rentommy/2026-fpga-dual-channel-ecg/docs/images/prototype_overview.jpg

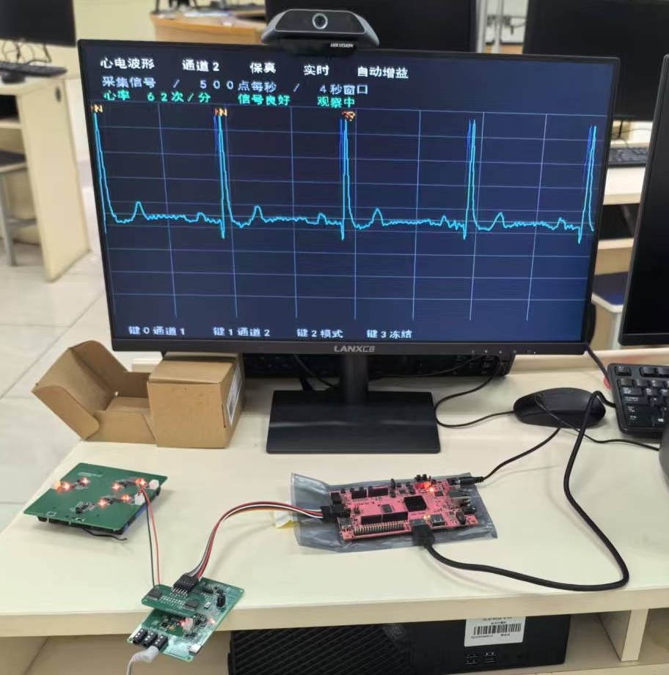
docs/images/prototype_overview.jpg
