rentommy/2026-fpga-dual-channel-ecg/hardware/README.md

# 硬件设计来源快照

acquisition包含现存采集板网表、BOM、Gerber及EDA工程，isolation包含隔离板网表。所有文件按英文路径复制，字节未修改；原文件名映射见file_origin.json。厂商器件手册不重复分发。

这些是工作区最近可找到的设计导出，文件日期不完全一致。尚未确认它们与已经进行人体测试的实物板为同一修订，不能将其表述为“整套硬件已按此版本验收”。隔离板完整PCB/原理图/BOM若不在本快照中，仍需补齐。请在发布前核查BOM/EDA中的团队及制造订单信息。

新增英文归档：acquisition内含两页原理图与PCB图，isolation内含原理图/PCB图/通道分配，power内含独立电源板图。作品现场照片位于docs/images/prototype_overview.jpg。图纸与实物版本的测试边界见技术文档。
