rentommy/2026-fpga-dual-channel-ecg/docs/README.md

# Project documentation

- [Technical report in Chinese](technical_report_zh.docx)
- [AMD poster in English](posters/amd_poster_en.pptx)
- [AMD poster in Chinese](posters/amd_poster_zh.pptx)
- [Prototype photograph](images/prototype_overview.jpg)
- [Build and reproduction guide](reproduce.md)
- [Hardware interfaces](hardware.md)
- [Third-party notices](third_party.md)

Repository paths and filenames use English ASCII. Chinese documents retain their original language. Source-to-public filename mappings are recorded in publication_file_map.json. Schematics and PCB images are in ../hardware/acquisition, ../hardware/isolation and ../hardware/power. The standalone power-board design and two-cell acquisition-board supply are separate design snapshots.
