rentommy/2026-fpga-dual-channel-ecg/hardware/power/README.md

# Standalone power board

Schematic and PCB layout supplied with the project. These are design exports, not evidence of rated-load, efficiency or safety certification tests. They are distinct from the acquisition-board two-cell charging design.
