rentommy/2026-fpga-dual-channel-ecg/report/submission_audit.md

# GitHub提交准备与项目完整性审查

## 结论

已按用户提供的2026 AMD指南自主选题初级组整理独立提交候选：`D:/ecg_fpga/submission/ecg_fpga`。不要直接将整个`D:/ecg_fpga`工作目录上传。原有工程、人体原始数据、录屏、训练数据库与工具缓存保留本地，没有重写Git历史或推送远端。

候选包含src、sim、build、board、data、skill、report等指南推荐目录，另有docs/model/hardware。路径采用英文小写、数字、下划线/连字符，保留指南示例中的README.md/LICENSE惯例。内容可以中文，历史资料中的原工作区路径仅作为来源说明。

## 本次完成

- 更新README，纠正实时/回放状态、PL/ARM分工、延迟定义和验收边界。
- 整理当前ECG6源码、bit/hwh、部署脚本及模型权重，保留兼容预编译和新构建模块层级的运行入口。
- 补从空工程创建PS、SPI、滤波、视频和卷积的构建入口，修复BD打开时IP目录无法刷新导致卷积IP找不到的问题。
- 生成60秒合成滤波输入及黄金结果，公开模型合成输入替代个人心电。用户明确要求人体原始记录保留本地。
- 补独立模型网络定义、best.pt导出及PyTorch/NumPy比较入口；全量训练仅保存来源快照，尚不能完整独立复现。
- skill目录不再为空：报告门控、只读Overlay ABI检查、缓存所有权与分层排错经验均有适用范围、来源、使用方法和失效条件。
- 硬件网表/BOM/Gerber/EDA改用英文路径归档为设计快照，并明确版本不一致与实物对应关系待核查。
- 补大模型协作回溯摘记，保留用户纠正与失败过程，不补造逐字对话或验收结果。

## 本次验证

| 检查 | 结果 | 边界 |
|---|---|---|
| 英文路径/大小/明显凭据/Python语法 | 通过 | 静态检查，不是全面隐私审计 |
| 滤波核C测试 | 通过，合成60秒输入最大误差约2.2码、RMS约0.583码 | 不等同于历史实测输入结果 |
| 顶层C测试 | 通过，8逻辑通道、两路径与逐通道延迟配置 | 不代表8路物理ADC |
| RTL视频/SPI/FIFO/SW0 | 三组测试通过 | 现场信号质量仍依赖供电/电极 |
| 技能包/报告解析 | 正确/错误/缺失证据场景自测通过 | HLS解析自测输出是虚构fixture，不能当作C/RTL协同仿真通过证据 |
| 模型独立导出 | 4组合成输入，PyTorch/NumPy最大logit误差约9.54e-7 | 不是识别准确率 |
| 空工程BD集成 | 通过，完全不打开旧xpr | 使用既有导出HLS IP；未重新跑HLS至bit完整链路 |

## 尚未完成，建议按顺序处理

1. **完整干净构建**：已从空目录完成HLS综合、IP导出、bit/hwh及通过的时序报告；新bit上板待验收。
2. **最终整机验收**：固定供电后做长时真实采集，保存无丢帧/无坏帧与帧率记录；确认增益修复后的上下波形和最新版本断电自启动。此前约30秒恢复检查不是长时验证。
3. **硬件版本与资料**：确认归档的网表、BOM、Gerber、EDA与实际实物同版，补隔离板完整工程；BOM/EDA制造订单与个人信息再审查。
4. **公开发布检查**：TUL板卡文件再分发来源/许可尚需确认，不能套用原创MIT。Digilent依赖已补上游MIT声明。现有Git历史跟踪过`data/source/ecg_60s_500sps.txt`与`ecg_val_60s_500sps.txt`及相关数据；新候选排除个人原始记录不会抹掉旧历史。未经用户确认不执行历史重写/强推。
5. **训练复现与更多对照**：如需要展示完整训练流程，应补齐旧实验划分/基线依赖及数据库路径参数化。公开合成输入的板端FPGA对照尚未运行，C/RTL协同仿真也未验收；现有C/RTL独立验证已满足“仿真或验证证据”的基础范围。
6. **最终材料**：指南第六章要求按AMD模板提供一页英文海报，决赛打印版不含队伍信息。现有海报含姓名，需制作匿名版并更新最终图。后续官方评分细则/报名后台材料要求仍需最终核对。

现阶段可把本目录作为候选进行本地审查或私有备份；不应声称比赛最终材料全部完成。公共发布前先解决许可和旧历史数据检查，比赛提交前完成构建和整机验证。没有测量的临床准确率、整机功耗、端到端时延不填推算数。
