rentommy/2026-fpga-dual-channel-ecg/report/submission_checklist.md

# AMD自主选题初级组提交核查

依据用户提供指南3.3.3–3.3.5及第六章（PDF物理页23–25、28）。本清单不是后续官方评分细则或报名后台要求的替代。

| 要求 | 当前情况 | 剩余工作 |
|---|---|---|
| 指定器件与板级运行 | PYNQ-Z2/XC7Z020已声明，实时采集/推理/HDMI有实测 | 固定电源后长时连续运行，保存新日志 |
| RTL/HLS/PS源码及工程 | 当前源码、预编译bit/hwh已包含 | 已从空目录完整重建通过；新bit上板待验收 |
| 仿真/参考对照 | 滤波C测试、视频/SPI/SW0验证源码、49拍结果和合成向量 | 保存公开合成模型向量的板端FPGA对照结果；C/RTL协同仿真仍未验收 |
| 综合实现与性能对比 | 最新时序/资源报告、窄范围ARM基线对照 | 补统一条件的多心拍基线对照与端到端延迟测量；功耗如未测勿声称 |
| 技能包 | 已补README、报告门控、Overlay检查及缓存工作流 | 换题目/换板卡的复用验证尚未实测 |
| 大模型协作记录 | 历史日志及11月4日补充，包含用户提示与纠错 | 日志是回溯摘记，不伪装完整逐字原始记录 |
| 英文规范路径 | 提交候选使用ASCII；保留README.md/LICENSE惯例 | 发布审查脚本须通过，无凭据、私有录制、超大文件 |
| 开源许可 | 原创代码MIT，Digilent许可保留 | TUL板卡文件来源/再分发许可需确认，不能自动套用MIT |
| 原理图/PCB/BOM | hardware内已按英文归档现有网表、BOM、Gerber及EDA快照 | 确认与实际已制作板卡同版，补隔离板完整工程，检查制造订单/个人信息；器件手册不重复发布 |
| 模型源码与权重 | 已选定权重、配置、推理与训练来源快照 | 全量训练仍依赖旧实验文件和数据库目录，未独立复现 |
| 一页英文海报 | 英文及中文PPT已归档docs/posters | 决赛需按AMD模板去除队伍信息、补最终实测图，A4彩印；中文版本仅辅助 |
| 自启动现场验收 | 旧版本用户曾确认断电启动 | 最新双路与增益修复版断电自动启动待用户实测 |

代码可以先作为候选备份到私人仓库，但不得把未验证项勾成完成。公开发布前优先确认第三方许可、去除本地敏感数据，核对本次干净构建证据。比赛最终提交前还需核对独立发布的官方评分细则与报名后台材料要求。
