rentommy/2026-fpga-dual-channel-ecg/hardware/acquisition/netlist_20261023.txt

$PACKAGES
AUDIO-TH_XKB_PJ-320A ! AUDIO-TH_XKB_PJ-320A ! '{Value}' ; CN2 CN3 CN4 
C0603 ! C0603 ! '1.5nF' ; C14 
C0603 ! C0603 ! '4.7nF' ; C1 C2 C3 C12 C13 
C0603 ! C0603 ! 100nF ; C5 C7 C9 C21 C27 C34 C36 C38 
C0603 ! C0603 ! 10nF ; C23 C28 C30 
C0603 ! C0603 ! 10pF ; C19 C20 
C0603 ! C0603 ! 10uF ; C4 C6 C8 C26 C32 C33 C41 C42 C47 C50 C52 
C0603 ! C0603 ! 1uF ; C11 C15 C16 C22 C24 C25 C29 C31 C35 C37 C39 C40 C46 
C0603 ! C0603 ! 20pF ; C17 C18 
C0603 ! C0603 ! 22uF ; C44 C45 C51 
C0603 ! C0603 ! 47nF ; C48 
C0805 ! C0805 ! '4.7uF' ; C49 
CASE-A_3216 ! CASE-A_3216 ! 1uF ; C10 
CONN-TH_2P-P2.50_HC-XH-2A-G ! CONN-TH_2P-P2.50_HC-XH-2A-G ! '{Value}' ; CN1 
,
        CONN-TH_2P-P2.50_HX-2.54MM-2P-ZZ-MS ! CONN-TH_2P-P2.50_HX-2.54MM-2P-ZZ-MS ! '{Value}' ,
        ; CN7 
,
        CRYSTAL-SMD_4P-L3.2-W2.5-BL_SIT8008BI ! CRYSTAL-SMD_4P-L3.2-W2.5-BL_SIT8008BI ! 8MHz ,
        ; X1 
HDR-TH_16P-P2.54-V-M-2 ! HDR-TH_16P-P2.54-V-M-2 ! '{Value}' ; H2 H3 
,
        HDR-TH_18P-P2.54-V-M-R2-C9-S2.54 ! HDR-TH_18P-P2.54-V-M-R2-C9-S2.54 ! '{Value}' ,
        ; H5 
HDR-TH_2P-P2.54-V-M ! HDR-TH_2P-P2.54-V-M ! '{Value}' ; H1 
HDR-TH_4P-P2.54-V-M ! HDR-TH_4P-P2.54-V-M ! '{Value}' ; H7 
,
        HDR-TH_6P-P2.54-V-M-R2-C3-S2.54-2 ! HDR-TH_6P-P2.54-V-M-R2-C3-S2.54-2 ! '{Value}' ,
        ; H4 H6 
IND-SMD_L2.0-W1.2_PCT201210 ! IND-SMD_L2.0-W1.2_PCT201210 ! 1uH ; L2 
L0805 ! L0805 ! '{Value}' ; L1 
L1008 ! L1008 ! '2.2uH' ; L3 
LED_0603 ! LED_0603 ! '{Value}' ; LED1 LED2 LED3 LED4 
LED0603-RD_RED ! LED0603-RD_RED ! '{Value}' ; LED5 LED6 
,
        LQFP-48_L7.0-W7.0-P0.50-LS9.0-BL ! LQFP-48_L7.0-W7.0-P0.50-LS9.0-BL ! '{Value}' ,
        ; U5 
OSC-SMD_L3.2-W1.5 ! OSC-SMD_L3.2-W1.5 ! '32.768kHz' ; X2 
R0603 ! R0603 ! '100kΩ' ; R7 R8 R9 R11 R12 R13 R14 R15 R16 R38 
R0603 ! R0603 ! '10kΩ' ; R17 R18 R32 R33 R34 R35 R36 R37 
R0603 ! R0603 ! '1MΩ' ; R10 
R0603 ! R0603 ! '30.1kΩ' ; R42 
R0603 ! R0603 ! '383Ω' ; R39 
R0603 ! R0603 ! '5.1K' ; R26 R27 R30 R31 
R0603 ! R0603 ! '5.23kΩ' ; R43 
R0603 ! R0603 ! '51kΩ' ; R1 R2 R3 R4 R5 R6 
R0603 ! R0603 ! 10 ; R22 
R0603 ! R0603 ! 10K ; R19 R20 R21 R25 
R0603 ! R0603 ! 1K ; R28 R29 
R0603 ! R0603 ! 2K ; R23 R24 
SOIC-8_L4.9-W3.9-P1.27-LS6.0-BL ! SOIC-8_L4.9-W3.9-P1.27-LS6.0-BL ! '{Value}' ,
        ; U8 
,
        SOT-23-5_L2.9-W1.6-P0.95-LS2.8-BR ! SOT-23-5_L2.9-W1.6-P0.95-LS2.8-BR ! '{Value}' ,
        ; U3 U6 U7 
,
        SW-SMD_L6.0-W3.3-LS8.0_TS-1101-C-W ! SW-SMD_L6.0-W3.3-LS8.0_TS-1101-C-W ! '{Value}' ,
        ; SW1 
TH-2_103AT-2 ! TH-2_103AT-2 ! '{Value}' ; R41 
,
        TQFN-16_L3.0-W3.0-P0.50-BL-EP1.7 ! TQFN-16_L3.0-W3.0-P0.50-BL-EP1.7 ! '{Value}' ,
        ; U2 
,
        TQFP-32_L5.0-W5.0-P0.50-LS7.0-BL ! TQFP-32_L5.0-W5.0-P0.50-LS7.0-BL ! '{Value}' ,
        ; U1 
,
        TYPE-C-SMD_LAIL-TYPE-C-16PIN-08-WT ! TYPE-C-SMD_LAIL-TYPE-C-16PIN-08-WT ! '{Value}' ,
        ; USB1 USB2 
,
        VFQFPN-24_L4.0-W4.0-P0.50-BL-EP2.8 ! VFQFPN-24_L4.0-W4.0-P0.50-BL-EP2.8 ! '{Value}' ,
        ; U10 
WSON-8_L2.0-W2.0-P0.50-TL-EP ! WSON-8_L2.0-W2.0-P0.50-TL-EP ! '{Value}' ; U9 
$A_PROPERTIES
$NETS
'-D' ; U10.1 USB2.A7 USB2.B7 
'+5V' ; C16.2 C25.2 C32.1 C33.1 CN1.1 H1.1 U6.1 U6.3 U7.1 U7.3 
'+D' ; U10.24 USB2.A6 USB2.B6 
'$1N14' ; CN4.2 CN4.5 R2.1 
'$1N144' ; LED1.1 R23.1 
'$1N145' ; LED2.1 R24.1 
'$1N19' ; CN2.2 CN2.5 R4.1 
'$1N198' ; H6.4 R21.1 
'$1N201' ; H6.3 R20.2 
'$1N208' ; C22.1 R22.2 U5.9 
'$1N351' ; CN3.3 R5.1 
'$1N353' ; CN2.3 R3.1 
'$1N355' ; CN4.3 R1.1 
'$1N376' ; CN3.5 
'$1N377' ; CN3.2 R6.1 
'$1N81' ; R25.1 U1.17 
'$2N127' ; L3.1 U9.7 
'$2N128' ; C51.1 H1.2 L3.2 R38.1 U9.6 
'$2N18' ; R26.2 USB1.A5 
'$2N195' ; LED5.2 R33.2 
'$2N24' ; R27.2 USB1.B5 
'$2N29' ; C34.2 C35.2 U2.6 
'$2N44' ; LED3.2 R28.1 
'$2N45' ; LED4.2 R29.1 
'$2N52' ; R31.2 USB2.B5 
'$2N57' ; R30.2 USB2.A5 
'3.3V1' ; C23.2 C24.2 C26.1 C27.2 C28.2 C29.2 C30.2 C31.2 H4.1 H4.3 H4.5 H5.10 ,
        H6.1 H6.2 H7.4 LED1.2 R19.2 R22.1 R32.1 R33.1 R34.1 R35.2 R36.2 R37.2 ,
        U5.1 U5.24 U5.36 U5.48 U7.5 U8.1 
'3.3VA' ; C4.2 C5.2 L1.2 R12.1 U1.12 
'3.3VD' ; C6.2 C7.2 C15.2 H5.9 L1.1 LED2.2 R15.1 R16.1 U1.14 U1.23 U6.5 
'5_V' ; C36.2 C37.2 C40.2 C42.1 U2.3 U2.9 U3.1 U3.3 USB1.A4B9 USB1.B4A9 
'CS#' ; H5.13 R15.2 U1.18 
'D-' ; U2.8 USB1.A7 USB1.B7 
'D+' ; U2.7 USB1.A6 USB1.B6 
'DRDY#' ; H5.3 U1.22 
'GPIO1/RCLK1' ; R18.2 U1.26 
'GPIO1/RCLK2' ; R17.2 U1.25 
'PWDN#/RESET#' ; H5.17 R13.2 U1.15 
'RLDIN/RLDREF' ; R11.2 R12.2 U1.29 
3V3 ; C38.2 C39.2 C41.1 R28.2 R29.2 U2.1 U3.5 U8.8 
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
RST ; C21.2 R19.1 SW1.1 U5.7 
RXD ; LED4.1 U2.5 U8.6 
SCLK ; H5.5 U1.20 
START ; H5.15 R14.2 U1.16 
STAT ; LED5.1 U10.2 
SW ; C48.1 L2.2 U10.17 U10.18 
TS ; R41.2 R42.1 R43.2 U10.7 
TXD ; LED3.1 U2.4 U8.7 
VCAP1 ; C10.2 U1.11 
VCAP2 ; C11.1 U1.27 
VREFP ; C8.1 C9.1 U1.9 
$SCHEDULE
$END
