rentommy/2026-fpga-dual-channel-ecg/report/llm_log/2026-10-23.md

# 大模型协作记录 2026-10-23

整理日期：2026-10-23。协作方：用户与GPT／Codex。根据本次会话、项目报告及真实板上输出整理；跨日复位修复按事件连续记录，不补造未保存的逐条时间。

## 1. 用户配合重启，完成修复后的最小板上链路

用户确认板卡重新开机，并要求继续。模型核对修复版bit／hwh哈希，再执行控制读取、单点零输入、完整记录分块回放。此次控制返回 `0x4`，单点输入得到八通道双通路全零输出，首次控制访问卡死问题消除。

| 板上检查 | 结果 |
|---|---|
| 输入 | 30034点单列记录，复制至8通道 |
| 分块 | 500点、4096点，两次仅首块复位 |
| 参考比对 | 跳过543点，诊断配置通道最大误差3.28984码、RMS 0.698013码 |
| 状态连续性 | 两次完整 `[30034,8,2]` 输出逐点完全相同 |
| 结果取回 | ZIP哈希／完整性及本地NPY复算通过 |

ch2／ch3的path0按现行配置为快通路，未纳入诊断浮点参考比较。板上环境为PYNQ-Z2、PYNQ 3.1.1、Python 3.10.4；系统时钟仍显示2025年，不能把Notebook检查点时间当作实际执行日期。

证据：[实现及修复报告](../history/implementation_2026-10-22.md)、`board/results/resetfix/`、`board/results/ecg_board_results_resetfix_20261022.zip`。这是文件回放，不是实时ADC采集。

## 2. 用户要求不同通道激励，补上原测试覆盖缺口

原先所有通道送同一波形，即使输出一致，也可能漏掉错误复制同一路结果的缺陷。用户要求不同通道测试后，模型增加4096点×8通道混合输入：冲激、5Hz、17Hz、阶跃、50Hz、有界随机、周期脉冲和零哨兵；输入峰值120000码。

主机参考逐通道调用同一份定点核心，不经过AXI顶层；板上检查全部样本，包括启动期。20项检查全通过：

- 混合输出对定点参考逐点一致，最大差0码；零哨兵通道两路全零。
- 8组逐通道单独激励，其他7通道两路均保持零；活动通道对照通过。
- 不规则分块 `[1,7,319,320,321,500,997]` 与整块一致。
- 其他记录之后重新复位，首轮结果可复现。

这验证指定向量下的数字通道隔离及状态管理；同代码定点参考不是独立浮点算法，也不证明模拟串扰或任意满量程输入正确。证据：[通道测试报告](../history/channel_test_2026-10-23.md)、`board/results/channel_test_20261023/`。

## 3. 用户补充STM32源码，时钟判断落到实际编译文件

用户说明PWDN／RESET为复用脚、DVDD为3.3V、SPI经过数字隔离，并提供 `stm32文件/`，要求确认时钟。模型查看Keil工程选择，确认实际编译 `Core/Src/main.c`，不是旁边的 `main2.c`。

核对结果：HSE8MHz×9得到72MHz；APB2为72MHz，SPI1分频128，SCLK562.5kHz；CPOL0、CPHA1，即Mode1。`CONFIG1=0x02` 对应当前500SPS配置，`CONFIG2=0xA0` 启用内部基准且CLK_EN=0。

源码关于时钟分频的注释不足以证明内部时钟被选择：`LOFF_STAT.CLK_DIV=0` 规定分频，真正内部／外部源由硬件CLKSEL决定。未提供原理图，不能宣称实际CLKSEL接法已确认。沿用旧采集板时先保留其既有CLKSEL／CLK配置。

另发现旧程序 `CH1SET=0x81`，CH1关闭，仅CH2有效，并输出帧中CH2单列；不能把旧串口记录当双通道同步输出。证据：[时钟及接线核查](../history/ads1292_wiring_2026-10-23.md)。

## 4. 用户确定连接方案，并提出HDMI与按钮需求

用户询问是否要购买Pmod A连接器，要求生成比特流、通过HDMI显示波形，并用板载按键选择通道。随后澄清隔离器HOST侧尚未设计，显示器还没买。

因此本次固定PYNQ现有Pmod A插座的7根信号加HOST地分配，新隔离板可做2×6、2.54mm公头；隔离方向为五路去、两路回。模型整理接线表、供电和两侧地边界，避免把数字隔离后的HOST地跨接到采集侧。

真实采集与显示画面的验收依赖后续硬件，本次先实现完整逻辑、仿真及合成数据上板演示。上述需求和硬件条件来自用户；SPI状态机、驱动和显示实现由模型编写，TMDS编码采用Digilent官方 `rgb2dvi` IP并保留来源及许可证记录。

## 5. 新增SPI、FIFO、显示与按键功能

新版本保持滤波算法不变，增加Mode1 SPI主机、手动寄存器交易、DRDY自动读取、1024帧FIFO、帧头／溢出计数，以及两路24位符号扩展数据。100MHz下SCLK约561.798kHz，接近旧固件频率。运行程序提供demo、ADC内部测试信号、真实ADC三种来源，默认demo不发送ADC命令。

视频为640×480@60Hz，四秒波形窗口、自动纵轴、CH1／CH2及DIAG／FAST选择。BTN0选CH1，BTN1选CH2，BTN2切通路，BTN3冻结／恢复；约20ms消抖。PS约10Hz更新波形，PL60Hz扫描，不把这些刷新率描述成实测端到端延迟。

产物包括 `src/rtl/` 中SPI／AXI／视频模块、`board/run_scope.py`、构建脚本、XDC、使用指南及 `board/scope/ecg_scope.bit/.hwh`。现版没有全帧双缓冲，可能短暂撕裂。

## 6. 本轮实现中的失败与修正

| 现象／错误 | 定位与修正 | 验证依据 |
|---|---|---|
| 模块引用构建找不到字体包含文件 | 将 `.vh` 显式加入工程 | 后续综合成功 |
| XDC里使用任意Tcl循环，约束未按预期接受 | 改成逐项 `set_property` | 最终引脚与实现报告 |
| 时钟向导按外部时钟输入形式配置 | FCLK内部输入改为 `No_buffer` | 保存BD／HWH及后续实现 |
| 首次完整scope布线setup为−0.238ns | 导出程序拒绝发布；物理优化及重布线 | 最终setup +0.041ns、hold +0.023ns |
| 重新打开工程未先登记板文件库 | 后续打开脚本先设置repo并恢复board_part | 元数据重新导出日志 |
| BD导出脚本早于最终配置 | 从保存的最终BD重新生成 | `scope_refresh.log` |

旧引脚ZIP也重新打包，避免继续分发早期无效XDC。最终采用修改后的产物，未把时序失败的首版bit当成成功发布。DRC仍保留建议性警告，未通过关闭规则隐藏问题。

## 7. 新版本的仿真、实现及板上结果

RTL自检覆盖AXI地址／数据先后顺序及背压、SPI Mode1字节序、FIFO读写／溢出／坏帧、按钮消抖与显示选择；视频仿真验证完整307200像素帧及通道／通路／冻结bank。两张预览由真实RTL渲染，但不是显示器照片。

最终实现100MHz核心、25.2MHz像素、126MHz串行时钟；LUT6751、FF9665、DSP1、BRAM Tile17。setup +0.041ns、hold +0.023ns，内部未约束端点及无时钟端点均为0；DRC无Error／Critical Warning，仍有8项Warning。隔离器规格尚未确定，外部GPIO电气时序不能据此全部验收。

新bit／hwh上传后核对哈希，板上执行：

| 检查 | 实际结果 |
|---|---|
| 30034点×8通道×2通路回放 | PASS，最大误差3.28984码、RMS0.698013码 |
| 新增AXI标识与8种UI状态读写 | PASS |
| 合成双通道演示 | 各4000点，约8秒，无程序错误 |
| ADC错误计数 | 演示模式下溢出0、坏帧0；不代表真实ADC链路已验 |
| 实物HDMI／ADC／按键实按 | 未测试 |

HPD读值为1，但用户明确没有显示器，故只记录原始值，不认定连接或出图成功。演示结束冻结最后波形，重启后需重新运行，没有安装开机自启。

证据：[构建与验收报告](../history/scope_build_2026-10-23.md)、接线运行指南（原工作区引用：`../../board/SCOPE_GUIDE.md`，未随此公共候选发布）、`board/scope/build_manifest.json`、`board/scope/board_acceptance.json`及页面截图。发布包为 `board/ecg_scope_20261023.zip`，板上Notebook为 `ECG_Scope_Start_20261023.ipynb`。

## 8. 用户要求补齐协作日志

用户指出此前Claude尚有未整理内容，要求从已提供的旧对话补充。模型复查旧转录和现有日志，新增10-20（日期推定）、10-21、10-22、10-23记录及目录索引；保留原始转录、原有十份日志，不补造隐藏段或把待办当成果。

当前仍需隔离器HOST侧设计、真实ADC内部测试及外部输入、物理按键、实体HDMI画面、PYNQ推理及完整应用验收。现阶段完成的是滤波核心板上回放、指定向量通道验证、新版显示与采集逻辑的实现／仿真和演示链路，并非完整竞赛作品全部闭环。

## 9. 新增两块板网表后的设计检查

用户提供采集板、隔离板网表，确认U6/H5同号直接对插，并补充采集板U6/U7为TPS7A2033PDBVR、U8为ISO6521FDR。模型发现隔离板四个VCC脚只经电容接电源，缺少直流供电；全针插接又经H5.1/H5.2同一GND旁路新隔离器，并将PYNQ输出接回原STM32输出、并接两路3.3V。

七根隔离信号方向本身正确，但新设计Side1=ADC、Side2=HOST，与先前示例相反，不能混用侧别。提出保留采集板H5奇数脚，隔离板U6偶数脚全部不接HOST网络的方案；Pmod公头使用CAD交错编号，几何映射仍待封装图核查。

新网表还补齐时钟证据：ADS1292 CLKSEL接DVDD，选择内部标称512kHz。采集板两颗LDO脚位及U8串口方向核对一致；U8属于功能隔离器，不能当作增强绝缘。完整发现、修正表及原始连接证据见[网表检查报告](../history/netlist_review_2026-10-23.md)。原始网表未改写、未执行真实上电，需用户在原理图修改后重导验证。

用户随后更新网表，并明确暂不要求STM32隔离兼容、不会同时使用两台主机。第二版确认四个电源／去耦问题已修正；U6/H5全针插接的地线旁路和HOST电源回接仍存在，不受是否运行STM32影响。模型将建议收窄为断开隔离板U6全部偶数脚、保留奇数脚及Pmod连接，不要求添加双主机切换电路。见[第二版复查](../history/netlist_review_2026-10-23_v2.md)。

## 10. 根目录文件整理

用户要求整理直接放在项目根目录的文件。两条有效HLS入口移至src/hls，并增加根据脚本位置定位根目录的前缀；七条历史尝试原样归档old/hls_attempts；NA下PS7报告移至build/reports。已存在的HLS组件目录因被Vivado引用而保留原位，移动清单与校验见[文件整理记录](../history/organization_2026-10-23.md)。本次不重新综合或加载板卡。

## 11. 第三版隔离网表复查

后续用户取消隔离板全部STM32支路及SW2，保留U6采集侧偶数脚、奇数脚全部NC。最新网表的供电去耦、七信号方向、主机侧不回接STM32均检查通过；仍以换面后的真实针号对应和PCB隔离边界核对为条件，无需为当前PYNQ用途修改采集板GND。见[简化版复查](../history/netlist_review_pynq_2026-10-23.md)。

用户随后明确U6换面安装，有意交换方向，并排除本次STM32隔离模式。模型修正此前同号对插假设：若实际逐对奇偶交换，采集侧九根连接正确，不能再要求按旧表交换回去。当前只保留PYNQ用途所需检查：SW2电源触点断开、Pmod侧不经现有STM32引脚支路跨回采集侧，以及真实封装映射确认；未来割地不能当作现有网表已隔离的证据。

四个供电去耦仍正确，U6奇偶列却整体交换，并增加SW2。按此前同号对插约定，ADC的DRDY/DOUT会接到隔离器HOST输出，SW2若连通1—2还会并接HOST与ADC电源。模型保留“如果封装／实际针号对应发生变化则需重新确认”的条件，没有只凭网表猜测新物理对接关系，见[第三版网表复查](../history/netlist_review_2026-10-23_v3.md)。
