rentommy/2026-fpga-dual-channel-ecg/report/llm_log/2026-10-25.md

# 大模型协作记录 2026-10-25

用户更新采集板网表并提供BQ25882、TPS62163手册，要求检查新原理图。模型逐项核对U4的25个球位、U9含热焊盘的9个焊盘、主要外围及与旧ADC／STM32和隔离板的连接，并查看手册引脚图与典型电路。

发现GND2（新充电／降压／电池）与GND（ADC／STM32负载）没有连接，但+5V输出跨两网供电，因此缺少明确回流，是必须修正的问题。CN1与降压输出直接并联；用户澄清CN1只用于后级测试，模型据此将要求收窄为测试时物理断开降压输出，不要求增加自动双电源模式。

用户补充电池为2串、标称7.4V、1200mAh且带保护板。允许充电电流及均衡能力仍未知，不能因有保护板就认定充电参数适配。模型核对CE被10k上拉、现有固件尚未实现BQ25882/I2C控制，区分“接法错误”与“默认禁止充电但需软件主动使能”。R32=1.1k控制USB输入限流，典型约0.986A，不是固定电池充电电流。

确认TPS62163固定5V版本的FB接地正确，不按可调版误要求添加分压。确认TS分压与参考拓扑一致，保留电感额定电流、电容偏压降额、BGA方向、Kelvin走线、散热及布局的待核查边界。

完整检查与逐针证据在[新采集板电源检查](../history/acquisition_power_review_2026-10-25.md)及同名JSON。未改原始网表或固件，未通电或充电，不把静态检查写成实物验收。

用户随后更新网表：合并采集侧GND2/GND，新增H1将降压本地输出与CN1后级测试网分开。模型重新检查25球／9焊盘、地网和C51/VOS，确认修正正确，断开H1时降压本地输出电容和反馈仍完整。主要连接检查通过，可以进入BOM及PCB核对；保留充电控制、料号额定、物理布局和上电验证边界。见[第二版复查](../history/acquisition_power_review_2026-10-25_v2.md)。
