rentommy/2026-fpga-dual-channel-ecg/report/history/design_phase1.md

# 阶段一：滤波链结构与定点格式的确定

> 日期：2026-09-30
> 这一章对应指南 3.3.5.3 里的"软硬件划分依据"和"优化过程"，
> 也是"把设计过程中的判断依据写进报告，而不只是呈现结果"这条要求。

> **⚠️ 本章记录的是阶段一的链路，部分结论已在 `design_phase2.md` 中被推翻。**
> 读之前请先看 `design_phase2.md` §0 的对照表。具体地：
>
> - §1 定下的验收指标（平均心拍模板相关）**已作废** —— 它对基线漂移和幅度都盲，见阶段二 §4
> - §2.1 的移位级联直流阻断**已被取代** —— 改用矩形窗基线估计 + 延迟补偿，见阶段二 §3
> - §3 "定稿配置的验收"里的数字对应**旧链路**，现行定稿的验收表在阶段二 §5
> - §2.0 时间预算、§2.2 陷波 Q、§2.3 系数位宽、§2.4 FIR 抽头数**仍然有效**，一个数都没动
>
> 本章不做修改，保留作决策过程的记录 —— 优化过程本身是评分项。

所有数字都来自 `sim/` 下的三个脚本，跑在同一份 60 秒真人实测数据
（`data/source/ecg_60s_500sps.txt`，ADS1292 采集，500 SPS）上，可复现。

数据分三种用途，不要混淆：

| 数据 | 用途 | 出现在 |
|---|---|---|
| **实测原始数据** | 结构选型、**最终验收** | `data/input_raw.txt` + `golden_float.txt`，HLS 三级比对全程用它 |
| 实测数据 + 单频注入 | **参数扫描**（扫出 k、级数、Q 的边界） | 只在 `decide_dc_block.py` 内部，不进测试向量 |
| 合成退化输入 | 抓实现错误（系数装反、某级没接上） | `testcase_impulse.txt`、`testcase_50hz.txt` |

注入数据**一行都没有进过测试向量**。验收标准全部建立在实测数据上。

---

## 1. 为什么不能直接把原来的滤波链搬到硬件

上位机原来用 `scipy.signal.sosfiltfilt` —— 正反各滤一遍，零相移，QRS 不偏移。

**硬件做不到。** 反向滤需要先拿到整段数据，实时链路里数据一个一个来，
永远拿不到"后面的数据"。所以硬件必须是单向（因果）滤波。

这一步换掉之后，还带来一个连带问题：**不能再用全局相关系数验收**。
单向 IIR 的相位失真随频率变化，不是一个固定延迟，平移多少都对不齐：

| 链路 | 与零相移参考的全局相关 r |
|---|---|
| 原版结构改单向 `sosfilt` | 0.589 |
| 硬件三级链路 | 0.64 ～ 0.74 |

r 只有 0.6 并不说明波形被毁了。改用**按 R 波对齐后的平均心拍模板相关**
才能反映真正在乎的东西——P-QRS-T 形态有没有被破坏。
验收指标因此定为：QRS 幅度误差、心率、检出心拍数、心拍形态相关，
以及最终的模型判读是否一致。

---

## 2. 三级结构，按硬件代价从小到大排

| 级 | 实现 | 每通道每采样点的乘法**次数** |
|---|---|---|
| ① 直流阻断（去基线漂移） | 移位式一阶高通，级联 2 级 | **0** |
| ② 50Hz 陷波 | 二阶 biquad，直接 I 型 | 5 |
| ③ 40Hz 低通 | 31 抽头对称 FIR，折叠 | 16 |
| | **合计** | **21** |

### 2.0 先算时间预算，再定架构

上面是乘法**次数**，不是乘法**器个数**。这两者在低采样率下差了两个数量级，
所以架构必须先从时间预算倒推，不能直接把次数当成器件数。

```
采样率            500 SPS
PL 时钟           100 MHz
每个采样周期       1e8 / 500 = 200,000 个时钟周期

8 通道每个采样周期的乘法次数   21 × 8 = 168 次
```

**200,000 个周期里只需要完成 168 次乘法。** 一个 DSP48E1 按每周期一次算，
占用率 0.084%，时间裕量超过 1000 倍。

因此本设计采用**资源共享（时分复用）架构**：

| | 全并行 | **时分复用（本设计）** |
|---|---|---|
| DSP48E1 | 168（占器件 76%） | **1～2** |
| 系数存储 | 分布式逻辑 | 一个系数 ROM |
| 通道状态 | 寄存器 | BRAM |
| 可扩展通道数 | 8（受 220 个 DSP 限制） | 受 BRAM 和时间预算限制，可达数十路 |

**为什么不用全并行**：指南"优化目标"要求"合理使用片上资源，
**避免以显著的资源代价换取有限的性能收益**"。在 500 SPS 下全并行会把
器件 76% 的 DSP 用在 0.084% 的实际计算量上，正是这条要避免的情形。

HLS 里用 `#pragma HLS ALLOCATION` 限制乘法器实例数来实现共享，
循环不做完全展开。II 和资源的权衡数据在阶段二给出。

> 本节是阶段二开始前对架构的修正。初版曾按"21 个乘法器 × 8 通道 = 168 个 DSP"
> 规划全并行结构，没有先核算时间预算 —— 那个估算把"乘法次数"直接当成了
> "乘法器个数"。在 500 SPS 这个量级上这是个数量级的错误，在此更正。

### 2.1 直流阻断为什么用移位而不是 IIR 高通

```c
acc += (x - acc) >> DC_SHIFT;    // acc 跟踪慢变分量（直流 + 基线漂移）
y    = x - acc;                  // 减掉它
```

一个减法器 + 一个移位 + 一个累加器，**零乘法器**（移位在 FPGA 里就是接线）。
截止频率 `fc = fs / (2π·2^k)`，k 是编译期常数。

代价是单级只有一阶（−20 dB/十倍频），而原来的三阶巴特沃斯是 −60 dB/十倍频。

**为什么用注入正弦而不是直接用实测漂移。** 先把实测数据里的漂移量出来：

| 基线漂移（0.05–0.5 Hz） | 实测数据 | 2 mV / 0.2 Hz 注入 |
|---|---|---|
| RMS | 1.008 mV | 1.414 mV |
| 峰峰 | **6.613 mV** | 4.000 mV |
| 0.2 Hz 单频分量 | 0.252 mV | 2.000 mV |

**实测数据的漂移并不小 —— 峰峰值比注入还大。** 所以注入的目的不是"让输入更脏"。

关键在于两者的**形态不同**。实测在 0.05–0.5 Hz 内没有哪个单频超过 0.252 mV，
但频带 RMS 有 1.008 mV、峰峰 6.613 mV —— 说明实测漂移是**偶发的大幅摆动**
（动一下、深呼吸一次），能量散在整个频带，不是某个频率上的稳态振荡。

| | 实测 | 2 mV / 0.2 Hz 注入 |
|---|---|---|
| 形态 | 偶发瞬态摆动 | 持续稳态正弦 |
| 能测出什么 | **瞬态恢复**行为 | **稳态衰减**（可算 dB） |
| 强度 | 固定（只有这一份数据） | **可调，能扫边界** |

陷波器和高通的衰减指标（dB）只能用稳态正弦测出来；而 k 与级数的权衡表
需要在多个强度下比较。这两件事实测数据都做不到，所以必须注入。

反过来，**实测的偶发摆动测的是注入测不到的东西**，所以两者都要留，
验收仍然以实测数据为准（见开头的数据用途表）。

注入 2 mV / 0.2 Hz（真实呼吸频率量级）实测：

| 配置 | 等效阶数 | fc (Hz) | 残留漂移 (mV) | 乘法器 |
|---|---|---|---|---|
| 三阶巴特沃斯 0.5 Hz（原方案，作为目标） | 3 | 0.500 | 0.118 | 5 |
| 移位 k=7，1 级 | 1 | 0.622 | 0.559 | 0 |
| **移位 k=7，2 级（定稿）** | **2** | **0.622** | **0.171** | **0** |
| 移位 k=7，3 级 | 3 | 0.622 | 0.052 | 0 |
| 移位 k=6，2 级 | 2 | 1.243 | 0.045 | 0 |
| 移位 k=8，3 级 | 3 | 0.311 | 0.291 | 0 |

**级联是免费的**（每级仍然零乘法器），所以单级的一阶不足不是问题。

选 k=7 两级而不是三级，是因为高通角频率抬高会在 QRS 前后产生过冲、
压低 ST 段，这是心电里有临床含义的失真：

| 配置 | 残留漂移 mV | QRS 幅度 mV | 相对真值误差 |
|---|---|---|---|
| k=8 × 3 级 | 0.291 | 1.159 | +0.6% |
| **k=7 × 2 级（定稿）** | **0.171** | **1.174** | **+1.9%** |
| k=7 × 3 级 | 0.052 | 1.199 | +4.0% |
| k=6 × 2 级 | 0.045 | 1.199 | +4.1% |

（QRS 真值 1.152 mV，来自干净数据上的零相移参考链）

k=7×2 级在"漂移抑制"和"波形保真"之间最平衡，而且 fc=0.622 Hz
最接近原设计的 0.5 Hz。**级数是编译期参数，实际佩戴时漂移更大就改成 3 级，
不用改任何硬件结构。**

### 2.2 陷波器 Q 值

实测数据里 50 Hz 只剩 1.9 µV（RLD 修好之后），陷波器无从验证，
因此**人为注入 224 µV** —— 这是修复前实测到的真实工频干扰水平。

**这里的余量是刻意留的，理由要写清楚。** 224 µV 比当前实测高 118 倍，
不是因为现在有这么大的干扰，而是因为采集前端的隔离状态会变：

| 条件 | 50 Hz 谱峰（实测） | 能否采到 |
|---|---|---|
| 无隔离 + 接市电 | 68.59 | 采不到 |
| 无隔离 + 电池供电 | 18.86 | 采不到 |
| 加数字隔离芯片 | 2.23 | 成功 |

当前 1.9 µV 是"采集板电池供电 + 已加隔离"下的结果。而 **ADS1292 → PYNQ-Z2
的隔离方案尚未实施**（见风险①），一旦退回无隔离状态，50 Hz 会回到数十 µV 以上。
陷波器按修复前的 224 µV 设计，是为这种情况预留能力，**不是对当前干扰水平的描述**。

| Q | 带宽 Hz | 极点半径 | 50Hz 衰减 dB | 45Hz 保留 | 55Hz 保留 |
|---|---|---|---|---|---|
| 10 | 5.00 | 0.96905 | −64.8 | 0.903 | 0.887 |
| **15（定稿）** | **3.33** | **0.97927** | **−65.3** | **0.953** | **0.945** |
| 20 | 2.50 | 0.98441 | −65.8 | 0.973 | 0.968 |
| 30 | 1.67 | 0.98958 | −66.9 | 0.988 | 0.985 |

双精度系数下四个 Q 值衰减几乎一样（都够用），差别在两头：
Q 小则邻近频段被削得多，Q 大则极点贴近单位圆、定点难做。

**定点量化后差别就出来了**（见 2.3），Q=15 的极点半径最小，最抗量化，
而它削掉的 45/55 Hz 那 5% 会被后面的 40 Hz 低通再压一遍，实际无影响。

### 2.3 系数位宽

陷波器的 `b1 = a1 = -2cos(2π·50/500) = -1.585`，**整数位必须留 2 位**，
所以不能用 Q1.15。注入 224 µV 工频后实测：

| Q | 小数位 | 存储位宽 | 格式 | 50Hz 衰减 dB | 一个 DSP48 装得下 |
|---|---|---|---|---|---|
| 15 | 12 | 14 | Q2.12 | −45.5 | √ |
| 15 | 14 | 16 | Q2.14 | −68.9 | √ |
| **15** | **16** | **18** | **Q2.16（定稿）** | **−61.9** | **√** |
| 15 | 18 | 20 | Q2.18 | −71.5 | × |
| 20 | 14 | 16 | Q2.14 | −57.3 | √ |
| 20 | 16 | 18 | Q2.16 | −65.0 | √ |
| 30 | 14 | 16 | Q2.14 | −56.6 | √ |
| 30 | 16 | 18 | Q2.16 | −62.8 | √ |

**这张表里有一个陷阱**：Q=15 配 Q2.14（16 位）测出 −68.9 dB，
比 Q2.16（18 位）的 −61.9 dB 还好。这是**舍入的偶然结果，不是规律**——
换成 Q=20 或 Q=30，Q2.16 就明显优于 Q2.14。按这种运气选格式，
以后改采样率或工频频率就会失效。

定稿选 **18 位**，理由是工程性的而非数值性的：
**DSP48E1 是 25×18 有符号乘法器，18 位正好是系数端口的原生宽度**，
用 18 位不比用 16 位多占任何资源，精度却高 4 倍，且对参数变化不敏感。

**位宽和小数点位置是两个独立的决定**：18 位由 DSP48E1 的端口宽度定，
小数点位置由系数的大小定。可表示范围 = ±(2¹⁷−1) / 2^FRAC = ±131071 / 2^FRAC。

| | 系数最大绝对值 | 格式 | 可表示范围 | 用掉量程 |
|---|---|---|---|---|
| 陷波器 | **1.5848**（= \|b1\| = \|a1\|） | Q2.16 | ±2.000 | 79% |
| FIR | **0.1594** | Q1.19 | ±0.250 | 64% |

陷波系数超过 1，必须留整数位，所以 FRAC 最多只能到 16。FIR 系数是纯小数，
整数位一位都不用留，FRAC 可以给到 19 —— **小数点右边多 3 位，量化步长细 8 倍**。

> 注：1.5848 是 `iirnotch` 归一化后的实际系数（除以了 1+α）。
> 未归一化的 −2cos(2π·50/500) = −1.6180 是推导中间量，不是存入硬件的值。
> 头文件里 `NOTCH_B1 = −103864`，−103864 / 2¹⁶ = **−1.5848**，与此处一致。

纯 50 Hz 正弦单音测试（输入 262144 码）：**输出残留 25.9 码 = −80.1 dB**。
真实数据上测出的 −61.9 dB 是测量底噪限制——真实心电本身在 50 Hz 处有能量，
不是滤波器的真实衰减。

### 2.4 FIR 抽头数

| N | 乘法次数（折叠） | 群延迟 ms | 50Hz 衰减 dB | 100Hz 衰减 dB | QRS mV | 相对真值 |
|---|---|---|---|---|---|---|
| 15 | 8 | 14 | −8.1 | −54.2 | 1.052 | **−8.7%** |
| 23 | 12 | 22 | −11.3 | −54.8 | 1.082 | −6.1% |
| **31（定稿）** | **16** | **30** | **−13.9** | **−55.0** | **1.145** | **−0.6%** |
| 47 | 24 | 46 | −20.2 | −58.5 | 1.192 | +3.5% |
| 63 | 32 | 62 | −29.2 | −92.6 | 1.195 | **+3.7%** |

（QRS 真值 1.152 mV，来自干净数据上的零相移参考链）

选 N=31 的依据是**波形保真**和**延迟**，不是资源：

- N=15 把 QRS 削掉 8.7%，太短
- **N=31 保真到 −0.6%，是误差绝对值的最小点**
- N=47 / N=63 反而偏大 3.5%～3.7%（窄带低通对 QRS 的过冲），而且
  群延迟翻倍到 46～62 ms，实时显示的滞后变明显

> 乘法次数这一列在时分复用架构下**不构成约束**：N=63 时
> 8 通道每采样周期需要 (32+5)×8 = 296 次乘法，而可用周期是 200,000 个，
> 仍然一个 DSP 就够（见 2.0 节）。因此抽头数之争完全由信号质量决定。

低通在 50 Hz 处只有 −13.9 dB 不重要，工频由前一级陷波器负责（−80 dB）。

FIR 用 FIR 而不用 IIR 的三个理由：
1. 无反馈，定点下**无条件稳定**，不会因量化振荡
2. 系数对称，硬件可折叠：`h[i]·(x[n−i] + x[n−(N−1−i)])`，一个乘法算两项
3. 线性相位 = 固定群延迟 15 个采样点 = 30 ms，算 RR 间期时被减掉

---

## 3. 定稿配置的验收

在干净的 60 秒实测数据上，与原版双向零相移链路对比：

| | QRS 幅度 mV | 心率 BPM | 检出心拍 | 残留直流 mV |
|---|---|---|---|---|
| 原版 双向零相移（硬件做不到） | 1.152 | 72.8 | 74 | −0.0003 |
| **定稿 硬件链** | **1.175** | **73.0** | **73** | **0.0017** |

QRS 偏高 2.0%，心率差 0.2 BPM，**少检出 1 个心拍**（73 vs 74）。
少的那一拍在记录边缘，属于滤波器启动瞬态区域。

端到端模型判读一致性（10 秒不重叠窗口）：**4/5 一致**。
不一致的是第 4 窗口——参考链给"房性早搏 68.8%"，硬件链给"正常 89.0%"。
这一窗参考链本身置信度只有 68.8%，而模型对房性早搏类的误报率是
37.7%（预测为 A 的样本里有 37.7% 真实标签是 N），**没有真值无法判断哪个更对**，
如实记录为不一致。

---

## 4. 交给 HLS 的东西

| 文件 | 内容 |
|---|---|
| `src/hls/ecg_filter_coef.h` | 全部定点系数与位宽定义，自动生成 |
| `data/input_raw.txt` | 60 秒实测输入，30034 点 |
| `data/golden_float.txt` | 黄金参考输出（结构与位宽同 HLS，算术用双精度） |
| `data/testcase_impulse*.txt` | 单位冲激，抓"系数装反/装错" |
| `data/testcase_50hz*.txt` | 纯 50 Hz，抓"陷波器没生效" |

`golden_float.txt` 用的是**量化后的系数 + 双精度算术**。
HLS 定点版本与它的差异就是纯粹的**算术量化误差**，
C 仿真时报出最大绝对误差并设阈值，把"系数误差"和"算术误差"分开定位。

## 5. 待办

- [ ] HLS 实现三级链路，C 仿真对比 `golden_float.txt`
- [ ] 用 `#pragma HLS ALLOCATION` 做资源共享，记录"乘法器实例数 vs II vs 资源"的权衡表
- [ ] 参数化到 N 通道，综合 N=1/2/4/8/16 的资源占用，验证 2.0 节的时间预算结论
- [ ] **拿 AMD FIR Compiler 做一版 40Hz 低通，与手写版对比资源 / Fmax / 延迟**
      —— 作为"与基线的对比"写进报告，同时说明为什么最终选手写
      （三级中另外两级无现成 IP；需要可改动以展示优化过程；C 仿真可直接对黄金参考）
- [x] ~~测一次基线漂移的实际幅度~~ —— 已测：静坐 60 秒实测 0.05–0.5 Hz
      RMS 1.008 mV、峰峰 6.613 mV（与 2 mV 注入同量级）
- [ ] 在**运动 / 深呼吸 / 电极将干**条件下再测一次，确认 2 级是否仍然够用；
      不够就把 `DC_STAGES` 改成 3（编译期参数，不动硬件结构）
