rentommy/2026-fpga-dual-channel-ecg/docs/posters/amd_poster_en.pptx

AMD ADAPTIVE COMPUTING COMPETITION · ENTRY

Dual-Path ECG Monitoring with FPGA-Assisted Beat Recognition

PYNQ-Z2 · Dual-Path Filtering · Per-Beat Assisted Recognition

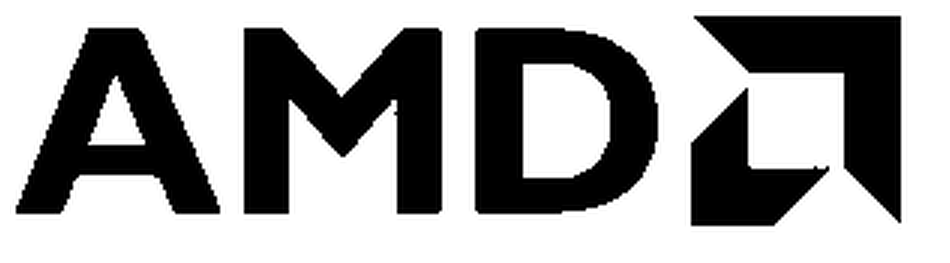
[picture p2: figure]
AMD official logo

ADAPTIVE COMPUTING

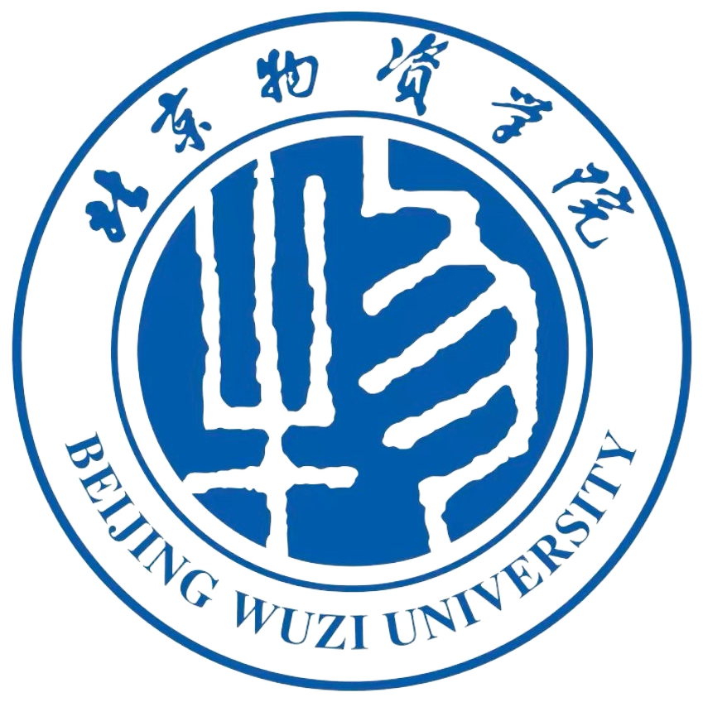
[picture p3: figure]
北京物资学院校徽

Team: Ren Jialin · Cheng Shuo · Li Yibo School: Beijing Wuzi University

01 Overview

Built on PYNQ-Z2 (AMD XC7Z020) and a custom ADS1292 board, this prototype acquires two 24-bit ECG channels at 500 Hz over isolated SPI.
A PS–PL co-design performs dual-path filtering, heart-rate estimation, FPGA convolution-assisted beat classification, and HDMI display. Each input produces a low-latency real-time path and a delayed high-fidelity path; SW0 switches between single- and stacked-path views to expose waveform and timing differences.

Keywords: ECG · PYNQ · PS–PL co-design · deterministic latency

04 System Design

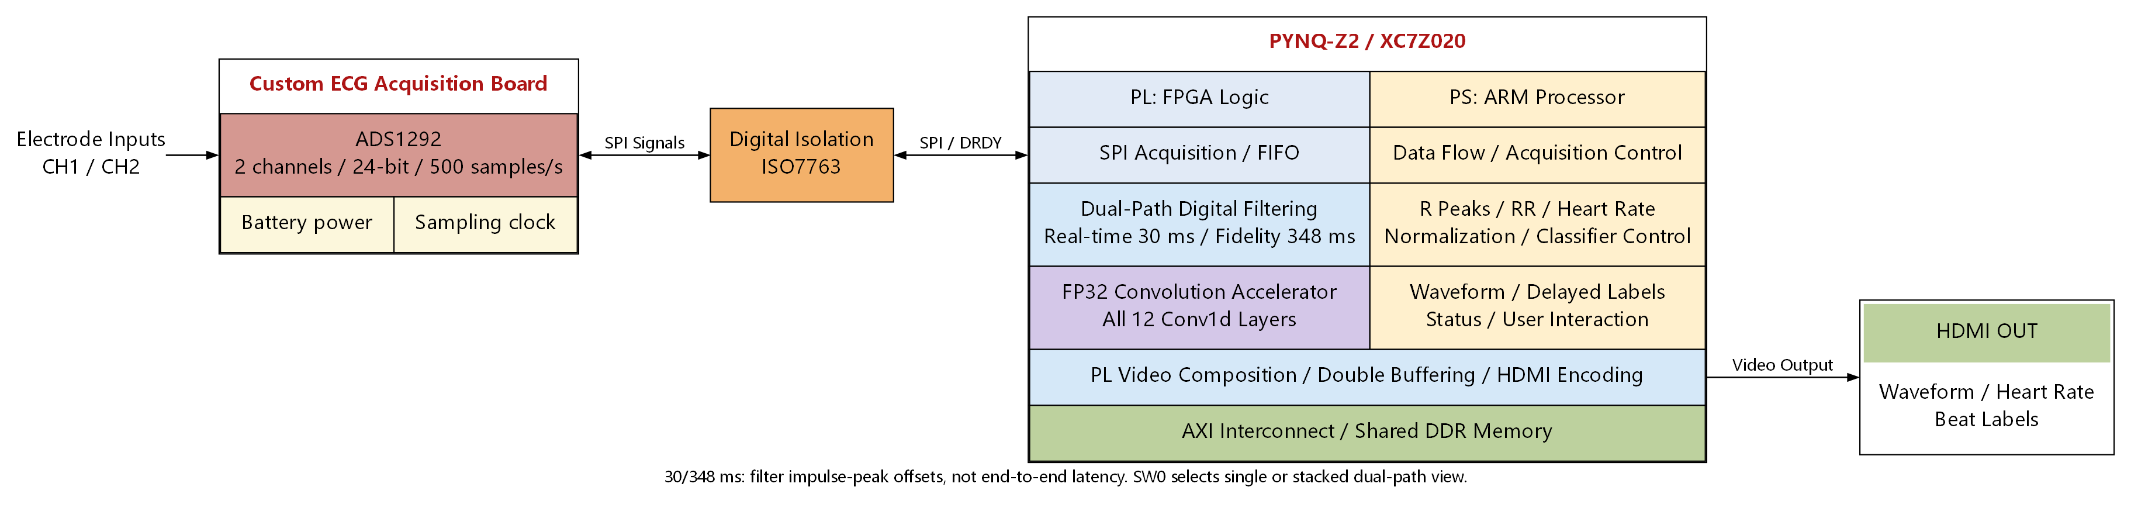
[picture p4: figure]
System architecture block diagram

Fig. 1 System architecture and data flow

06 Innovations

1

Same-source dual delay: shared baseline estimate and different taps form real-time and fidelity paths; SW0 switches single/stacked views.

2

Resource reuse: single-DSP time multiplexing at 100 MHz; all 12 Conv1d layers share one FP32 accelerator.

DATA FLOW
2 × 24-bit @ 500 Hz · isolated SPI / FIFO
PL: dual-path filtering + FP32 Conv1D
PS: R-peak / HR, quality gating, delayed labels
Filter offsets: 30 / 348 ms (peak, not end-to-end)
Resources: LUT 15,735 · FF 20,490 · DSP 57

3

07 Test Results

Display/recognition decoupling: an independent inference queue maps labels back to beats using source samples and path delay.

02 Motivation

•

Different biosignals impose different latency and waveform requirements: EMG/EEG prioritize low latency, while ECG prioritizes waveform fidelity and baseline stability.

dropped / bad frames

30 s continuous acquisition

0

•

A fixed single path cannot satisfy both: low-latency filtering sacrifices morphology, while high-fidelity filtering adds delay.

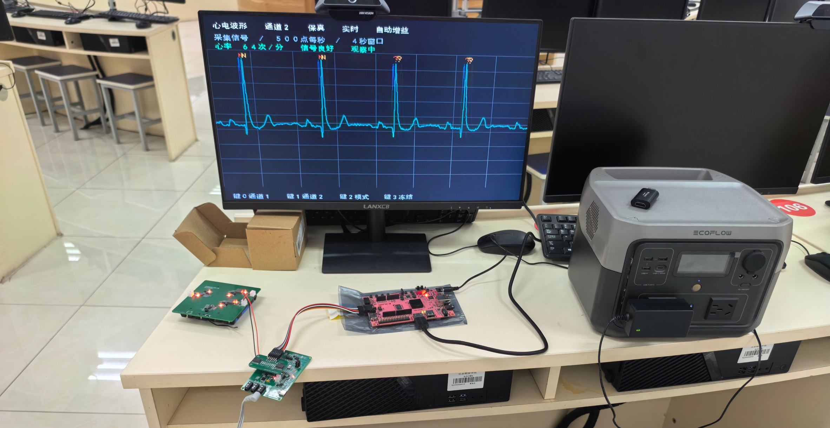
[picture p5: figure]
Prototype and on-board ECG display

Fig. 2 Prototype and on-board ECG display

•

03 Features

A same-source dual-path design outputs low-latency and high-fidelity signals from one acquisition path for multiple biosignals.

05 HW/SW Co-design

01 Acquisition

ADS1292 / isolated SPI / FIFO

02 Processing

Dual-path filtering / FP32 Conv1D

03 Display

HDMI / double buffering / labels

•

Dual input channels: 24-bit, 500 Hz, isolated SPI configuration/readout and FIFO frame checking.

•

•

Dual-path filtering: real-time/fidelity peak offsets of about 30/348 ms; SW0 switches the view.

Recognition and display: FP32 convolution + ARM classification, delayed per-beat labels, HDMI output.

Deliverables: dual-path waveforms · per-beat labels · prototype

PL performs dual-path filtering, FP32 convolution, and HDMI composition; PS handles SPI/FIFO, R-peak/heart rate, quality gating, and classification. Shared AXI/DDR buffers let display proceed without waiting for inference.

Platform: AMD Zynq-7000 XC7Z020 / PYNQ-Z2 Key devices: ADS1292 · ISO7763 · HDMI

Outlook

With the board's expansion interfaces and a scriptable software stack, different biosignal front ends can be connected and configured quickly. Modular drivers, multi-modal acquisition, and per-signal delay settings will turn the prototype into a general-purpose biosignal acquisition tool.

Platform: AMD Zynq-7000 XC7Z020 / PYNQ-Z2 | Toolchain: Vivado/Vitis 2026.1 · PYNQ/Python | Docs/Code: [link] | Contact: [email]

AMD ADAPTIVE COMPUTING COMPETITION · ENTRY

01 / 01

Notes: 【模板使用说明】
1. 所有 [ ] 内容都可以直接替换为你的项目信息。
2. 图片占位框：右键占位框→设置形状格式→填充→图片，或删除占位框后直接插入图片；建议 300 dpi。
3. 推荐字体：中文微软雅黑，英文 Arial；标题 24 pt，正文不小于 7.5 pt。
4. 配色：主色 #151A21，强调色 #E4002B，浅灰 #F6F7F9。
测试结果卡中的 500 Hz 为示例，请替换为你的核心指标。
5. 封面尺寸为 16:9（13.333 × 7.5 in）；打印 A1/A0 时请保持比例，先导出 PDF 检查。
6. AMD 标志已按官方样式放入；如需更高清版本，请替换为官方矢量 logo，不要拉伸变形。
7. 右上角校徽已放大并放入透明底版本，可右键“更改图片”替换。
