rentommy/2026-fpga-dual-channel-ecg/report/llm_log/README.md

# 大模型协作记录索引

整理更新：2026-11-04。记录用于说明用户与大模型如何提出问题、验证方案、发现错误及推进工程；具体构建结果仍以源码、工具报告和板上输出为准。

## 记录范围与来源

- 原有10份记录保留，覆盖2026-09-30至10-19；其中部分结论后来被后续实验修正，不应单独引用为当前结论。
- 本次新增10-20、10-21、10-22、10-23四份记录。Claude阶段根据用户提供的最后可直接获取的对话记录（原工作区引用：`../../旧的资料/最后可直接获取的对话记录.txt`，未随此公共候选发布）补记；GPT阶段根据本次会话、接手报告、构建报告和板上结果整理。
- 原转录共2163行，含截断命令、重复输出和“若干行隐藏”。补记仅恢复可见内容；不补造缺失问答，也不把模型说“接下来修改”写成已经落实。
- 本次依据的TXT为184700字节，SHA256：`64403fa8bbd340e82de8494d4a2a70aa6cdf079fe4d32e3771e182bcc755ad8b`。文件换行或内容若变化，下表行号也需重新核对。
- 日期采用Asia/Shanghai。转录中界面“星期／done时间”与工具日志不完全一致，跨午夜部分优先参考明确的工具日期。10-20的归档日期是根据“星期二00:48”及前后顺序推定，尚无独立时间戳确认；详见该日说明。没有材料的日期不逐日补空白日志。
- 旧记录标识为Claude历史协作，不推测具体模型型号；新记录使用GPT／Codex，不补写未被保存的具体模型版本。本文及新增日志均为10-23回溯整理，不冒充当日原始逐字记录。

## 按时间查阅

| 日期 | 协作阶段 | 主要内容 |
|---|---|---|
| [09-30](2026-09-30.md) | Claude，原记录 | 工具链、双向滤波硬件化、系数量化和漂移问题 |
| [10-01](2026-10-01.md) | Claude，原记录 | HLS／HDL划分、用户要求先理解再推进 |
| [10-03](2026-10-03.md) | Claude，原记录 | 前期系统故障定位及项目关联 |
| [10-04](2026-10-04.md) | Claude，原记录 | 学习内容与实际设备条件的匹配 |
| [10-09](2026-10-09.md) | Claude，原记录 | 自写滤波器、资源架构、ADC码换算、讲解方式 |
| [10-10](2026-10-10.md) | Claude，原记录 | 移位高通、Python参考、群延迟及矛盾纠正 |
| [10-12](2026-10-12.md) | Claude，原记录 | 工程自包含、路径与依赖、注释审核 |
| [10-16](2026-10-16.md) | Claude，原记录 | ONNX输入名称／格式的区分、softmax置信度边界 |
| [10-18](2026-10-18.md) | Claude，原记录 | 评估口径、双链探索、用户发现基线未对齐 |
| [10-19](2026-10-19.md) | Claude，原记录 | 消融、逐拍指标、矩形窗定稿、HLS实现与测试骨架 |
| [10-20（日期推定）](2026-10-20.md) | Claude，补记 | 参数及波形双层自检、故障注入、失败前禁止写出向量 |
| [10-21](2026-10-21.md) | Claude，补记 | 换机、2026.1入口、路径故障、ap_int歧义、首版资源超限 |
| [10-22](2026-10-22.md) | Claude→GPT，补记 | 单DSP优化、IP导出、接手审计、系统实现、复位故障 |
| [10-23](2026-10-23.md) | GPT／Codex，续记 | 修复后回放、不同通道激励、STM32核查、SPI／HDMI版本与验收 |
| [10-25](2026-10-25.md) | GPT／Codex，续记 | 新增BQ25882／TPS62163电源检查、共地回流缺失、测试供电及充电控制 |
| [11-04](2026-11-04.md) | GPT／Codex，续记 | FPGA卷积部署、延后标签、49拍硬件一致性与真实记录回放自启动 |

## 新增记录如何追溯

下表行号按原TXT的物理行计数，含空行；原文件未改写。

| 原转录范围 | 新增日志 | 内容 |
|---|---|---|
| 1～52 | 10-20 | 一致性自检、故障注入、写文件顺序修正 |
| 53～834 | 10-21 | 全流程目标、换机、启动器和工具环境 |
| 835～1255 | 10-21 | argv、C仿真链接失败、排除cflags及暂绕C仿真 |
| 1256～1780 | 10-21 | 路径实验、ap_int类型修补、首版综合报告 |
| 1781～2048 | 10-21／10-22 | 资源超限、约束修正、1 DSP与1298周期 |
| 2049～2163 | 10-22 | 导出IP与驱动、DDR接口、板文件检查、历史协作停点 |

GPT阶段证据入口：[首次接手快照](../history/project_status_2026-10-22.md)、[实现与复位修复](../history/implementation_2026-10-22.md)、[通道测试](../history/channel_test_2026-10-23.md)、[STM32与接线核查](../history/ads1292_wiring_2026-10-23.md)、[SPI／HDMI构建](../history/scope_build_2026-10-23.md)。

## 引用时需要带上的修正

| 历史说法 | 后续证据与当前口径 |
|---|---|
| 344次乘法≈344时钟周期 | 优化后HLS为每时刻八通道合计1298周期；操作次数不能当调度周期 |
| 7.300ns对10ns有2.70ns时序余量 | HLS表中2.70ns列名为Uncertainty；136.99MHz仅估计频率。实际系统100MHz，以布线后slack为准 |
| open_component可以彻底解决路径问题 | 嵌套目录仍曾失败；后续通过工作目录与组件父目录一致的入口复现 |
| g++通过即可视为ap_int分支通过 | 精确位宽分支随后真实暴露类型歧义；两者验证范围不同 |
| 已计划将约束移入源码、重写入口 | 接手时旧入口仍在，单DSP结果依赖hls_fix.tcl／hls_export.tcl；不能按承诺认定已提交 |
| 各通道喂同一记录、输出相同即可证明无串扰 | 10-23补做不同输入、逐通道单独激励、不规则分块和复位测试，20项通过 |
| 348／30ms即端到端显示延迟 | 是滤波冲激峰值位置，不含采集、分块、DDR和显示开销 |
| HPD=1说明显示正常 | 无显示器时也读到1；真实画面必须现场确认 |

## 后续续写方式

每次记录至少保留：用户目标与关键判断、模型实际工作、失败与修正、可定位的产物、验证条件及尚未验证的部分。历史来源用转述或精确引用；无逐字记录时不拼接“用户原话”。用户提出的方案与观察、大模型实现或建议、工具自动生成的结果分别注明归属。

上述历史待验收项以对应日期为准。2026-11-04已完成PYNQ上FPGA卷积推理与记录回放集成；本次未接ADS1292及采集卡，实时电极推理、新标签的实际HDMI画面及新模式断电启动仍待现场验证，见[最新部署报告](../history/model_deployment_2026-11-04.md)。协作经验尚未整理成独立可复用技能包；新增这些日志不等于技能包已完成。

11月4日条目已追加真实采集、SW0双路径、供电故障确认、显示增益修复及提交准备的回溯摘记。
