rentommy/2026-fpga-dual-channel-ecg/hardware/isolation/netlist_20261023.txt

$PACKAGES
C0603 ! C0603 ! '0.1uF' ; C1 C2 C3 C4 
,
        HDR-TH_12P-P2.54-H-M-R2-C6-S2.54-N ! HDR-TH_12P-P2.54-H-M-R2-C6-S2.54-N ! '{Value}' ,
        ; U5 
,
        HDR-TH_18P-P2.54-V-F-R2-C9-S2.54 ! HDR-TH_18P-P2.54-V-F-R2-C9-S2.54 ! '{Value}' ,
        ; U6 
,
        SOIC-16_L10.3-W7.5-P1.27-LS10.3-BL ! SOIC-16_L10.3-W7.5-P1.27-LS10.3-BL ! '{Value}' ,
        ; U1 U2 
$A_PROPERTIES
$NETS
'PWDN/RESET' ; U2.6 U6.18 
3V3A ; C1.1 C3.1 U1.1 U2.1 U6.10 
3V3D ; C2.1 C4.1 U1.16 U2.16 U5.11 U5.12 
CS ; U1.7 U6.14 
CSD ; U1.10 U5.2 
DIN ; U1.5 U6.8 
DIND ; U1.12 U5.4 
DOUT ; U1.3 U6.12 
DOUTD ; U1.14 U5.6 
DRDY ; U1.2 U6.4 
DRDYD ; U1.15 U5.1 
GNDA ; C1.2 C3.2 U1.8 U2.8 U6.2 
GNDD ; C2.2 C4.2 U1.9 U2.9 U5.9 U5.10 
RESETD ; U2.11 U5.5 
SCLK ; U1.6 U6.6 
SCLKD ; U1.11 U5.8 
START ; U2.5 U6.16 
STARTD ; U2.12 U5.3 
$SCHEDULE
$END
