rentommy/2026-fpga-dual-channel-ecg/report/llm_log/2026-10-20.md

# 大模型协作补记：参数一致性与测试向量保护

补记日期：2026-10-23。协作方：用户与Claude；整理方：GPT／Codex。

**事件日期推定为2026-10-20，未独立确认。** 原转录开头仅保留“星期二00:48”，结合10-19日志后续及10-21工具调试顺序归档于此。若以后取得带日期的完整导出，应据此调整；不能将本文件名当成精确时间证据。

来源：旧对话TXT第1行起（原工作区引用：`../../旧的资料/最后可直接获取的对话记录.txt#L1`，未随此公共候选发布），可见部分约第1～52行。开头的用户提问已经缺失，因此不补造提问原文。

## 1. 模型报告完成双层一致性自检

历史记录说明在 `sim/gen_vectors.py` 的 `dump()` 前加入两层检查，防止参考函数与生成向量所用参数漂移：

1. 检查 `chain_hw_v2()` 签名默认参数与生成器中 `k_g、L、D、notch_q、n_taps、fs` 的配置。
2. 对实际波形进行比对，跳过前543点后，偏差超过8码便退出。该层覆盖签名看不到的级联顺序、硬编码陷波频率和FIR截止频率。

“比较参数”与“比较行为”解决不同问题；只核对函数签名不足以保护黄金参考。

## 2. 用主动注入错误验证检查真的有效

以下数字是旧对话记载，本次整理没有重新执行故障注入。

| 实验 | 历史结果 |
|---|---|
| 正常配置 | 最大偏差1.00码，小于8码，退出码0 |
| 将参考默认L改为256 | 参数层发现256／320不一致，退出码1 |
| 将硬编码NOTCH_F0改为60Hz | 波形层发现216.70码偏差，退出码1 |
| 恢复配置 | 重新通过 |

不能仅因为正常输入能过，就认定检查能抓到真实错误；两种故障注入给出了反例验证。

## 3. 自检放在写文件之后，仍会留下坏产物

第一版把检查放在 `dump()` 后。修改陷波频率的实验暴露：程序虽然报错，但错误黄金向量已经写出，后续流程仍可能误用。

模型将检查前移到写文件之前，重测错误配置不会改写黄金／测试向量。转录随后报告七个产物的校验和与已知值一致、两个C测试平台退出码0、`plot_boxcar.py` 跑通。原文没有完整保留七个文件清单及哈希，不能据此编造它们的具体值。

## 4. 字符串转义重复踩坑

补丁中的换行经过多层字符串解释，打断三个 `print`，随后修正；记录称这是工程里第二次出现。经验是修改生成器后应检查实际落盘源码及执行结果，不能只检查外层补丁字符串看起来正确。

## 5. 当时的完成边界

本段完成的是软件参考与向量生成保护，不是HLS综合、C/RTL协同仿真或上板验证。这些工作接续于[10-21](2026-10-21.md)与[10-22](2026-10-22.md)。本条也没有把“值得写进skill/pitfalls.md”记为技能文件已创建。
