rentommy/2026-fpga-dual-channel-ecg/report/llm_log/2026-10-22.md

# 大模型协作补记 2026-10-22

补记日期：2026-10-23。当天分为Claude完成HLS优化／导出与GPT／Codex接手两段；不能把两段成果合并归给同一个模型。后半段上板故障处理跨入10-23，按事件顺序衔接，无法确认的逐条钟点不补写。

Claude来源：旧对话TXT（原工作区引用：`../../旧的资料/最后可直接获取的对话记录.txt`，未随此公共候选发布）第1781～2163行，另对照 `hls_ecg2/hls/syn/report/`。GPT来源为本次会话、[首次接手报告](../history/project_status_2026-10-22.md)、[实现与复位记录](../history/implementation_2026-10-22.md)。

## 1. Claude阶段：资源从超限回到单DSP

用户在另一台电脑执行命令并贴回报告，模型根据上一轮超限结果提出以下约束：

```tcl
config_compile -pipeline_loops 0
set_directive_allocation -limit 1 -type function ecg_filter_top ecg_filter_sample
set_directive_allocation -limit 1 -type operation ecg_filter_sample mul
```

明确关闭自动循环流水，限制核心函数只保留一份，并在实际乘法所在函数内限制资源。10-22 00:08:21启动修复综合，00:09的报告给出可用结果；导出前再次综合的报告日期为00:18:13。

| HLS估计 | 首版hls_ecg | 优化后hls_ecg2 |
|---|---:|---:|
| DSP | 304 | 1 |
| LUT | 149887 | 7700 |
| FF | 66870 | 6915 |
| BRAM18K | 18 | 26 |

FIR历史从寄存器转入RAM，以少量BRAM换回大量逻辑。以上均为HLS估计，不能与之后整套系统布局布线的资源直接混算。

## 2. 344次乘法不是344个时钟周期

原估算把一个时刻八通道、两通路的344次乘法直接近似成344周期。实际 `sample_loop` 每次迭代1298周期，其中 `chan_loop` 合计1296周期、单次核心153周期。未流水的乘累加还包括访存和调度。

100MHz、500SPS下，每时刻有200000周期预算，1298周期约占0.649%。4096时刻的循环部分为5316608周期，约53.166ms；顶层报告最大延迟约53.192ms，另含调用／复位等开销。这里的“一个采样点”指同一时刻全部八通道，并非每个单通道都再乘八。

旧对话曾把7.300ns估计周期与10ns目标之差称作“2.70ns余量”。接手核对表头发现2.70ns实际列为 **Uncertainty**，136.99MHz也是HLS估计频率，不能当成板级实际时序通过证据。该说法在补记中保留修正，不照抄进最终指标。

## 3. Claude阶段：IP及驱动导出完成，停在系统集成前

00:17:18启动 `hls_export.tcl`，可见日志确认生成：

- `hls_ecg2/hls/impl/ip/nuaa_ecg_ecg_filter_top_1_0.zip`，用户目录输出约192KB。
- `component.xml`、Verilog／VHDL以及生成的PS驱动文件。
- AXI-Lite控制接口 `s_axi_ctrl`、读写DDR的 `m_axi_gmem0/gmem1`、时钟、低有效复位及中断接口。

后续系统连法明确为PS的GP0控制寄存器，HLS读主口到HP0、写主口到HP1，PYNQ分配DDR缓冲；不额外插入AXI DMA。

模型表示准备把约束移进源码、重写2026.1入口并更新文档；但GPT接手时检查发现旧 `src/hls/run_hls.tcl` 仍使用 `open_project/open_solution`，源码顶层乘法限制仍有作用域警告。成功的单DSP结果实际依赖 `hls_fix.tcl/hls_export.tcl`，因此这些后续整理承诺不能全部记为已完成。

原转录最后是用户贴出IP／驱动清单及板文件目录结果，之后历史协作中断，没有可见的Vivado系统构建或板上执行。不能把后来的GPT成果倒填到Claude阶段。模型关于“已有PS启动配置，所以BD里DDR型号不影响”的简化解释也未获验证，GPT后续采用匹配的厂商板级预设。

## 4. GPT接手：先建立证据清单，纠正工程状态

用户要求完整了解项目、旧资料与历史对话，足够接手后输出进度。GPT检查现行滤波核、顶层、参考及测试、设计文档、十份协作日志、旧探索脚本、HLS报告和IP接口，并复跑普通C++测试。

接手核对区分了：

- 已有STM32／香橙派旧平台与本次PYNQ平台；旧平台准确率和推理耗时不能算作新平台成绩。
- ADS1292两个模拟通道与HLS八个逻辑通道；同一份单列记录复制八份不等于八路真实采集。
- 普通整数C++、精确位宽C仿真、C/RTL协同仿真、板上运行四种证据。
- 348／30ms冲激峰值延迟与包含采集、缓存、调度和界面的端到端延迟。

首次快照保存在 `report/project_status_2026-10-22.md`。其中后来失效的“尚未完成”保留为历史快照，并由更新说明链接后续结果，不静默改写当时状态。

## 5. GPT补齐精确位宽C仿真

首次额外启动曾在环境初始化阶段失败，未进入测试，不能算通过。随后使用 `sim/run_csim_2026.tcl`，把工作目录切至 `build/hls_csim`，组件建为其直接子目录，再添加源文件。

该做法避免先前路径问题，同时保留产物在 `build/` 下。工具真实编译核心、顶层和测试平台，包括 `ap_int.h` 分支；30034点×8通道通过，最大误差约3.3码、RMS约0.698码，冲激峰值174／15点检查通过，`CSim done with 0 errors`。

这补齐了Claude当时暂绕的验证，但没有执行HLS滤波核的C/RTL协同仿真。后续新增SPI／视频RTL仿真也不能倒算成滤波HLS的cosim通过。

## 6. GPT完成最小Vivado系统，并遇到真实复位故障

取得并核对TUL PYNQ-Z2板级文件，建立PS、滤波IP、三组SmartConnect、100MHz时钟与复位的DDR回放系统。完成设计验证、综合、实现及bit／hwh导出；并准备PYNQ缓存同步、分块驱动和参考比对程序。

用户提供Jupyter地址并登录，模型上传验证文件并实际运行。首次回放未返回，Jupyter停止响应；用户按要求断电重启。分步探针将解析、加载、控制访问和单点处理拆开，确认元数据解析及FPGA加载可以完成，随后在控制访问附近再次卡住。

检查HWH和复位仿真网表发现：辅助复位默认低电平有效，却接常零，导致互连和核心持续处于复位。这是本次集成错误。修复为辅助复位高有效并保持接地，PS外部复位继续低有效；增加极性断言，在独立 `ecg_overlay_resetfix` 工程重构建，保留故障版产物用于追溯。

加载成功只证明配置写入，设计连接检查通过也不足以发现所有语义错误。修复后的真实板上回放在后续完成，见[10-23记录](2026-10-23.md)。

## 7. 当日交接留下的可复用经验

| 协作判断 | 最终处理 |
|---|---|
| 算术操作数被当作周期数 | 以循环调度报告重算，说明八通道口径 |
| 计划改脚本就被当成已落实 | 接手逐项检查源文件及实际生效指令 |
| 估计频率被写成时序结论 | 分开HLS估计、布线slack、板上运行频率 |
| 只看BD验证和bit生成 | 增加真实控制访问、逐阶段落盘诊断 |
| 首版复位极性误接 | 查看生成元数据／网表，显式配置并断言 |

本日从“IP已导出”推进到“系统已实现、故障已定位并重构建”。最终通过结论以修复后上板结果为准，不将首次卡住的回放记成成功。
