rentommy/2026-fpga-dual-channel-ecg/report/llm_log/2026-11-04.md

# 2026-11-04：FPGA 卷积模型部署与真实记录验证

参与：用户与GPT/Codex。此条只记录本次模型部署工作；更早的采集、自启动、数据导出见对应实测报告，不补造逐字对话。

用户决定采用实时滚动波形、延后回填标签的显示方式，并要求FPGA加速卷积、ARM处理RR和控制，使用刚导出的真实心电进行推理测试。选定 experiment_09/six_db_seed0 的 best.pt 与 config.json。

Codex核查完整网络、205点双路输入、8维RR特征、标签顺序与训练预处理，保持FP32权重。实现全部12个卷积层共用的HLS加速器，ARM保留GroupNorm、门控、全连接、R峰与控制；为HDMI增加同波形一起换帧的双缓冲字母标签。推理进程使用有界队列，显示不等待模型。

先建立PyTorch参考，移植NumPy和C卷积并在桌面验证。真实记录中49个心拍分类一致，C卷积最大logit误差约0.00000203。流式窗口另得到48个可输出心拍，分类与相应整段参考一致。随后完成RTL仿真，包括标签地址边界、待提交写保护、字母像素渲染、帧切换和SPI/按钮回归。

失败与修正：工具子进程在受限运行环境下启动失败，按系统流程获得工具运行权限后继续；首次布局布线存在-0.089 ns偏差，没有将失败固件上板；首次补充物理优化脚本的报告命令使用了不支持的-force参数，修正并重新运行；最终通过物理优化达到WNS+0.005 ns、WHS+0.017 ns。SPI仿真初次遗漏编译ads_spi_engine，补齐模块后通过。期间板卡网页断开，用户恢复连接并说明没有接ADS1292，因此增加明确标记REPLAY的真实记录回放模式。

上板结果：49/49分类与PyTorch参考一致，588次FPGA卷积调用，最大误差0.000002384；完整推理平均143.61 ms、最大161.11 ms。前三拍纯ARM基线平均182.74 ms，完整推理约1.25倍速度。板端回放更新约29 FPS；两通道软件切换均产生推理结果，worker存活、没有推理错误。

用户说明采集卡也没有连接，因此未声称看到了新HDMI画面。当前ecg-scope.service启用为通道2真实记录回放；原服务及旧比特流保留，实时ADC模式可用安装参数切换。本次尚未测试新模式断电启动、实时人体推理及实际显示画面。

数据保存于原导出目录的04_FPGA识别测试：完整逐拍CSV、优选10秒区间内21拍的单独CSV、JSON与波形标签图。全部记录没有专家真值，部署一致性不等于识别准确率；CN4扰动附近的非N模型输出不能作为诊断结论。

证据与产物：[完整部署报告](../history/model_deployment_2026-11-04.md)、`report/inference_20261104/`、`board/inference/`、`src/hls/ecg_conv.cpp`、`board/ecg_inference_20261104.zip`。板上操作留在独立笔记本ECG_FPGA_Model_Deployment_20261104.ipynb。

## 同日后续：标签移动卡顿

用户反馈标签移动不如波形平滑。定位为16像素文字格对齐造成的约10 Hz跳位。Codex将标签缓存改为携带局部像素位置的12位编码，取消文字格对齐，并避免待识别峰微抖产生重叠问号。软件、RTL逐像素字形及SPI回归测试通过，新实现时序通过。新固件重新上板测试49拍分类保持一致，平均推理138.35 ms。原目录保留，服务升级到ecg_inference_smooth_20261104；详细证据见[修复记录](../history/label_smooth_2026-11-04.md)。用户随后确认“已经平滑，和波形接近”，完成实际HDMI滚动观感确认。

## 同日后续：真实输入、SW0双路径与提交准备（回溯摘记）

用户原话：“hdmi显示的画面没体现出两个不同延迟的滤波在同时进行，我想加一个用SW0来切换是否同时显示两路信号的功能”。助手提出上实时、下保真，并保留时间差。最初Vivado旧模块引用未刷新新增端口，不能据此声称构建成功；之后采用独立模块名重建引用，检查连接，仿真验证SW0消抖、上下RAM选择、坐标映射、帧边界切换和切回单路。最终WNS+0.016ns、WHS+0.002ns，固件上板。用户确认“正常上下分屏，没有采集数据”。

助手最初观察到ID=0xFF/0x00、DRDY中断及无效帧，不能直接认定滤波或SPI算法错误。用户纠正：“就是电源，电源老断”。另发现显示增益同时参考未使用输入，改为只参考当前输入的两条路径；保留同增益比较。临时降低SPI到250kHz只作为对照，不能声称修复电源。固定供电后同一PID的约30秒观察中采样计数持续增长，错误计数为0，质量GOOD、推理存活；没有把短时观察写成长期稳定性通过。

用户要求：“按照我的赛道完善项目目录结构，看看还有没有没完成的部分，我要准备上传github仓库进行提交代码了”。核对用户PDF指南3.3节，发现skill预留为空、README状态过期、最新构建依赖旧xpr、公共文件路径不规范。创建独立英文提交候选，补技能包与从空工程入口、合成验证和提交审查。用户选择“原始人体数据保留本地（推荐）”。历史人体输入没有混入公共候选，也不擅自重写旧Git历史。训练来源快照仍有祖先实验依赖，完整训练复现、最新版本断电验收、长期稳定性和匿名英文海报均明确列为待办，不补造完成记录。

## 同日后续：HLS至比特流完整干净重建、全部代码整理

用户要求“从 HLS 到比特流的完整干净重建”，整理全部代码到一个200MB以内的文件夹，随后明确“我自己来压缩你弄好文件夹就行”。Codex在独立空目录重新综合滤波与卷积HLS并导出IP，从空Vivado工程完成实现及bit/hwh生成；没有借用旧IP或工程。最终WNS+0.016ns、WHS+0.002ns，setup/hold失败端点0，bit生成DRC错误0。保存构建日志、HLS报告、输入哈希和新输出；新bit未重新上板，不把旧现场验收算作新构建验收。

整理当前源代码、模型与历史训练/STM32代码到submission/ecg_fpga_complete_20261104。发现历史runtime_backup混有PyTorch安装残留，已从交付副本排除，原文件保留。用户补充“模型训练/项目复现/ECG-with-Deep-learning-master这个文件夹里是别人的项目用来学习复现的不要加进去”，按要求排除该整棵目录并记录在source_map；未删除原项目。历史代码使用原路径映射和哈希，不声称全部旧实验可以直接运行。人体原始数据继续保留本地，不创建RAR，由用户自行压缩。

用户要求说明skill内容：当前项目技能包含时序报告门控、Overlay ABI校验两项脚本，以及DMA缓存所有权、异常退出和电源/SPI分层排查工作流；HLS报告解析复用工具位于sim。它们是项目交付技能包，不是为Codex新安装的全局技能。

最终检查：交付目录主机检查通过，文件命名/体积/明显凭据/Python当前入口语法审查通过。首次主机自检因系统临时目录写入限制中断，获准重新运行后通过；其中HLS报告解析器自检使用的是固定示例，不是本次C/RTL协同仿真证据。未进行新的板端测试。

## 同日后续：按用户新授权生成RAR

用户随后改为“下载RAR工具帮我压缩吧”，明确授权下载与压缩。Codex从RARLAB官方地址下载WinRAR 7.23，验证安装包数字签名有效，提取命令行工具用于本次压缩；工具留在项目临时目录，未打入交付。生成submission/ecg_fpga_complete_20261104.rar并进行完整性检查。此要求替代此前由用户自行压缩的安排，源代码和第三方排除范围保持一致。

RAR解压兼容性复核发现历史目录aux是Windows保留设备名；仅在交付副本改名为aux_files，并更新source_map原路径映射。原始学习资料保持不变；重新打包后校验全部文件。

## 同日后续 技术文档与GitHub目录整理

用户要求将技术文档、最新中英文海报和电路资料按竞赛目录归类，中文文件名改为英文，并上传指定GitHub仓库。技术文档已去除机械设计/机械成果，加入作品全貌图、系统框图、电路图与协作心得。公开副本文件名统一为英文，文档正文保持原语言。指定ECG-with-Deep-learning-master学习复现项目继续排除，人体原始记录继续留在本地。

发布使用独立检出目录，原工作目录资料保留。以完整干净重建交付目录为基础，更新docs、docs/posters、hardware/acquisition、hardware/isolation、hardware/power与README索引。清单记录原名和英文路径，提交前复查合成数据、凭据和文件大小。不将代码构建通过视为新版上板、长期稳定性或临床分类验收。
