rentommy/2026-fpga-dual-channel-ecg/report/history/design_phase2.md

# 阶段二：从移位级联到矩形窗 —— 把"延迟换形态"重新定价

> 日期：2026-10-19
> 接 `design_phase1.md`。阶段一定下的**三级结构没有变**，
> 变的是第一级（直流阻断）的实现，以及一个新增的架构维度：
> 每通道并行两条不同延迟的通路。
>
> 这一章同样对应指南 3.3.5.3 的"优化过程"，但它记录的主要是
> **一次推翻自己的过程** —— 包括推翻阶段一定下的验收指标。

所有数字来自 `sim/experiments/plot_boxcar.py`、`sim/gen_vectors.py`
与 `src/hls/tb_ecg_filter.cpp`，跑在两段 60 秒真人实测数据上，可复现。

---

## 0. 阶段一的哪些结论作废了

| 阶段一的结论 | 现在 |
|---|---|
| §2.1 直流阻断用移位式一阶高通，级联 2 级 | **作废**。改用矩形窗滑动平均 + 延迟补偿 |
| §1 验收用"按 R 波对齐的平均心拍模板相关" | **作废**，这个指标有系统性盲区，见本章 §4 |
| §3 定稿验收表（QRS 1.175 mV 等） | 数字对应旧链路，已被 §5 的新表取代 |
| §2.0 时间预算（500 SPS × 100 MHz = 20 万时钟/采样点） | **仍然有效**，而且是本章 §6 双通路的前提 |
| §2.2 陷波 Q=15、§2.3 系数位宽、§2.4 FIR 31 抽头 | **仍然有效**，一个数都没动 |

换掉第一级的收益（两段实测数据，逐拍临床指标，详见 §4）：

| | 实测延迟 | 典型残留漂移 mV | ST60 误差 RMS mV | T 峰误差 RMS mV |
|---|---|---|---|---|
| 阶段一定稿 移位级联 k=7×2 | 16 点 | 0.190 | 0.1236 | 0.1721 |
| 中途方案 F 一阶 IIR + D=200 | 216 点 | 0.154 | 0.1163 | 0.1714 |
| **阶段二定稿 矩形窗 L=320 + D=159** | **174 点** | **0.040** | **0.0770** | **0.1184** |

漂移降到 1/4.8，ST60 误差降到 62%，代价是延迟从 32 ms 增加到 348 ms。
**这笔交易值不值，取决于这条通路服务于什么** —— 这就是 §6 要解决的问题。

---

## 1. 先把不可能的部分证明掉

动手之前先问：有没有可能延迟短、形态准、漂移又去得干净？

**没有，这是定理不是调参问题。** 因果最小相位 LTI 系统的 `ln|H(ω)|` 与
`arg H(ω)` 是希尔伯特变换对（Bode 增益—相位关系）。也就是说，
**高通的幅度特性一旦定下来，带内相位就被锁死了**，没有任何自由度。

唯一还能帮忙的全通环节是**纯延迟**，而它需要的延迟量按 `1/fc` 增长 ——
拐点越低（漂移去得越干净），需要的延迟越长。

所以"低延迟 + 保形态 + 强去漂移"三者不可兼得。
**阶段一那条 0 乘法的移位级联链，真实有效高通拐点是 0.98 Hz。**
IEC 60601-2-25（诊断心电）要求 0.05 Hz，正是因为更高的拐点会扭曲 ST 段；
60601-2-27（监护）允许 0.5 Hz，但标准里明确写了不适用于 ST 分析。
**也就是说阶段一是拿监护级的滤波器做诊断级的测量。**

> 标准条款号在提交前需要逐条核对原文，本章全部外部引用同此要求。

---

## 2. 唯一的出路是延迟 —— 一次消融实验

阶段一之后试过一整条非线性/时变的路线（双链路渐变合并、QRS 期间门控基线更新、
斜率外推、变时间常数、等电位点锚定等十余种，全部归档在 `old/nonlinear_gated/`）。
动机是：既然 LTI 有定理挡着，那就跳出 LTI。

其中"方案 F"看着最有希望：一阶 IIR 估基线 + 一个随偏差自适应的权重 `w` +
信号通路延迟 D 对齐。做了一次 2×2 消融（k_g=7, k_lp=7, D=116）：

| 去掉什么 | 结果 |
|---|---|
| 去掉自适应权重 `w`（令 w≡1） | 几乎没变：0.051 → 0.041 |
| 去掉延迟补偿 D（令 D=0） | **塌回阶段一定稿数值完全相同的值** |

两行表说明一件事：**这一路所有收益的唯一有效成分是延迟对齐，
非线性那一层是死重。** 而且 `yg - lp` 在数学上本来就是第二级高通，
这就是去掉 D 之后会和阶段一定稿**逐位相同**的原因。

教训记在这里：延迟从一开始就被我默默排除在搜索空间之外了，
于是绕了一整天去找"不用延迟的办法"。
**一个"某类方法必然做不到"的断言，代价远大于一个错误的参数。**

顺带也否证掉了两类"用预测换延迟"的想法：

- 喂真实未来基线的**先知实验**在 30 ms 延迟下能到 0.9896 / 96%，说明架构没问题；
  但真实预测器误差按 `m^1.3` 增长（m=40 点误差 6.4%，m=200 点 32.7%）。
- 3 抽头维纳滤波器对它的抽头集是 MMSE 最优的，所以
  **Savitzky-Golay 边缘外推不可能更好**，线性高斯卡尔曼就是递归维纳，同一个界。
- 在线 LMS 在这里根本不收敛：权重范数 30 秒内 1.019→0.829→2.180→2.617→2.092；
  电极脱落时输出冲到 1486 mV，是纯延迟 LTI（270 mV）的 5.5 倍。

---

## 3. 换零件：为什么是矩形窗

既然有效成分是延迟对齐，问题就变成：**哪个基线估计器最容易被一个固定延迟对齐？**

### 3.1 判别量是群延迟平坦度，不是群延迟大小

一个固定的延迟量 D 只能对齐一个频率。基线估计器的群延迟在带内变化越小，
一个 D 能同时对齐的频带就越宽：

| 基线估计器 | 0.05～1 Hz 的群延迟变化 |
|---|---|
| 一阶 IIR（移位 k=8） | 249 点 → 22 点，**变 11.25 倍** |
| 半高斯核 σ=180 | 2.83 倍 |
| **矩形窗 L=400** | **1.00 倍** |

矩形窗的群延迟恒为 `(L-1)/2`，与频率无关。**一个 D 把所有频率一次对齐。**
这就是换矩形窗的全部理由 —— 不是因为它滤得更好，而是因为它好对齐。

### 3.2 `z^-D − B(z)` 是线性相位 FIR 高通

把延迟后的信号减去矩形窗均值，整体就是一个线性相位 FIR 高通。
这一步不是我们发明的；**我们的贡献是认出它该用在这里，并且用滑动和实现它**：

```
box_sum += yg[n] − yg[n−L]        每点一次加、一次减
lp = box_sum × (2^20 / L) >> 20   一次乘法完成归一化
```

直接做 320 抽头 FIR 要 320 次乘法，滑动和只要 **1 次**。
全链每通道每采样点 22 次乘法（1 归一化 + 5 陷波 + 16 折叠 FIR），
与阶段一的 21 次相比只多 1 次 —— 却换来了 §0 那张表的收益。

### 3.3 L 的下限由心拍长度决定

窗比一拍短，窗里就装着 QRS 和 T 波本身，基线估计被自己的心跳顶高，
减完造成 **ST 段系统性读低**：

| L | 窗长 | 占一个 RR | 基频泄漏进基线的比例 | ST60 偏差（两段数据） |
|---|---|---|---|---|
| 256 | 512 ms | 0.62 | 0.47 | −0.068 / −0.065 mV |
| **320** | **640 ms** | **0.78** | **0.26** | **−0.028 / −0.036 mV** |
| 512 | 1024 ms | 1.24 | 0.18 | −0.001 / −0.030 mV |

实测 RR 间期 824 / 878 ms（73 BPM，心搏基频 1.217 Hz）。
**0.1 mV 的 ST 压低就是临床判读阈值**，
所以 L=256 的 −0.068 mV 会直接造成假阳性 —— 这不是精度问题，是会误诊的量级。

L 没取 512 是因为延迟按 `(L-1)/2` 增长，512 要 511 ms，
而收益（ST 偏差 −0.028 → −0.001 mV）已经在噪声量级里。
L=320 的 −0.028 mV 是临床阈值的 28%，接受。

> **本节的一处修正（2026-10-20）。** 原先这里写着"矩形窗的频谱零点在 `fs/L`，
> L ≈ 一个 RR 时心搏基频正好落在零点上，被整个零掉"。**这句对 L=320 是错的。**
> 零点在 `fs/320` = 1.5625 Hz，而心搏基频是 1.217 Hz，该处增益 **0.262**
> —— 泄漏了 26%，远不是零掉。
>
> 要让零点正好压住基频，L 得取 `fs/f_心搏` = 500/1.217 ≈ **412**，
> 该处增益降到 0.0025。这个 L 确实存在、而且理论上更漂亮，但**没有采用**：
> 它随心率变（60 BPM 要 500，100 BPM 要 300），而 `DC_BOX_L` 是编译期常量；
> 做成跟随心率的自适应窗长就不再是 LTI，回到了 §2 已经否证掉的那条路。
>
> L=320 处那 26% 的泄漏，表现在 ST 偏差上就是 −0.028 mV。
> 也就是说：这一行的收益本来就是靠**窗够长**挣的，不是靠零点对齐挣的。

### 3.4 L=320 是偶数，严格线性相位要奇数

严格线性相位要求 `D=(L-1)/2` 是整数，也就是 **L 必须为奇数**。
L=320 留下了一个 `1/320` 抽头的不对称。

实测这个不对称的影响是 **0.0006 mV**，在噪声以下，所以定稿没改。
> 记一笔：这条假设第一次验证时用了一个坏掉的对称性度量 ——
> 它只比较平坦部分，从不检查尖峰是否居中，于是对所有 L 都报 0。
> 理论是对的，效果可以忽略，两件事都要说。

---

## 4. 验收指标的方法论修正 —— 推翻阶段一 §1

阶段一 §1 把验收指标定成"按 R 波对齐的平均心拍模板相关"。**这个指标有两个盲区：**

| 盲区 | 为什么 |
|---|---|
| 对基线漂移**盲** | 逐拍平均把漂移抵消掉了 |
| 对幅度**盲** | 模板做 L2 归一化，幅度被抵消掉了 |

而漂移和 ST 幅度恰恰是这一章在乎的两样东西。
这个坑在定稿前**踩了四次** —— 最后一次是给一个残留漂移 0.815 mV 的方案
标了星号，就因为它的模板相关是 0.9974。

改用的指标：**逐拍临床测量**。每一拍以自己的 PQ 段为零点，
量 ST60 和 T 峰，与零相位参考逐拍配对求误差。换指标之后
**候选方案的排序直接反过来了** —— 这不是精度提升，是结论变了。

两条必须一起说清的保留：

- **逐拍 PQ 参考能抵掉约 90% 的漂移**（拍内漂移 RMS 0.085/0.073 mV，
  对比全程 0.815 mV），但 0.08 mV 仍是 0.13 mV 级 ST 信号的 60%，
  **所以去漂移这一步省不掉**。
- **参考是相位真值，不是幅度真值。** `filtfilt` 自己那级 0.5 Hz 高通
  会衰减 T 波，所以"T 波占参考的百分比"可以超过 100%（实测 104%）。
  拿它当幅度金标准会得到荒谬结论。

还有一个方法论坑：**启动瞬态会污染全程最大值/峰峰值统计。**
曾经那个 3.060 mV 的"最坏漂移"出现在 t=0.5 s，是滤波器自己还没稳。
现在所有峰峰值统计都掐掉首尾 2 秒。这个指标前后坏过两次。

---

## 5. 定稿配置与验收

三级结构（阶段一 §2）不变，第一级换实现：

| 级 | 实现 | 每通道每采样点乘法次数 |
|---|---|---|
| ①a 温和一阶高通 | 移位式，`DC_SHIFT=8`，fc=0.311 Hz | **0** |
| ①b 矩形窗基线 + 延迟补偿 | 滑动和 `L=320`，归一化 `×3277 >>20` | **1** |
| ② 50 Hz 陷波 | 二阶 biquad 直接 I 型，Q=15 | 5 |
| ③ 40 Hz 低通 | 31 抽头对称 FIR，折叠 | 16 |
| | **合计** | **22** |

定点格式全部沉淀在 `src/hls/ecg_filter_coef.h`（由 `sim/gen_vectors.py` 生成，不要手改）：
`DATA_BITS=24`、`ACC_BITS=48`、`COEF_BITS=18`、`DC_BOX_ACC_BITS=34`、
`DC_BOX_SCALE=3277`（直流增益 1.000061）、`DC_DELAY_ECG=159`、`DC_DELAY_FAST=0`。

与原版双向零相移链路对比（干净 60 秒实测）：

| | QRS 幅度 mV | 心率 BPM | 检出心拍 |
|---|---|---|---|
| 原版 双向零相移（硬件做不到） | 1.152 | 72.8 | 74 |
| **定稿 硬件链** | **1.138** | **73.0** | **73** |

定点与浮点黄金参考的偏差（`tb_ecg_filter.cpp`，29491 点）：
**最大 3.3 码 = 0.158 µV，RMS 0.698 码**。
50 Hz 抑制：输入 249314 码 → 残留 49.0 码，**−74.1 dB**。

位宽声明是**实测核对**的，不是估算 —— 测试平台跑完会把实际峰值与契约声称比对：

| 节点 | 实测峰值 | 占用 | 余量 |
|---|---|---|---|
| 温和高通输出 yg | 113019 | 17.8 / 24 位 | 6.2 位 |
| 矩形窗滑动和 | 19640019 | 25.2 / 34 位 | 8.8 位 |
| 陷波累加器 | 7437329564 | 33.8 / 48 位 | 14.2 位 |
| FIR 累加器 | 60172502873 | 36.8 / 48 位 | 11.2 位 |

---

## 6. 双延迟通路 —— 新增的架构维度

§0 那笔交易（漂移降 4.8 倍，延迟从 32 ms 涨到 348 ms）**不需要全局做决定**。

| 通路 | 延迟 | 服务于 |
|---|---|---|
| path 1 低延迟 | **30 ms** | 实时波形显示、报警，以及肌电一类闭环场景 |
| path 0 诊断 | **348 ms** | ST 段测量、波形存档、模型推理 |

两条通路**共享前级**（温和高通 + 矩形窗滑动和），只在延迟抽头之后分开。
延迟量 `DC_DELAY_CFG[通道][通路]` 是编译期参数，逐通道可改。

一个容易想错的地方，值得写进报告：**这两条不是"同一个滤波器平移"。**
path 0 算 `yg[n−159] − lp[n]`，path 1 算 `yg[n] − lp[n]` ——
它们减的是**同一时刻**的基线估计，所以是两个不同的滤波器，
把 path 0 延迟 159 点也不会等于 path 1（实测差 11460 码）。
> 这一条是顶层测试平台的第三项检查抓出来的 —— 抓的是我的错误模型，不是设计缺陷。
> 现在那项检查改成了验证冲激响应峰值的位置。

低延迟通路的诚实评价：在 ST/T 逐拍误差上它比阶段一定稿好 1.3～1.7 倍，
但在**残留漂移上更差**（0.276 vs 0.150 mV）。它不是"全面更好的旧定稿"，
是一个为低延迟场景做了不同取舍的通路。肌电假肢控制文献给的可接受延迟约
100～125 ms，30 ms 留足了余量。

---

## 7. 多通道扩展 —— 瓶颈在存储不在运算

500 SPS、100 MHz，**每个采样周期有 20 万个时钟**（阶段一 §2.0 的结论）。
8 通道 × 2 通路 × 22 次乘法 = **344 次乘法**，占一个 DSP48E1 的 **0.172%**。
运算量根本不是约束。

真正的约束是 BRAM。这里有一个省一半存储的做法：
**延迟线直接复用矩形窗的历史 RAM。** 因为 `DC_DELAY_MAX`(192) < `DC_BOX_L`(320)，
需要的延迟抽头本来就在窗的历史里；BRAM 是双端口的，
一个端口读"离开窗口的那个样本"，另一个端口读延迟抽头。

每通道每通路省 4608 bit。通道上限从约 260 提到 **约 520（双通路）/ 570（单通路）**。
> 这个数第一版算错了 2 倍，就是因为漏掉了复用这件事。

---

## 8. 定点实现上踩到的坑

| 坑 | 现象 | 处理 |
|---|---|---|
| 移位 IIR 的死区 | `acc += (x−acc)>>8` 用整数存储时，`\|x−acc\| < 256` 就完全停住（±0.0123 mV 的死区） | 加 `DC_ACC_FRAC=8` 位小数 |
| 右移的算术/逻辑之别 | 心电是**带负均值**的有符号量（实测 −3.942 mV），逻辑右移会把负数变成巨大正数 | 测试平台里加运行期断言；`ap_int<N>` 本身是算术移位 |
| 黄金参考实现了硬件做不到的算法 | Python 的 `boxcar_lp` 在预热期按**实际点数**求平均，而硬件只有一个固定的 `1/L` 乘数 | **改 Python 不改硬件**，并定义 `ECG_WARMUP=543` 为无效输出区 |
| 反馈环里的舍入 | 反馈环内做舍入可能产生极限环 | 陷波/FIR/矩形窗用舍入移位，`hp_acc` 反馈环用截断 |

第三条是冲激测试抓出来的，偏差 60780 码。
**黄金参考必须只实现硬件做得到的算法** —— 否则它不是参考，是另一个待调试对象。

---

## 9. 交给 HLS 的东西（阶段一 §4 的更新）

| 文件 | 内容 | 阶段一时的状态 |
|---|---|---|
| `src/hls/ecg_filter.h` | 接口契约：状态结构体、类型别名、`ECG_WARMUP=543` | 不存在 |
| `src/hls/ecg_filter.cpp` | 定点核心，**纯 C 无 HLS 语法**，所以能用 g++ 单独验 | 不存在 |
| `src/hls/ecg_filter_top.cpp` | 综合顶层，**全部 pragma 只出现在这里** | 不存在 |
| `src/hls/tb_ecg_filter.cpp` | 核心测试平台，五项检查 | 不存在 |
| `src/hls/tb_ecg_filter_top.cpp` | 顶层测试：黄金比对、通道串扰、逐通道延迟配置 | 不存在 |
| `src/hls/INTERFACE.md` | 完整规格书，八节 | 不存在 |
| `src/hls/run_hls.tcl` | 批处理：csim → 综合 → cosim → 导出 IP | 不存在 |
| `src/hls/ecg_filter_coef.h` | 定点系数与位宽，自动生成 | 已有，第①节重写 |
| `data/input_raw.txt` + `golden_float.txt` | 实测输入与黄金参考输出 | 已有，按新链路重新生成 |

把 pragma 全部关在 `ecg_filter_top.cpp` 是刻意的：
**核心可以脱离工具链验证。** 两个测试平台都只要 g++，退出码 0 即全过。

阶段一 §5 待办的完成情况：

- [x] HLS 实现三级链路，C 仿真对比 `golden_float.txt` —— 最大偏差 3.3 码
- [x] 用 `#pragma HLS ALLOCATION` 做资源共享 —— 已限制 `mul limit=1`
- [x] 参数化到 N 通道 —— `N_CHANNELS=8`，顶层测试已验证逐通道配置生效
- [ ] 综合 N=1/2/4/8/16 的资源占用（需要装 Vitis 的机器）
- [ ] 拿 AMD FIR Compiler 做一版 40 Hz 低通对比资源 / Fmax / 延迟 —— **顺延到阶段三**

---

## 10. 保留与待办

### 必须写进报告的保留

| 保留 | 具体 |
|---|---|
| **数据量** | 只有两段 60 秒、**同一个被试**（共 120 秒）。这是最大的可信度缺口 |
| **"验证段"已不再是留出集** | 它被反复看了几十次，用它报告泛化能力已经不诚实 |
| **参考是相位真值不是幅度真值** | `filtfilt` 自己衰减 T 波，不能当幅度金标准（§4） |
| **未诊断的异常** | P 段相关出现过 0.65 / 0.38 / −0.55 的塌陷，始终没查清原因 |
| **没有电极脱落检测** | 实测脱落时输出冲到 270 mV，是 QRS 的 234 倍，**当前完全没有防护** |
| **外部引用待核** | 本章的 IEC 条款号、肌电延迟指标，提交前需逐条核对原文 |

### 待办

- [ ] 在装有 Vitis 的机器上实跑综合，核对预测（344 周期/采样点、1 个 DSP、4～10 块 BRAM18K）
- [ ] Vivado 工程与 PYNQ overlay
- [ ] PS 侧驱动与上位机
- [ ] **电极脱落检测**（EMRMS 包络），优先级高于任何滤波优化
- [ ] 扩充采集：不同日期、不同电极位置、含走动与深呼吸
- [ ] 模型训练域不匹配：`model/ecg_model.onnx` 训练用的是 `fl=0.5, fh=34` 四阶
      `filtfilt` 数据，与现在的硬件链不同域，需要重训或量化影响
- [ ] AMD FIR Compiler 对比（阶段一 §5 顺延）

---

## 附：这一章的方法论总结

三件事值得单独记住：

1. **先证不可能，再找出路。** Bode 关系省掉了一整条搜索方向，
   也解释了为什么必须付延迟。
2. **消融实验比扫参数值钱。** 两行表（去掉 w / 去掉 D）定了方案的走向，
   而之前扫了一整天参数。
3. **指标错了，结论就全错。** 模板相关这个盲区让同一组候选的排序反了过来，
   踩了四次才换掉。**验收指标本身也要被审。**

逐一被推翻的方案与它们的脚本全部归档在 `old/`，按五类分目录，
每类说明被什么取代，18 个脚本全部仍可运行 —— 见 `old/README.md`。
