rentommy/2026-fpga-dual-channel-ecg/report/llm_log/2026-10-03.md

# 大模型协作记录 2026-10-03

ST 段测出来不正常，但医院心电图正常 —— 定位到测量方法

---

## 1. 现象

用户把自己设备测出的数据给医生看，先后反馈 ST 段**偏低**、**偏高**，
而**医院的心电图看了没有问题**。

用户问：我该怎么测出正常的 ST 段？

---

## 2. 定位

心电图正常，说明这不是生理问题，而是**仪器与测量方法**问题。
模型回答时主动指出了自己上一版实现里的缺陷：

**原做法**：取「R 波峰后固定 100 ms」处的电平作为 ST 段值。

**为什么这是错的**：100 ms 是个粗略近似。QRS 波群的宽度本身就
因人、因导联、因心率而变 —— 心率快时 QRS 后的各段都会压缩。
固定偏移量会落在 QRS 的下降支上（读出偏高/偏低取决于落在哪一侧），
而不是落在真正的 ST 段上。

**正确做法**：**逐拍找 J 点**（QRS 真正的终点，即 S 波回到基线的位置），
再从 J 点往后量固定时间（常用 J+60 ms 或 J+80 ms）。
J 点是逐拍检测出来的，会随 QRS 宽度自动移动。

---

## 3. 与本项目的关联

这一条不只是上位机的 bug，它影响 FPGA 侧的设计取舍：

**① 它解释了为什么 ST 段在级数决策里有否决权。**
`2026-09-30.md` 第 4 条记录过：直流阻断没有选 3 级，
理由是高通角频率抬高会在 QRS 前后产生过冲、压低 ST 段。
ST 段有临床含义，而本条说明它**本来就很难测准** ——
再叠加一个滤波器引入的系统性偏移，就彻底没法用了。

**② 它说明幅度标定是必需项，不是可选项。**
ST 段是以**毫伏**判读的（临床阈值在 0.1 mV 量级），
所以推理那条通路可以靠逐窗 z-score 忽略绝对幅度，
但 ST 测量**必须有真实毫伏**。

→ 待办：用 ADS1292 内部 ±1 mV 测试信号做幅度标定
（`CONFIG2=0xA3`，`CH2SET=0x05`，预期 ±20,970 码）。
这一项验证 `LSB_UV = 48.081e-3` 这个理论值和实际链路是否一致。

**③ 它是一条"不要信固定偏移"的通用经验。**
生物信号里几乎所有特征点的位置都随心率/呼吸变化，
凡是写成"峰后固定 N 毫秒"的地方都应当怀疑。
→ 写进 `skill/pitfalls.md`

---

## 4. 安全声明（随时重申）

本系统是课程演示装置，**未经任何医疗认证，结果不可用于诊断**。
本条记录中与医生的交流是为了定位仪器误差，不构成任何医学判断。
