rentommy/2026-fpga-dual-channel-ecg/report/llm_log/2026-10-04.md

# 大模型协作记录 2026-10-04

学习材料的结构性错误（用户发现）

---

## 1. 模型产出的学习清单里，一段"动手"内容放错了位置

**用户提问**（贴出 `滤波器学习清单.md` 里的一段后）：

> 这段话位置放错了吧

被指出的内容是一段"动手"练习：

> 把上面那段画图代码里的 `Q=15` 依次改成 `5`、`15`、`30`、`60`，
> 四条曲线画在一张图上。看 Q 变大时那个坑的宽度怎么变。
> 这一眼看懂了，第五节就不用背了。

**问题**：这段话结尾说"第五节就不用背了"，
说明它应该放在**第五节之前**作为引入，而它被放在了别处。
放错位置后，读者先读到结论性的那句"就不用背了"，
却还没读到它指向的那一节。

**用户发现的是模型产出的文档存在结构性错误**，不是技术错误。

---

## 2. 为什么把这条记下来

它单独看很小，但有两层意义：

**① 这是用户真的在读、而且在校对模型产出的证据。**
§3.3.3.1 要求提交的是"协作"记录。一个只接收不校验的参与者
不会发现"这段话位置放错了"这种问题 —— 它要求读者已经建立起
对材料整体结构的预期。

**② 模型产出长文档时容易出这类错。**
技术内容逐条都对，但章节顺序、前后引用关系是另一回事；
而这类错误不会被任何脚本或断言抓到，只能靠人读出来。

**对策**：凡是模型产出的长文档（学习材料、设计报告），
交付前应当**只检查结构**跑一遍：
每一节的前置知识是否都在它之前出现过、
每一处"见某节"的指向是否真的存在。
这一遍不看技术内容，只看依赖顺序。
→ 写进 `skill/README.md`
