rentommy/2026-fpga-dual-channel-ecg/archive/original_code/model_training/item_6a0ae77f8d9c/readme.md

# 本次心电数据

已导出到 `2026-11-04_真实心电_已保存记录/`。

建议先打开该目录的 `README_请先阅读.md`，再使用 `03_优选连续片段/` 中的CSV或NPZ：

- `CN2_CH2_最新记录_优选10秒`：最近一次CN2真实电极记录，截取原始索引2250～7249（标称4.5～14.5秒）。滤波后心跳清楚，原始数据仍有工频成分。
- `CN4_CH1_RLD修正记录_优选10秒`：此前验证成功的CN4记录，截取索引1000～5999（标称2～12秒），原始工频较少，避开后续明显短时干扰。

完整两段有效通道记录共23779点，标称500 Hz，合计约47.56秒。两个10秒优选片段来自上述完整记录，不能另算新增数据。已保留未经修改的板端原始文件、滤波输出、质量指标、波形图与哈希清单。

这些是同一受测者的两次记录，没有疾病或专家逐拍标签。用于模型时不要将完整记录及其派生片段随机分散到训练集和测试集，也不要把滤波参考当作人工无噪声真值。
