rentommy/2026-fpga-dual-channel-ecg/archive/original_code/model_training/item_d83a071a9a27/readme.md

# 逐心拍分类改进项目

2026-10-24 新增研究：[公开项目代码核查与可借鉴方案](research_10/项目核查与可借鉴方案.md)。审阅五个公开仓库，区分原始标签/AAMI、患者校准/无校准、随机心拍/患者划分；优先建议形态＋RR＋SVM作者方案建立对照。本次仅研究，没有新增训练成绩。

最新完成：[experiment_09 六库接入结论](experiment_09/本轮结论.md)、[完整结果](experiment_09/结果报告.md)、[实际数据覆盖](experiment_09/数据覆盖.md)。331条带参考标注的记录、211万个有效目标，六库训练139.9万拍；恢复S为八输出。三种子平均合并测试准确率97.08%、MIT测试81.12%，但合并八类macro-F1仅0.3956，L/R等仍未解决，不能按总体分数认定各类达标。新权重独立保存，未替换部署权重。

新增完成：[experiment_08 双向带通＋50Hz陷波对照](experiment_08/结果报告.md)。按图片使用0.5–40Hz三阶双向带通，再加50Hz、Q=30双向陷波；三种子平均准确率71.91%、macro-F1 0.4312，未改善第七轮候选的整体结果。实现见 [filtering.py](experiment_08/filtering.py)，新数据与权重单独保存在第八轮目录。

最新已完成：[experiment_07 本轮结论](experiment_07/本轮结论.md) 与 [完整结果](experiment_07/结果报告.md)。18次训练验证了真实时间轴、修正RR、多尺度/模板结构、INCART补充训练及标准化对照。最终候选MIT验证三种子平均准确率72.60%、macro-F1 0.4427；原七类80%目标未达成，不替换部署权重。外部测试已完成，其覆盖限制见报告。

2026-10-24 研究资料：[公开模型研究与下一版方案](research_06/研究与下一版方案.md)、[新增数据覆盖报告](../样本/数据下载与覆盖报告.md)。SVDB、INCART已下载；8个原始越界标注已在experiment_07提取时排除。RR事件流混入伪迹的问题已在新版本修正，旧冻结实验保留以供复现。下载报告中“尚未训练”为下载阶段状态，最新训练状态以上述experiment_07为准。

当前最新：[study_05 五项改进实验](study_05/README.md)，包含错误波形审核、受试者分层采样、形态/RR 对照、三项增强及多种子验证。完成后的汇总见 [五项工作总结](study_05/五项工作总结.md) 和 [完整对照表](study_05/结果报告.md)。

新增 [reference_04 参考项目改编](reference_04/参考项目审阅.md)：按最新要求排除 B/S，比较七输出 CNN、CNN＋GRU、CNN＋SE＋GRU；本轮仅做验证集对照，结果见 [参考改编实验](reference_04/结果报告.md)。

最新工作位于 [benchmark_03](benchmark_03/README.md)：MIT-BIH 同导联逐拍基准、两种预处理、四组 CNN 与传统分类器对照。详见 [第三轮结果](benchmark_03/结果报告.md) 和 [验证失败定位](benchmark_03/验证失败定位.md)。以下保留第二轮混合数据库方案的说明；不同数据库和划分的成绩不能直接比较。

## 当前任务

每个标签只对应中心的一个标注候选心拍。前一拍和后一拍只提供波形及时间上下文，不参与标签投票。

九类配置保留原始 A、B、F、L、N、R、S、V 和伪迹符号，不合并 A/S 或 V/F，不再把起搏符号当作 N。可用 `--seven` 排除 S/F，保持七类。

标注含义依据 [PhysioNet 官方说明](https://physionet.org/static/lightwave/doc/annotations.html)。伪迹符号表示类似 QRS 的噪声候选，不能称为真实心拍。模型中将其保留为质量类别。

## 单拍数据

1. 从原始 WFDB 波形及逐拍标注重新提取。
2. 以相邻候选标注位置的中点划分周期，窗口长度随心拍改变，不再用十秒窗口。不强行补零凑固定时长。
3. 每个周期插值成 256 点，单拍去均值及标准化。RR 和周期时长另行保存，避免时间归一化后丢掉提前量。
4. 同一中心拍读取前一拍、中心拍、后一拍波形，以及 8 个时间特征。时间特征只使用位置、不读取邻拍类别，标准化参数仅由训练集计算。
5. 缺失、恒定、长度异常及缺少有效相邻波形的目标排除，保存每拍原始位置、边界、标签、记录与集合。

候选位置包含被保留的 QRS 类标注及伪迹候选。因此 RR 是候选间隔，含伪迹时不等同于真实生理 RR。非目标类别的有效拍可以提供波形上下文，其标签不会作为输入。

## 新模型

`src/beat_model.py` 中的 BeatContextNet：

- 共享残差一维卷积分别提取三个周期的形态特征。使用 GroupNorm，减少对批次统计的依赖。
- 保留前、中、后三个位置的特征，中心目标有明确位置。
- 独立 MLP 编码 RR、局部 RR 比值、中心位置和周期时长。
- 融合后只输出中心候选的一个分类结果。

该结构是本项目的新设计，效果以实际记录隔离实验为准，不预设优于旧模型。

## 评估与限制

沿用归档基线的记录集合成员关系，重新生成逐拍样本；不按模型成绩重选记录。归档基线的记录划分此前仅依据标签覆盖修正。仍未完全核实跨记录受试者身份。B 类来源仅一条记录，不能验证其独立泛化能力。

仅训练集按记录最多保留 3000 个 N 拍，全部异常拍保留；验证和测试不作此下采样。类别权重只依据训练计数，验证 macro-F1 选点、早停 8 轮。单个种子的实验不等于稳定提升证据。

专家标注提供理想候选定位和 RR。右侧上下文需要等待后续心拍。这是离线分类实验，不包含自动 QRS 检测误差，不是已完成的实时部署方案。

## 运行

在本目录运行：

```powershell
.\.venv\Scripts\python.exe -m unittest discover -s src -p test_beats.py -v
.\.venv\Scripts\python.exe src/beat_project.py prepare
.\.venv\Scripts\python.exe src/beat_project.py train
.\.venv\Scripts\python.exe src/beat_project.py train --center-only --tag beat_center_only_seed0
.\.venv\Scripts\python.exe src/compare_runs.py
```

数据和实验拒绝覆盖。原始数据库只读引用相邻的 `项目复现/ECG_ren`。新数据在 `data/`，模型和结果在 `runs/`。

本轮两组完整实验已完成，直接重跑既有 tag 会拒绝覆盖。概览见 `本轮改进与结果.md`，数据校验见 `data/audit.json`，模型详细设计见 `模型与数据设计.md`。

## 历史归档

此前十秒窗口的代码、数据、结果、审计、下载工具和缓存集中保存于 `历史归档_10秒窗口方案_2026-10-24/`，移动轨迹见其中的 `文件移动记录.json`，未删除旧实验。

归档文件保持原内容和历史校验值。旧入口曾依据原目录位置解析相对路径，不能在归档位置直接运行；需恢复其原目录层级或显式调整源码路径。当前入口完全独立，只有记录集合划分有明确来源引用。
