rentommy/2026-fpga-dual-channel-ecg/archive/original_code/model_training/item_d83a071a9a27/requirements.lock.txt

aiohappyeyeballs==2.7.1
aiohttp==3.14.5
aiosignal==1.4.0
attrs==26.1.0
certifi==2026.10.23
cffi==2.1.1
charset-normalizer==3.5.2
cloudpickle==3.1.2
contourpy==1.4.0
cycler==0.12.1
filelock==4.2.4
fonttools==4.67.0
frozenlist==1.8.0
fsspec==2026.9.0
idna==3.20
Jinja2==3.1.6
joblib==1.6.0
kiwisolver==1.5.1
MarkupSafe==3.0.4
matplotlib==3.11.2
mpmath==1.3.0
multidict==7.1.0
narwhals==2.27.1
networkx==3.7
numpy==2.5.4
packaging==26.3
pandas==3.1.0
pillow==13.0.0
propcache==0.5.4
pycparser==3.12
pyparsing==3.3.3
python-dateutil==3.0.0
requests==2.34.2
scikit-learn==1.9.1
scipy==1.18.1
setuptools==84.2.1
six==1.17.0
soundfile==0.14.0
sympy==1.14.0
threadpoolctl==3.7.0
torch==2.7.1+cu128
typing_extensions==4.16.0
tzdata==2026.5
urllib3==2.8.0
wfdb==4.3.1
yarl==1.25.1
