rentommy/2026-fpga-dual-channel-ecg/archive/original_code/model_training/item_6661c42b523f/item_ee2bb8eaf50c.md

# 新增数据下载与标签覆盖

日期：2026-10-24。数量来自本地原始 WFDB 标注统计。

已完整下载 SVDB 78条、INCART 75条记录，共 887.39 MB 原始文件（十进制，不含本地回执）。

全部波形通过解码、长度、每个导联的WFDB数字校验和检查；文件通过本地SHA256回执复核。SHA256不是发布者独立摘要。

**发现8个越界原始标注：SVDB 1个，INCART 7个。原文件保留不动，后续提取必须按 data_audit.json 排除这些位置。** 完整性通过不代表医学质量已全面审核。

| 标签 | INCART位置有效标注数 | INCART患者数 | SVDB位置有效标注数 | SVDB记录数 |
|---|---:|---:|---:|---:|
| N | 150,406 | 31 | 162,338 | 78 |
| A | 1,944 | 19 | 0 | 0 |
| S | 16 | 3 | 12,188 | 73 |
| V | 20,011 | 31 | 9,943 | 67 |
| F | 219 | 14 | 23 | 6 |
| L | 0 | 0 | 0 | 0 |
| R | 3,173 | 2 | 0 | 0 |
| B | 1 | 1 | 1 | 1 |
| \| | 0 | 0 | 2,211 | 46 |

患者/记录覆盖根据原始标签统计；本次8个边界排除不改变这些覆盖数。位置有效不等于一定能提取完整心拍，实际训练数还需经过切分质量筛选。

INCART的75条记录来自32名患者，已核对官方映射；SVDB的78条是记录数，未确认唯一患者数。INCART为257Hz、12导联；SVDB为128Hz、ECG1/ECG2。不能假设它们与MIT的MLII同分布。

## 用途和缺口

- INCART可补充A、V、F的患者多样性；R虽有3,173个位置有效标注，却只有2名患者。F来自14名患者，但总量219仍少。
- SVDB提供12,188个S，覆盖73条记录。S不能直接改为A，应保留原始标签，可作为独立输出或辅助任务。
- 两库均没有L。请优先补充来自更多独立患者的L逐拍数据，保留患者ID、导联、采样率、原始波形、每拍位置与类型。整条记录的LBBB诊断不能直接当作每拍L标签。
- 伪迹符号是质量事件而非真实心拍；节律/质量标记不自动并入N，完整符号统计见JSON。
- 训练前先冻结患者划分，留出不参与预训练、调参或域适应的外部患者。当前仅下载与审计，尚未用新数据训练。

## 原始边界异常

- svdb/860：标注序号2462，位置230400，标签N，波形长度230400。
- incartdb/I04：标注序号0，位置-11，标签N，波形长度462600。
- incartdb/I17：标注序号0，位置-17，标签R，波形长度462600。
- incartdb/I35：标注序号0，位置-15，标签V，波形长度462600。
- incartdb/I44：标注序号0，位置-10，标签V，波形长度462600。
- incartdb/I57：标注序号0，位置-8，标签N，波形长度462600。
- incartdb/I72：标注序号0，位置-12，标签N，波形长度462600。
- incartdb/I74：标注序号0，位置-14，标签N，波形长度462600。

## 来源与复现

- [INCART官方页面与许可](https://physionet.org/content/incartdb/1.0.0/)，[官方患者映射](https://physionet.org/content/incartdb/1.0.0/files-patients-diagnoses.txt)。
- [SVDB官方页面与许可](https://physionet.org/content/svdb/1.0.0/)。两库为Open Data Commons Attribution License v1.0；使用时引用各数据库与PhysioNet。
- 官网主站速度慢，后切换官方公开physionet-open AWS镜像；每文件回执保存实际来源、版本路径、时间、字节数和SHA256。
- download_physionet.py：下载和复核回执，重跑跳过完整文件。
- audit_downloads.py：读取全部波形与标注，生成 data_audit.json，以及各库 audit.json、record_inventory.csv。
- make_data_report.py：根据审计结果生成本文。

下一版方案见 [模型研究报告](../模型改进/research_06/研究与下一版方案.md)。
