rentommy/2026-fpga-dual-channel-ecg/archive/original_code/model_training/item_6a0ae77f8d9c/item_c71603986b18/item_757f934f0f42.md

# 2026-11-04 实际电极心电数据

这是本次调试中已保存的两段连续人体电极记录，不是芯片内部测试信号，也不是重启后的全部实时数据。标称采样率500 Hz，ADS1292、24位、增益6、参考电压2.42 V。板卡时钟错误，不采用其文件时间作为采集日期；具体时刻未知。

## 从哪里开始

- `03_优选连续片段`：每段原始记录选一个10秒连续窗口，CSV可直接读，NPZ保留整数ADC码。
- `02_有效通道完整记录`：两段各约23.78秒的完整有效通道数据，保留启动瞬态，以便自行筛选。
- `01_板端原始文件`：完整导出包及未经修改的原始双通道数组、板上最后4秒滤波输出、日志和质量记录。只有所标注通道接着电极，另一路悬空不应作为心电样本。
- `04_波形与质量`：完整/优选片段图、逐窗口质量指标和源文件索引。
- `05_复现与说明`：本次导出脚本、当前项目定点滤波实现与重放程序。

最新记录是CN2/CH2；CN4/CH1是之前修正RLD后的记录。两段来自同一位受测者的连续调试，不是同步双导联，不是两个独立受试者，不能拼接成连续记录。

## 数值与滤波

电压换算：ADC码×(2.42/6/(2^23−1))×1000，单位mV；这是名义标定，不是实测增益校准。CSV的raw_mV保留电极直流偏置；diag_reference_mV、fast_reference_mV为当前项目定点C++滤波器对完整原始记录从零状态重放的输出。重放结果与保存的板上末4秒输出逐码比对，偏差必须为0才导出。

保真/快速是同一输入的两条处理结果，不能算作两份独立原始样本，也不是人工标注的无噪声真值。输出与输入按处理时刻对应，没有对齐补偿；名义延迟分别174点/15点（348/30 ms），IIR部分另有随频率变化的相位响应。不能未经延迟处理就拿raw与diag逐点当作同一心电事件的监督配对。

优选规则：排除最前2秒与最后0.5秒，在其间按0.5秒步进评估连续10秒窗，比较原始49～51Hz、45～150Hz能量比例、滤波后慢漂移比例、反向异常偏移与削顶；选择工程评分最低的一个，并查看波形图核实。反向偏移指标是针对本次记录中短时运动干扰的启发式筛选，不是临床波形判定。此规则只用于本次记录内选段，未经过临床信号质量标准验证。保留全部候选评分，未拼接、删改或合成心拍。波形幅度没有归一化。

标称时间轴按500 Hz计算；此前内部时钟实测约499.46 Hz，本次没有独立时间戳，不能把标称时长当作精确物理时长。

## 模型训练注意

无疾病、心律或逐拍专家标签，不应标为“健康/正常心律”的已标注数据。只有一个受测者和两段短记录，适合作为自有硬件适配、回放及去噪探索，不能代表独立临床验证集。完整记录、优选片段、两条滤波路径和重叠候选窗存在重复，切分训练/验证/测试时必须按受测者/采集会话分组，不能随机混分这些派生数据。
