rentommy/2026-fpga-dual-channel-ecg/archive/original_code/model_training/item_d83a071a9a27/inference_20261104/item_721c83a704e2.md

# 2026-11-04 两段自采心电推理结果

主模型：最后一轮experiment_09六库方案的six_db_seed0/best.pt。三份六库权重按原保存的选型验证macro-F1比较，seed0为0.4460、seed1为0.4359、seed2为0.4077，因此选seed0；没有依据这两段预测结果或测试集重新挑权重。另两份权重仅用于检查预测稳定性。research_10只是研究，没有后续新训练权重。

输入取02_有效通道完整记录中的原始ADC码，按文件标定转mV。每段独立处理：500Hz三阶0.5–40Hz双向带通＋50Hz/Q30双向陷波，重采样256Hz；自动定位后按原模型205点、中心77点、中点掩码、有效点均值/标准差与8维RR提取输入。RR标准化使用对应权重保存的训练参数。不把板上diag/fast输出再次当原始心电输入，也没有拼接两段。

## 主模型完整记录结果

| 记录 | 标称时长 | 自动定位候选 | 实际分类目标 | N | A | S | 伪迹 | F/L/R/V |
|---|---:|---:|---:|---:|---:|---:|---:|---|
| CN2_CH2_最新记录 | 23.780秒 | 25 | 23 | 23 | 0 | 0 | 0 | 均0 |
| CN4_CH1_RLD修正记录 | 23.778秒 | 35 | 33 | 29 | 1 | 1 | 2 | 均0 |

N为模型的正常拍类别；A为房性早搏类别，S为原始室上性早搏类别；伪迹符号是QRS样噪声候选，不是真实心拍类型。A/S保持分别输出。
每段首、末自动定位候选因缺少前拍或后拍上下文，仅用于时间上下文，不给分类结论。因此25个定位候选对应23个分类目标，35个对应33个。实际计数均是自动定位候选，不能当成人工确认的真实总心拍数。
前2秒/末0.5秒按已有采集说明单独标记，没有从完整统计中偷偷删去。排除这两个时间区域后，CN2为22个N；CN4为28个N、1个A、1个S、2个伪迹，共32目标。

## 非N输出及其稳定性

| 记录 | 原始时间 | 主预测 | 主模型分数 | seed0 / seed1 / seed2 |
|---|---:|---|---:|---|
| CN4_CH1_RLD修正记录 | 12.580秒 | 伪迹 | 99.38% | 伪迹 / 伪迹 / 伪迹 |
| CN4_CH1_RLD修正记录 | 13.012秒 | A | 65.14% | A / S / N |
| CN4_CH1_RLD修正记录 | 14.732秒 | 伪迹 | 99.82% | 伪迹 / 伪迹 / 伪迹 |
| CN4_CH1_RLD修正记录 | 15.090秒 | S | 50.14% | S / S / N |

人工查看本次滤波波形可见CN4约12.4–12.8秒、14.5–14.9秒有明显突变和振荡，四个非N输出位于这些干扰及其附近。A和S分别发生种子间分歧，不能把它们直接认定为真实早搏。CN2全部分类目标的三份权重输出一致为N。
XQRS与GQRS在已分类目标上均能在±100ms内匹配；两种检测器一致不能证明候选是真实QRS，干扰也可能同时触发两者。训练用参考标注并从生理RR事件流排除伪迹，本次自动定位可能将干扰纳入RR，从而影响附近A/S输出。因此现阶段不能以模型输出反推这些异常的医学真值，也没有通过删除模型不喜欢的候选来改写主结果。

## 已有优选10秒的独立范围统计

此处是在完整记录上滤波、推理后按原始时间范围统计，不把优选片段重新当独立记录或独立受试者。范围来自采集时已保存的质量文件，未按此次类别预测挑选。

| 记录 | 原始时间范围 | 已分类目标 | 预测 |
|---|---|---:|---|
| CN2_CH2_最新记录 | 4.5–14.5秒 | 10 | N 10，其他 0 |
| CN4_CH1_RLD修正记录 | 2.0–12.0秒 | 12 | N 12，其他 0 |

## 怎样理解结果

- 这两段没有逐拍专家标签，无法计算准确率、精确率或召回率。表中分数为未经校准的softmax值，不是正确概率，也不是诊断置信度。
- 自动定位、硬件导联与训练库导联差异都是额外误差来源；双向滤波及未来RR使本次属于离线推理，不能直接代表板端实时效果。
- 模型历史验证中L/R及部分少数类效果仍差，“本次没有预测到某类”不等于已经可靠排除该类。
- 两段来自同一位受测者，无疾病/健康真值，不能据N输出将其补成健康人训练标签。
- 完整波形与逐拍分数见各记录子目录；逐拍CSV保留原始时间、样点、类别概率、不同种子输出及启动/末尾标记。输入文件和权重SHA256见summary.json。

主结果：CN2输出稳定为N；CN4以N为主，干扰附近出现两个伪迹候选及两个不稳定A/S预测，需要复核，不能直接作为真实早搏结论。
