rentommy/2026-fpga-dual-channel-ecg/archive/original_code/model_training/item_d83a071a9a27/item_4dee78733e71/item_e859b111ad86.md

# 第一阶段：数据与评估改进

本项目只读引用原复现资料。原模型和原始数据未修改。

## 已完成的数据工作

- 原始数据重建 120,777 个窗口，逐行比较后，四份旧训练 CSV 的波形全部一致（float32，差异阈值 1e-6）。因此新记录编号、导联、窗口起点与旧波形的对应关系有实证。
- 固定标签并列处理后，293 个窗口改变标签。旧规则使用 set 后取最大值，并列时未定义稳定优先级，新规则按固定类别顺序决定。
- 排除 445 个原始含缺失值窗口和 2,102 个其余 Q 窗口，最终 118,230 个可用窗口。445 个缺失窗口中有 33 个原来带非 Q 标签。此次不把这些样本填零后送去训练。
- 数据与全部原始源文件校验值见 `data/manifest.json`，数组校验值见 `audit/dataset_integrity.json`，旧版差异见 `audit/legacy_inventory.json`，逐行重建比较见 `audit/rebuild_comparison.json`。

## 固定划分

使用数据库名加记录编号分组，MIT 201/202 保守并为一组。尚未核实其他跨记录、跨数据库的受试者身份，所以这是记录隔离基线，不能声称已完成严格受试者独立验证。

| 集合 | 窗口 | 组数 | A 窗口 |
|---|---:|---:|---:|
| 训练 | 72,314 | 80 | 996 |
| 验证 | 22,448 | 32 | 325 |
| 测试 | 23,468 | 20 | 354 |

划分索引无重复，合格窗口全部且仅分配一次，各集合之间无记录组交叉。

初始固定种子划分后，按预先定义的标签覆盖规则将记录 207 从训练移到测试，以补齐 L 类。此调整只使用标签和记录长度，未使用模型成绩。初始划分和调整轨迹均保留。

**B 类的 5,261 个合格窗口全部来自猝死库记录 36。现有数据不能做 B 类记录隔离的三集合评估。** 当前将其留在训练，验证和测试覆盖另外六类。L/R 也仍只来自少量记录，不能把窗口数量当成独立受试者数量。

模型仍输出七类。固定七类 macro-F1 包括无真实 B 支持的零项，因此还同时报告有支持类别的六类 macro-F1。选点使用固定七类 macro-F1，在 B 缺失固定的情况下与六类版本仅相差常数比例。不把这两种口径混用，也不与旧随机窗口划分成绩直接宣称同条件提升。

## 对旧模型的逐窗口诊断

使用保存的 w07 最优权重，恢复其原始随机窗口测试集。此处仅用于核查旧结论，不是新的独立验证结果。

| 旧测试集房早分层 | 窗口 | 检出 | 召回率 |
|---|---:|---:|---:|
| 全部 A | 164 | 83 | 50.61% |
| 只有一个 A | 74 | 25 | 33.78% |
| 至少两个 A | 90 | 58 | 64.44% |

这支持“单个 A 更难检出”，但不支持“单个几乎全部漏检、多个基本能识别”。单个 A 仍有 25 个被检出，多 A 仍有 32 个漏检，不能据总体占比推断每个窗口的结果，更不能据此认定已达到性能上限。

总体准确率为 95.18897%，与旧报告四舍五入后的 95.19% 一致。完整混淆矩阵有两个窗口的预测差异，分别涉及 N 和伪迹；A 行完全一致。当前 CPU float32、框架和旧 GPU 混合精度环境不同，尚未单独隔离出数值差异的来源。

旧样本中，非边界 A 召回率 50/106（47.17%），边界 A 为 33/58（56.90%）。不能据此把窗口边界视为主要漏检原因，仍需新验证集与按记录分层核对。

进一步检查发现，模型的 A 类是原始 A 与 S 的合并类别，不能把 50.61% 直接当作原始 A 标注的识别率。旧测试集中，原始 A 窗口为 55 个、检出 39 个（70.91%）；由 S 映射来的窗口为 109 个、检出 44 个（40.37%）。原始 A 在这里来自 MIT-BIH Arrhythmia，S 来自其他数据库，数据库与标注子类型混杂，无法由此单独确定差异原因。

按数据库分层的 A 类召回率：European ST-T 为 13/48，MIT-BIH Arrhythmia 为 39/55，MIT-BIH ST Change 为 30/40，Sudden Cardiac Death 为 1/21。这提示来源差异也值得重点核查。按单 A 在窗口中的位置分成五个两秒区间后，未看到清楚的单调位置趋势，样本量较小，不据此确认或排除 LSTM 的信息保留问题。

诊断文件位于 `audit/historical_w07/`。其中沿用公共分析函数的 `val_*` 文件名，但这部分实际是旧随机测试集，`reproduction.json` 和 `analysis.json` 已明确其范围。波形图红线表示原标注 A/S 的位置。

## 基线训练

原网络 44,507 参数不变，N 权重固定 0.7，seed=0，最多 60 轮、验证 macro-F1 选点、10 轮早停。未依据新测试结果调参。

正式 GPU 基线已完成：第 39 轮早停，回载第 29 轮权重。CPU 七轮记录只作流程检查，未读取新测试集，不参与最终模型选择。

| 集合 | 准确率 | 有支持六类 macro-F1 | 固定七类 macro-F1 |
|---|---:|---:|---:|
| 验证 | 79.67% | 0.3256 | 0.2791 |
| 测试 | 61.06% | 0.2704 | 0.2318 |

同一个最优模型在训练集上的准确率为 97.18%，七类 macro-F1 为 0.9120。训练集拟合良好、记录隔离验证和测试明显下降，说明当前存在严重的跨记录泛化问题。测试集全猜 N 的准确率参考约为 79.56%，当前模型连这一单项准确率参考也未超过，异常识别与误报取舍还没有解决。

测试集 A 为 7/354（召回率 1.98%），精确率 0.50%；正常窗口中有 1,323 个误报为 A。此权重作为基线留档，不替换现有部署模型。

新验证集逐窗口分析：单 A 为 5/258（1.94%），多 A 为 13/67（19.40%）。A/S 子类型分层：原始 A 为 18/115（15.65%），由 S 映射来的为 0/210。记录 45 单独贡献了 197 个 A 类验证窗口且全部漏检，表明少数来源记录会强烈影响窗口级汇总指标。不能把 325 个验证窗口等同于 325 个独立个体。

代码、环境、固定划分、训练历史、最优模型、逐窗口预测、波形图、分类指标和按记录重采样统计均保存在 `runs/record_baseline_seed0/`。`pipeline_snapshot.py` 与 `model_snapshot.py` 保存正式训练时的代码，校验值与运行配置一致。

这些结果建立了更严格的评估基线，尚未取得模型识别提升。旧 95.19% 和新 61.06% 的差异包含划分、标签并列处理及质量筛查变化，不能把差值全部定量归因于其中某一因素。

## 后续决策

先看新记录隔离验证集的单 A、多 A 与来源记录差异，确认历史困难模式是否仍成立。再决定 RR 输入、逐拍上下文或窗口内聚合实验。B 类需要更多独立记录，或另行明确任务重定义后才能解决其评估缺口。当前阶段没有把七类悄悄合并，也没有把记录拆散以补齐测试样本。
