rentommy/2026-fpga-dual-channel-ecg/archive/original_code/model_training/item_d83a071a9a27/item_ed75d2c9f693/item_d72e43be8697.md

# 下一轮分类范围

更新：七输出模型已在 `../reference_04` 实现并训练，后续五项对照位于 `../study_05`。下文“尚未训练”描述的是本范围文件最初生成时的状态。

按照用户最新授权，暂时排除原始 B、S 的目标识别，保留 A/F/L/N/R/V 和伪迹质量类别 |，共七个输出。六种心拍类型与一个质量类别分别解释。

B 在本轮数据库没有样本，其他现有资料也仅单记录来源；S 在本轮只有同一记录的两拍。其他数据库的 S 不代表永久排除，审核导联和标签后可重新纳入。

F 有 767 个训练目标、10 个训练来源组，不能因为测试仅 14 拍或成绩低就认定无法训练并删除。L/R 各有数千训练拍，保留并针对跨受试者泛化继续诊断。

有效目标索引.csv 对应第三轮冻结数组的原始索引，label_id 为本轮七类新编号。排除的目标不改标为 N，也不从用于时间间隔的原始候选序列中删除。旧模型仍为九输出，不能直接套用新编号。

本次已完成范围配置和目标索引生成，尚未训练七输出模型；没有产生新的识别成绩。原第三轮测试已查看，这里的划分只能继续用于开发诊断，后续正式验收需要另行设计独立验证。
