rentommy/2026-fpga-dual-channel-ecg/archive/original_code/model_training/item_d83a071a9a27/reference_04/item_1c06e8ed5c4b.md

# 参考项目结构改编：七输出验证结果

同一逐拍输入、同一训练/验证受试者、同一 RR 分支、权重和训练预算。B/S 已从目标及输出移除。仅一个随机种子，不能据此证明稳定提升。未重新评估旧测试集。

| 模型 | 验证准确率 | 验证 macro-F1 | A 精确率 | A 召回率 | L 召回率 | R 召回率 |
|---|---:|---:|---:|---:|---:|---:|
| cnn | 69.18% | 0.4016 | 55.18% | 18.49% | 0.00% | 8.00% |
| gru | 72.50% | 0.4223 | 64.57% | 24.70% | 0.00% | 13.61% |
| se_gru | 73.58% | 0.4361 | 75.34% | 25.90% | 2.31% | 17.30% |

模型为结构思路改编，不能称为原 TensorFlow 项目的等价复现。此前九输出实验与这里的七输出实验也不是仅改变结构的严格对照；严格对照限于本表三行。

## 如何解释

本次单种子对照中，CNN＋SE＋GRU 的 macro-F1 比 CNN 高 0.0345，比 CNN＋GRU 高 0.0138。这支持继续验证该结构，但尚不能证明稳定泛化提升。

最优结构的 A 精确率 75.34% 表示被判作 A 的样本中约四分之三正确；召回率 25.90% 表示实际 A 仍有约四分之三漏掉。L/R 精确率分别 51.58%/67.68%，召回率却只有 2.31%/17.30%。不能只报告较高精确率。

V 精确率 76.25%、召回率 83.72%；F 精确率仅 3.69%、验证支持仅 21 拍。F 训练有 767 拍、10 个来源组，继续保留，但需要针对性检查误报与验证来源覆盖。

下一步先重复随机种子，并审核 A/L/R 验证集错误波形；本轮不再按旧测试集挑方案，不替换已有部署权重。

原项目读取结果、文档与代码差异，以及哪些处理采用或舍弃，详见 [参考项目审阅](参考项目审阅.md)。
