rentommy/2026-fpga-dual-channel-ecg/archive/original_code/model_training/item_d83a071a9a27/research_06/item_ca6687ef7659.md

# 公开模型、补充数据与下一版方案

更新：2026-10-24。本轮是文献/作者代码核查、原始数据下载和现有预处理审计；尚未训练新模型，不能将论文成绩作为本项目成绩。

## 判断

样本不足有明确依据，但主要是**特定类别的独立患者不足**。当前 MIT-BIH 训练集中 L、R 各只有两个来源组，重复抽拍或加噪声不能增加患者多样性。上一轮三种子 macro-F1 从 0.4360 到 0.4410，且一个种子下降，不能确认稳定收益。

还不能排除输入表示、类别定义和采集差异的影响。单纯下载更多 N/V 样本，不能解决 L 类没有新患者的问题。

## 现有预处理的具体问题

1. `benchmark_03/benchmark.py` 把 `|` 纳入 EVENTS，随后直接在全部事件位置上计算 RR 和中点。`|` 是类似 QRS 的伪迹，不是真实心拍。[官方标注定义](https://physionet.org/static/lightwave/doc/annotations.html)。本轮逐条核查：100,503 个真实目标心拍中，218 个的直接相邻事件包含伪迹（N190、V15、L11、R2）；过去八个间期的参考值还可能受到更远影响，本统计未计入。它是需要修复的问题，但没有重训证据证明它是主要低分原因。证据：`existing_rr_audit.json`、可重跑的 `audit_existing_rr.py`。
2. `study_05/study.py` 第90行使用 `warped` 波形。前后半周期被分别拉伸到固定点数，因此原始 QRS 宽度不能直接从波形横轴读取。RR 虽包含部分时间信息，但不能假定网络能恢复局部时长。此前 benchmark 已有真实时间轴对照，并非从未试过；下一轮需要在同一个较强模型上比较两种表示。
3. 每拍单独除以标准差会丢失绝对幅值；是否有害需对照，不是已证实原因。中点切分只保证一个中心事件，不保证完整 P–QRS–T 生理边界，早搏需要专项检查。
4. 现有 post-RR、后一个中点和零相位滤波会使用未来信号。离线分类可以使用，在线 FPGA 流程必须明确延迟，或另做只用过去信号的版本。

本轮保留旧数据及权重以供复现，未偷偷覆盖。上述 RR 问题仍在旧冻结版本中，新版预处理必须先修复再训练。

## 值得实现的模型

| 优先级 | 公开依据 | 拟借鉴内容 | 本项目的使用边界 |
|---|---|---|---|
| 1 | [DAEAC 作者仓库](https://github.com/chenmingTHU/DAEAC)，对应 2021 年 [Neurocomputing 论文](https://www.sciencedirect.com/science/article/abs/pii/S0925231221006627) | 多尺度空洞卷积、残差、注意力；配合独立 RR 分支 | 先实现监督学习版本。仓库 ACNN 默认四输出，必须重设输出及导联适配；不是拿现有权重直接预测七类 |
| 2 | [Tiny Matched Filter CNN，Sensors 2023](https://pmc.ncbi.nlm.nih.gov/articles/PMC9919183/) | 训练集模板初始化卷积核，小型波形网络与归一化 RR 融合 | 更适合后续 FPGA；论文报告 98.18% 准确率属于 N/SVEB/VEB 三个大类，不是保留 L/R 的任务。模板只能从训练患者提取 |
| 3 | [Adversarial CNN，2021](https://pmc.ncbi.nlm.nih.gov/articles/PMC8181174/) | 心拍分类同时抑制受试者身份信息，学习跨患者表示 | 论文 SVEB/VEB 召回约78.8%/92.5%，分类口径不同；本次未确认作者代码。当前类别与患者高度相关，过强身份抑制可能伤害类别信息，因此放在补数据之后 |

核查 DAEAC 的 [ACNN.py](https://github.com/chenmingTHU/DAEAC/blob/master/src/model/ACNN.py) 可见残差、多膨胀率模块和四类输出；[train.py](https://github.com/chenmingTHU/DAEAC/blob/master/train.py) 明确加载目标域并生成伪标签。因此其域适应实验接触目标域无标签数据，不能当成“完全未见外部患者”的同一协议。预处理文件包含中值滤波与小波函数，但运行入口启用的是中值去基线，不能误写为两者均使用。标准 DS1/DS2 中201/202必须重新保持同患者同组。

上述是有文献支持的候选结构，不是已证明优于当前模型的排名；顺序按本项目问题与实现可行性安排。暂不优先堆大 Transformer。

## 下一版具体设计（待实现、待验证）

**标签仍逐拍对应。** 保存原数据库的每一个原始符号，不把十秒片段赋一个标签，不把 S 改为 A，也不把 L/R 合并为 N 来提高分数。伪迹走独立质量输出或保留显式质量类别；真实 RR 只在真实心拍事件间计算。新增 S 有充分来源时可以恢复 S 输出，但要登记新的任务版本，不能拿不同类别集合直接比较成绩。

**先统一物理单位和时间轴。** 按头文件增益转 mV，分别保留导联身份；MIT 的 MLII、INCART 的 II、SVDB 的 ECG1 不能默认等同。按原采样率滤波，再用抗混叠重采样统一到256Hz，精确映射标注。256Hz 是拟定工程参数，不代表给128Hz数据创造新信息。0.5–40Hz带通与0.2/0.6秒中值去基线作为两种独立对照，仅在训练/验证患者上决定。

**真实时间轴单拍作为主输入。** 候选初始范围中心前0.30秒、后0.50秒，受到相邻真实心拍中点约束；只对中心心拍输出标签。短周期补零并提供有效掩码，池化排除无效区，不能再次把变长心拍整体压缩到同一长度。检查截断比例、宽 QRS 覆盖与标注对齐；INCART 官方指出标注位置可能偏移，局部对齐只在受限邻域内完成，不能跨到邻拍。保留原标注和校正量供审计。

**模型第一版。** 波形分支采用三个不同感受野的一维卷积、3个残差块（初始通道32/64/128）、轻量通道注意力及掩码池化；时间分支为 RR 小型 MLP，再融合分类。先不用 GRU，控制规模。输入比较“局部去中心的 mV / 训练集尺度”与“逐拍标准化”，后者额外保留原幅值尺度。再实现模板卷积作为轻量对照，所有模板仅来自训练组。以上尺寸是拟定配置，不是原论文逐字复现。

**跨库使用。** 相同原始标签可以纳入共同监督，但保留来源/患者/导联分组；S 与 A 可使用共享编码器、分开的原始标签输出，不能强行映射。需要先预留外部测试患者，再在剩余来源预训练或混合训练。不能把整个新库都用于训练后又宣称其为外部测试。SVDB 无法确认患者身份时只能报告按记录隔离的限制，或整体保留为外部数据，不能声称78个独立患者。

## 验收与实验顺序

1. 冻结原始标签、患者分组和新增外部测试清单；检查重复波形、同患者多记录、201/202。新增数据的标签盘点属于数据审计，不用外部模型成绩挑方案。
2. 修正 RR 事件流；分别验证采样率转换、中心位置、质量标签和物理时长。用原模型在修正输入上做对照，区分数据修复与换模型的收益。
3. 在相同数据、相同患者划分上比较原 SE-GRU、多尺度残差＋RR、模板卷积＋RR；至少三种子，同时报告按心拍和按患者汇总的指标。
4. 固定结构后比较只用 MIT 与增加训练患者，判断补数据是否真正有效。训练平衡采样不改变测试集自然分布。
5. 最终才评估封存的外部患者。总体准确率 **≥80% 是用户目标，不是保证**；同时必须列出各类精确率/召回率、macro-F1、混淆矩阵、患者覆盖和每患者结果。建议将 macro-F1≥0.80 作为另一个努力目标，但不能擅自当成用户已经确认的验收标准。

原测试集全猜 N 已约75.43%，所以仅达到80%总体准确率仍不能证明各类能用。旧测试已在历史实验中使用，不能重新包装成未见测试。

## 新数据交付与仍缺什么

下载和实际统计见 [样本目录](../../样本/) 中的 `数据下载与覆盖报告.md`、`data_audit.json`。保存原始 `.dat/.hea/.atr`、文件来源/版本、SHA256回执和逐记录清单。SHA256回执用于后续完整性核对，不冒充发布者提供的独立校验值；另逐导联核对 WFDB 头文件校验和。

优先补充带独立患者ID、采样率、导联名称、原始波形、每拍位置及原始类型的 **L 类数据**，其次关注 R/A/F 的患者覆盖。不要提供只有整条记录“LBBB/RBBB诊断”的文件就直接给每一拍贴 L/R 标签。每类先争取十余名不同患者是工程性收集起点，不是保证80%的统计门槛；需要患者级学习曲线决定是否继续增加。

[Icentia11k 官方数据](https://physionet.org/content/icentia11k-continuous-ecg/1.0/) 可作为后续大规模表示学习候选，但它不能直接补齐原始 L/R 标签，当前未下载。PTB-XL/CPSC 的记录级诊断也不能替代逐拍类型；本轮没有用这些诊断制造伪逐拍标签。
