rentommy/2026-fpga-dual-channel-ecg/archive/original_code/model_training/item_d83a071a9a27/research_10/item_6506ff72138c.md

# 网上公开项目核查与可借鉴方案

核查日期：2026-10-24。本文是文献与源代码审阅，不是新的训练结果。公开成绩均为作者或仓库报告，本地没有运行这些第三方训练程序，也没有验证其权重成绩。已保存五个仓库的部分源代码，见 `sources/`；各目录 `provenance.json` 记录来源、引用分支/标签、Git tree SHA及文件SHA256。Git tree SHA不是已核实的commit SHA。只下载用于阅读的文件，未安装第三方依赖、未加载第三方权重。

## 结论与优先次序

最值得先复现的是论文作者的形态特征＋RR＋SVM集成，用它建立可解释、能逐项对照的数据处理基准。患者个性化校准可作为另一条有条件的路线：需要目标患者的真实标签。序列网络可以研究，但应按实际时间顺序构造邻拍，不能直接照搬下面查出问题的序列构造代码。

当前六库211万个目标已经说明：总拍数增加本身没有解决L/R等类别。新增样本主要是N，缺少的更可能是有效的异常类别患者覆盖、跨患者一致的形态表示和标签监督。此处是根据本地数据覆盖及结果作出的判断，不是已经证实的唯一原因。

## 1. 首选基准：Mondejar论文作者项目

来源：[公开代码](https://github.com/mondejar/ecg-classification)，[论文DOI](https://doi.org/10.1016/j.bspc.2018.08.007)。

仓库报告集成准确率94.5%；采用逐拍分类、DS1/DS2记录划分。具体流程是中值滤波估计基线并相减、标注点附近对齐，再提取波形形态与RR特征，分别训练SVM并融合。标准化仅拟合训练特征。值得借鉴的是完整链路及分支贡献，不应只取一个模型名字。

核查注意：四类任务中L/R并入N，不能据此证明原始L/R识别。源码还把e/j放入SVEB，复现时必须照实记录映射，不能笼统称与所有AAMI实现完全一致。沿用旧DS1/DS2时201/202分在两边，但实际属于同一患者。本项目应保留已修正的患者分组，另外明确报告与原协议的差别。

本地证据：`sources/mondejar__ecg-classification/python/load_MITBIH.py`，461行附近搜索范围20点，482–487行标签映射，530行后基线处理，560行后对齐；`python/train_SVM.py`中训练集拟合StandardScaler及SVM训练；`python/features_ECG.py`为特征定义。

移植时有两点不能原样套用：原对齐在约±56ms内寻找正向最大值，负向QRS可能不适用；部分RR统计依赖整条记录，包含未来信息，属于离线条件。我们的双向滤波本来也属于离线处理，后续实时FPGA版本需另做因果链路评估。旧工程需要适配现代Python/sklearn，复制修改需保留GPL-3.0相关许可要求。

此前本项目的粗粒度波形SVM对照不等于这篇作者方案的完整复现，不能因为已有一个SVM结果差就排除本路线。

## 2. 有条件可用：患者个性化分类

方法依据：[Kiranyaz等2016论文](https://pubmed.ncbi.nlm.nih.gov/26285054/)；本次核查的现代开源实现：[patient-specific-ecg-classification](https://github.com/andrelopes2001/patient-specific-ecg-classification)。后者不是前者的原作者代码，也不是严格复现同一个网络。

该实现用约2.8万参数MLP，先训练公共模型，再以目标患者前5分钟的已标注心拍微调，评估后续部分。仓库报告四类AAMI准确率97.8%、macro-F1 0.857；无个性化模型报告79.0%、0.379。这是有标签校准条件，不能作为无需校准的新患者成绩，更不能直接套用于当前八输出任务。

源码 `src/ecg/train.py`实际以校准段标签训练，并只在该段拟合个体缩放参数。`src/ecg/config.py:18`之后仍把201/202分开，移植时要修正。还需审计分割规则对邻拍过近样本的排除，避免提前搏动困难样本被选择性过滤。

适用场景：固定佩戴者、允许人工审核一小段校准数据。保持L/R原始标签；不能把患者主要形态自动当成N。校准段没有出现的异常类型仍需公共训练样本支撑，并可研究回放公共训练样本以减少遗忘。无法提供患者标签时，不把该成绩作为目标承诺。

## 3. 有启发但不能直接照搬：CNN＋序列模型

来源：[Mousavi等论文](https://arxiv.org/abs/1812.07421)、[作者代码](https://github.com/MousaviSajad/ECG-Heartbeat-Classification-seq2seq-model)。论文研究CNN结合seq2seq进行逐拍分类，兼顾波形与拍间关系。

但核查的 `seq_seq_annot_DS1DS2.py:68–84` 先依据真实类别分组并拼接数据，再切成序列；由此生成的序列不是真实相邻心拍。按这个数据入口训练和测试，会形成部署时无法保证的类别聚集上下文。这是对所读脚本的具体观察及风险推断，不代表所有序列模型都有此问题。

同文件117行的ACC是每类one-vs-rest的(TP+TN)/总数，后续还计算平均值，不能与普通“预测正确拍数/总拍数”混用。已检查推理部分自行反馈预测，不能把问题误写成“推理直接输入测试真标签”。旧代码还依赖Python2/TF1。

可借鉴的设计：按记录真实时间顺序输入多拍，每个输出仍只对应一个中心拍；邻拍真实标签不得成为输入。比较单拍、单拍＋RR、真实邻拍三组，才能确认序列信息是否提供有效增益。这个方向尚未在本轮实现。

## 4. 两个99%以上项目为什么暂不选为效果依据

| 项目 | 公开成绩/结构 | 实际核查 | 处理意见 |
|---|---|---|---|
| [mazder1/ECG](https://github.com/mazder1/ECG) | 五类CNN＋Transformer报告99.26% | 五类标签版本`v1.0.1-5class`的`data/dataset.py:94`使用心拍random_split；仓库另有按患者划分的二分类，任务不同 | 可参考工程组织；五类高分不能当作患者隔离八类基准 |
| [nishujayaraj/ECG-Arrhythmia-Classification](https://github.com/nishujayaraj/ECG-Arrhythmia-Classification) | 14类LSTM报告99.73% | 升级notebook先对完整样本SMOTE，再随机分训练/验证/测试，存在数据泄漏风险 | 不把该高分作为新患者L/R识别证据；不采用该过采样顺序 |

第二个项目的本地只读代码摘取为 `ECG_Arrhythmia_Upgraded.code.txt`：129行fit_resample，144行生成平衡数组，151–155行才train_test_split。未执行notebook。正确的对照应先按患者分组，再仅对训练集做需要学习数据分布的处理。对任一单独心拍执行固定滤波与训练集过采样的性质不同，不能一概称预处理都是泄漏。

## 5. 对当前项目的具体判断

目前experiment_09六库三种子合并测试准确率97.08%，八类macro-F1仅0.3956；L召回0%，R约0.05%。这些旧实验结果没有因本次搜索发生改变。N大量增加后总体准确率升高，不能解释为原始心拍类型都分好了。

网上常用AAMI的N/S/V/F与用户要求的原始标签任务不同：L/R通常归入N，A等归入S，伪迹符号也不等同于其Q类。做标准四类复现只能作为单独的核对实验，不能替换原始八类成绩，更不能把A/S合并后宣称完成原目标。

我另行检查了“当前A识别差是否因为中点截断普遍剪掉前方波形”：MIT验证1498个A中，仅1个有效前方上下文少于200ms，全部不少于160ms，中位数约301ms。因此当前证据不支持把A失败主要归因于普遍缺少前方窗口。这个检查只统计有效窗口长度，不能替代P波定位、对齐及导联质量检查。明细见 `input_context_audit.json`。

也没有证据支持“只要再增加总体拍数就能超过80%各类识别”。补数据应优先看每类的独立患者数、导联及标注兼容性；同一少数患者复制或合成很多拍，不等价于增加新患者形态。

## 6. 建议下一轮按此顺序做

1. **先建立作者方法对照。** 以MIT原始波形实现Mondejar处理、显式形态/RR与SVM融合；保留患者201/202同组。另列作者式粗类核对，最终判断仍用当前原始八类，逐类报告precision/recall/F1、患者覆盖及混淆方向。不要把合并标签后的提升写成原标签提升。
2. **用同一划分定位处理环节。** 先固定模型比较现有双向滤波与参考基线去除；再单独比较局部对齐、波形幅值处理、形态特征、RR。保留原标签归属，检查对齐是否跳到邻拍。类别平衡仅依据训练数据，先不引入SMOTE合成。
3. **形态基准有效后再改网络。** 将有效形态/RR与轻量CNN融合，并可比较真实邻拍序列。另一项待验证设计是粗类辅助监督＋原标签细分类：来源仅有粗S标签时只训练其父类，不能强行生成A；L/R继续保持各自输出。此项是本项目建议，不是已验证的论文复现结果。
4. **个性化另立实验。** 只在确实允许目标患者带标签校准时评估前若干分钟适配，并把校准段完全从后续评分中排除。无校准与有校准分别报告。

模型选择只使用训练/验证部分。现有测试集合已在历史实验中查看多次，未来结果不得称为从未接触过的最终独立测试；具备条件时补充新患者数据做外部确认。本轮没有启动新训练，也没有更换现有部署权重。

患者身份事实来源：[PhysioNet MIT-BIH官方说明](https://physionet.org/files/mitdb/1.0.0/mitdbdir/intro.htm)。
