rentommy/2026-fpga-dual-channel-ecg/archive/original_code/model_training/item_d83a071a9a27/study_05/item_1c06e8ed5c4b.md

# 第五轮：五项改进的开发验证

七输出：A/F/L/N/R/V/|。旧测试未评估；以下仅为反复使用的开发验证成绩，不能当作独立测试。

| 单种子方案 | 准确率 | macro-F1 | A 精确率 | A 召回率 | L 召回率 | R 召回率 |
|---|---:|---:|---:|---:|---:|---:|
| balanced_all | 69.68% | 0.4468 | 73.01% | 37.92% | 0.14% | 18.75% |
| balanced_noise | 71.50% | 0.4340 | 56.39% | 37.72% | 0.05% | 18.39% |
| balanced_scale | 71.99% | 0.4435 | 70.08% | 36.11% | 0.00% | 17.66% |
| balanced | 64.21% | 0.4205 | 63.88% | 35.18% | 0.05% | 16.52% |
| balanced_shift | 71.78% | 0.4369 | 63.28% | 27.84% | 0.00% | 18.60% |
| baseline | 73.66% | 0.4275 | 65.77% | 21.16% | 1.13% | 19.69% |
| feature_fusion | 71.76% | 0.4448 | 66.20% | 34.78% | 0.00% | 19.74% |
| morph_only | 71.68% | 0.3196 | 34.46% | 13.62% | 0.00% | 17.25% |
| rr_only | 60.42% | 0.3229 | 14.78% | 1.13% | 0.09% | 0.00% |
| uniform | 73.99% | 0.4298 | 80.35% | 18.56% | 0.28% | 15.17% |

预定规则选择：balanced_all。对照关系：baseline↔uniform 检查损失权重；uniform↔balanced 检查采样；balanced↔三个单项增强检查各增强；baseline↔morph_only/rr_only 检查输入信息；baseline↔feature_fusion 检查显式形态特征。balanced_all 是预先列入的组合实验。

| 三种子配置 | macro-F1 均值 | 种子标准差 | A 召回均值 | L 召回均值 | R 召回均值 |
|---|---:|---:|---:|---:|---:|
| baseline | 0.4360 | 0.0065 | 31.24% | 0.74% | 15.65% |
| balanced_all | 0.4410 | 0.0395 | 19.87% | 19.17% | 16.73% |

标准差只反映本次三个训练种子，不是受试者置信区间，也不替代多个受试者划分。每位受试者和每个类别的分数见各运行目录 per_patient.csv。
全体方案使用相同中心标签、同一受试者划分。采样和增强仅用于训练；RR/形态特征缩放仅拟合训练。形态分支消融通过将 RR 输入置零实现，保留网络容量；RR-only 使用独立小 MLP，既改变输入也改变容量，不能将差值全部归因于某一类信息。
手工形态特征取原时间轴中心前后约150ms区域，包括幅值、斜率、能量宽度等描述量；能量宽度不是经过人工验证的 QRS 起止时长。
没有使用波形翻转、邻拍标签或测试成绩选配置。当前仍为专家候选定位、离线滤波与后续 RR 条件。
