rentommy/2026-fpga-dual-channel-ecg/archive/original_code/model_training/item_d83a071a9a27/runs/beat_center_only_seed0/item_1c06e8ed5c4b.md

# 逐心拍模型实验结果

每条训练标签仅来自中心候选心拍的原始标注，不做窗口投票。相邻心拍只提供上下文。

| 集合 | 准确率 | 有支持类别 macro-F1 |
|---|---:|---:|
| 验证 | 86.16% | 0.2600 |
| 测试 | 80.10% | 0.2715 |

| 类别 | 测试样本 | 精确率 | 召回率 | F1 |
|---|---:|---:|---:|---:|
| A | 202 | 0.2247 | 0.2525 | 0.2378 |
| B | 0 | 无法估计 | 无法估计 | 无法估计 |
| F | 8 | 0.0000 | 0.0000 | 0.0000 |
| L | 1451 | 0.0000 | 0.0000 | 0.0000 |
| N | 239540 | 0.9845 | 0.8174 | 0.8932 |
| R | 1333 | 0.7378 | 0.5424 | 0.6252 |
| S | 524 | 0.0211 | 0.1813 | 0.0378 |
| V | 3629 | 0.1645 | 0.5616 | 0.2544 |
| \| | 4045 | 0.0702 | 0.5295 | 0.1239 |

B 独立来源不足，缺类指标不能作泛化结论。记录身份仍不是经完全核实的受试者身份。
使用专家标注定位和构造 RR，属于理想定位的离线评估；还需独立验证自动检测和真实采集。
逐心拍指标与历史十秒窗口指标的任务单位不同，不能直接相减宣称提升。
