rentommy/2026-fpga-dual-channel-ecg/archive/original_code/model_training/item_d83a071a9a27/runs/beat_context_seed0/item_1c06e8ed5c4b.md

# 逐心拍模型实验结果

每条训练标签仅来自中心候选心拍的原始标注，不做窗口投票。相邻心拍只提供上下文。

| 集合 | 准确率 | 有支持类别 macro-F1 |
|---|---:|---:|
| 验证 | 94.49% | 0.3366 |
| 测试 | 91.04% | 0.3199 |

| 类别 | 测试样本 | 精确率 | 召回率 | F1 |
|---|---:|---:|---:|---:|
| A | 202 | 0.5254 | 0.3069 | 0.3875 |
| B | 0 | 无法估计 | 无法估计 | 无法估计 |
| F | 8 | 0.0024 | 0.2500 | 0.0048 |
| L | 1451 | 0.0000 | 0.0000 | 0.0000 |
| N | 239540 | 0.9861 | 0.9258 | 0.9550 |
| R | 1333 | 0.0000 | 0.0000 | 0.0000 |
| S | 524 | 0.0348 | 0.7366 | 0.0665 |
| V | 3629 | 0.4168 | 0.6498 | 0.5078 |
| \| | 4045 | 0.4898 | 0.9145 | 0.6379 |

B 独立来源不足，缺类指标不能作泛化结论。记录身份仍不是经完全核实的受试者身份。
使用专家标注定位和构造 RR，属于理想定位的离线评估；还需独立验证自动检测和真实采集。
逐心拍指标与历史十秒窗口指标的任务单位不同，不能直接相减宣称提升。
