rentommy/2026-fpga-dual-channel-ecg/archive/original_code/model_training/item_d83a071a9a27/study_05/waveform_review/item_84178325a9dd.md

# 波形和错误审核

按 A/L/R 的每条验证记录生成原始波形、固定时宽处理结果、网络实际输入三列对照。每张图固定选第一个训练参考及该记录第一个正确/错误目标，不按外观挑图。
所有选中样本均重新核对原始标注并重建滤波与归一化输入，数值一致。此前完整数据核查也通过；这些检查能排除所查样本的标签索引和数组构造错误，不能证明切分/滤波在生理信息上最优。

| 类别 | 验证记录 | 拍数 | 正确数 | 召回率 | 最常预测为 |
|---|---|---:|---:|---:|---|
| A | 100 | 33 | 33 | 100.00% | A |
| A | 124 | 2 | 1 | 50.00% | A |
| A | 215 | 3 | 2 | 66.67% | A |
| A | 219 | 7 | 1 | 14.29% | N |
| A | 223 | 72 | 43 | 59.72% | A |
| A | 232 | 1381 | 308 | 22.30% | N |
| L | 111 | 2121 | 49 | 2.31% | N |
| R | 124 | 1529 | 0 | 0.00% | N |
| R | 232 | 396 | 333 | 84.09% | R |

图中红线为专家标注位置，不保证是 R 波正峰。固定窗与周期边界可能丢失远离中心的波形，周期缩放会改变相对时宽；本轮不据个别图随意删除困难记录。
未引入自动 P/QRS/T 起止检测；后续显式特征只称为局部形态描述，不能当作临床 QRS 时长。

实际查看 L_111、R_124、A_232 三组图后：所选目标均位于输入中心附近，未见标签索引整体错位。训练参考与验证记录的峰谷比例、局部波形及 RR 有明显差异；同一记录也能同时出现正确与错误预测，因此不能仅凭少量图确定唯一原因。A 的 1498 个验证目标中 1381 个来自 232，R 的 1906 个目标中 1529 个来自 124，汇总成绩会被这些记录主导。
