rentommy/2026-fpga-dual-channel-ecg/archive/original_code/model_training/item_d83a071a9a27/item_4dee78733e71/runs/record_baseline_seed0/item_1c06e8ed5c4b.md

# 记录隔离基线结果

运行：record_baseline_seed0。最优第 29 轮。

这是原模型在新分组协议下的基线，不是新结构带来的提升。B 只有一个来源记录，验证和测试均无 B 支持，不能报告 B 独立泛化能力。

| 集合 | 准确率 | 有支持六类 macro-F1 | 固定七类 macro-F1 |
|---|---:|---:|---:|
| 验证 | 79.67% | 0.3256 | 0.2791 |
| 测试 | 61.06% | 0.2704 | 0.2318 |

## 测试集分类别结果

| 类别 | 样本 | 精确率 | 召回率 | F1 |
|---|---:|---:|---:|---:|
| A | 354 | 0.0050 | 0.0198 | 0.0080 |
| B | 0 | 无法估计 | 无法估计 | 无法估计 |
| L | 136 | 0.0000 | 0.0000 | 0.0000 |
| N | 18672 | 0.9213 | 0.6547 | 0.7655 |
| R | 148 | 0.3026 | 0.1554 | 0.2054 |
| V | 2422 | 0.2709 | 0.3324 | 0.2985 |
| \| | 1736 | 0.2261 | 0.7310 | 0.3454 |

## 验证集房早诊断

| 分层 | A 窗口 | 检出 | 召回率 |
|---|---:|---:|---:|
| all_A | 325 | 18 | 5.54% |
| single_A | 258 | 5 | 1.94% |
| multiple_A | 67 | 13 | 19.40% |
| edge_0 | 236 | 9 | 3.81% |
| edge_1 | 89 | 9 | 10.11% |

验证集正常窗口 19112 个，其中 329 个误报为 A。
A 来自 13 个记录组。按记录组重采样的召回率 95% 描述区间：[0.0, 0.21428571428571427]。记录身份尚不能完全替代受试者身份。

单 A、多 A 的差异是相关性证据，仍需结合每条记录及波形检查，不能认定单一因果或性能上限。

原随机窗口测试集 95.19% 与此处的记录隔离结果不是同条件比较，差异还包含并列标签规则和缺失窗口筛查变化。

配置、数据校验、模型权重、逐窗口预测和训练历史均保存在本运行目录。测试集不用于选参数。

## 训练集拟合核对

同一最优模型的训练集准确率为 97.18%，七类 macro-F1 为 0.9120。训练代码与模型快照校验匹配。训练集拟合良好而独立记录表现明显下降，当前首要问题是跨记录泛化。

新验证集的原始 A 标注检出 18/115，S 映射来的 A 类检出 0/210。来源与标注子类型存在混杂，分层结果用于定位问题，不构成单一因果结论。
