rentommy/2026-fpga-dual-channel-ecg/hardware/acquisition/bom_20261026.xlsx

No. | Quantity | Comment | Designator | Footprint | Value | Manufacturer | LCSC Price
1 | 5 | 4.7nF | C1,C2,C3,C12,C13 | C0603 | 4.7nF | YAGEO(国巨) | 0.1737
2 | 11 | 10uF | C4,C6,C8,C26,C32,C33,C41,C42,C47,C50,C52 | C0603 | 10uF | Chinocera(华瓷) | 0.2447
3 | 4 | 100nF | C5,C7,C9,C27 | C0603 | 100nF | KEMET(基美) | 0.093
4 | 1 | 1uF | C10 | CASE-A_3216 | 1uF | 湘怡中元/湘江 | 0.8246
5 | 6 | 1uF | C11,C15,C16,C25,C40,C46 | C0603 | 1uF | SAMSUNG(三星) | 0.1445
6 | 1 | 1.5nF | C14 | C0603 | 1.5nF | YAGEO(国巨) | 0.1064
7 | 2 | 20pF | C17,C18 | C0603 | 20pF | SAMSUNG(三星) | 0.0547
8 | 2 | 10pF | C19,C20 | C0603 | 10pF | SAMSUNG(三星) | 0.0366
9 | 4 | 100nF | C21,C34,C36,C38 | C0603 | 100nF | FOJAN(富捷) | 0.0292
10 | 7 | 1uF | C22,C24,C29,C31,C35,C37,C39 | C0603 | 1uF | SAMSUNG(三星) | 0.0889
11 | 3 | 10nF | C23,C28,C30 | C0603 | 10nF | FH(风华) | 0.066
12 | 3 | 22uF | C44,C45,C51 | C0603 | 22uF | HRE(芯声) | 0.3379
13 | 1 | 47nF | C48 | C0603 | 47nF | FOJAN(富捷) | 0.0348
14 | 1 | 4.7uF | C49 | C0805 | 4.7uF | Chinocera(华瓷) | 0.2215
15 | 1 | LAIL-PHC2.54-2P-01-XH-L | CN1 | CONN-TH_2P-P2.50_HC-XH-2A-G |  | LAILAN(莱联) | 0.1329
16 | 3 | PJ-320A | CN2,CN3,CN4 | AUDIO-TH_XKB_PJ-320A |  | XKB Connection(中国星坤) | 0.8833
17 | 1 | HX-XH2.54-2PZZ | CN7 | CONN-TH_2P-P2.50_HX-2.54MM-2P-ZZ-MS |  | hanxia(韩下) | 0.0451
18 | 1 | PZ254V-11-02P | H1 | HDR-TH_2P-P2.54-V-M |  | XFCN(兴飞) | 0.114
19 | 2 | ZX-PZ2.54-1-16PZZ | H2,H3 | HDR-TH_16P-P2.54-V-M-2 |  | Megastar(兆星) | 0.4962
20 | 2 | HX PZ2.54-2x3P ZZ | H4,H6 | HDR-TH_6P-P2.54-V-M-R2-C3-S2.54-2 |  | hanxia(韩下) | 0.2842
21 | 1 | PZ254V-12-18P | H5 | HDR-TH_18P-P2.54-V-M-R2-C9-S2.54 |  | XFCN(兴飞) | 0.7071
22 | 1 | HX PZ2.54-1x4P ZZ | H7 | HDR-TH_4P-P2.54-V-M |  | hanxia(韩下) | 0.2003
23 | 1 | BLM21PG221SN1D | L1 | L0805 |  | muRata(村田) | 0.211
24 | 1 | 1uH | L2 | IND-SMD_L2.0-W1.2_PCT201210 | 1uH | JIERR(捷而瑞) | 0.5481
25 | 1 | 2.2uH | L3 | L1008 | 2.2uH | JIERR(捷而瑞) | 0.2421
26 | 4 | NCD0603R1 | LED1,LED2,LED3,LED4 | LED_0603 |  | 国星光电 | 0.0648
27 | 2 | NCD0603R1 | LED5,LED6 | LED0603-RD_RED |  | 国星光电 | 0.0648
28 | 6 | 51kΩ | R1,R2,R3,R4,R5,R6 | R0603 | 51kΩ | FOJAN(富捷) | 0.0112
29 | 9 | 100kΩ | R7,R8,R9,R11,R12,R13,R14,R15,R16 | R0603 | 100kΩ | FOJAN(富捷) | 0.0123
30 | 1 | 1MΩ | R10 | R0603 | 1MΩ | FOJAN(富捷) | 0.0116
31 | 8 | 10kΩ | R17,R18,R32,R33,R34,R35,R36,R37 | R0603 | 10kΩ | FOJAN(富捷) | 0.0103
32 | 4 | 10kΩ | R19,R20,R21,R25 | R0603 | 10kΩ | UNI-ROYAL(厚声) | 0.0131
33 | 1 | 10Ω | R22 | R0603 | 10Ω | FOJAN(富捷) | 0.0113
34 | 3 | 2kΩ | R23,R24,R38 | R0603 | 2kΩ | UNI-ROYAL(厚声) | 0.0145
35 | 4 | 5.1kΩ | R26,R27,R30,R31 | R0603 | 5.1kΩ | UNI-ROYAL(厚声) | 0.0091
36 | 2 | 1kΩ | R28,R29 | R0603 | 1kΩ | UNI-ROYAL(厚声) | 0.0101
37 | 1 | 383Ω | R39 | R0603 | 383Ω | FOJAN(富捷) | 0.0121
38 | 1 | 103AT-2 | R41 | TH-2_103AT-2 |  | semitec(石冢)
39 | 1 | 30.1kΩ | R42 | R0603 | 30.1kΩ | YAGEO(国巨) | 0.0205
40 | 1 | 5.23kΩ | R43 | R0603 | 5.23kΩ | UNI-ROYAL(厚声) | 0.0122
41 | 1 | TS-1101-C-W | SW1 | SW-SMD_L6.0-W3.3-LS8.0_TS-1101-C-W |  | XKB Connection(中国星坤) | 0.2675
42 | 1 | ADS1292IPBS | U1 | TQFP-32_L5.0-W5.0-P0.50-LS7.0-BL |  | TI(德州仪器) | 39.55
43 | 1 | CH343P | U2 | TQFN-16_L3.0-W3.0-P0.50-BL-EP1.7 |  | WCH(南京沁恒) | 5.94
44 | 3 | TPS7A2033PDBVR | U3,U6,U7 | SOT-23-5_L2.9-W1.6-P0.95-LS2.8-BR |  | TI(德州仪器) | 1.2767
45 | 1 | STM32F103C8T6 | U5 | LQFP-48_L7.0-W7.0-P0.50-LS9.0-BL |  | ST(意法半导体) | 9.12
46 | 1 | ISO6521FDR | U8 | SOIC-8_L4.9-W3.9-P1.27-LS6.0-BL |  | TI(德州仪器) | 9.54
47 | 1 | TPS62163DSGR | U9 | WSON-8_L2.0-W2.0-P0.50-TL-EP |  | TI(德州仪器) | 11.81
48 | 1 | BQ25883RGER | U10 | VFQFPN-24_L4.0-W4.0-P0.50-BL-EP2.8 |  | TI(德州仪器) | 25.83
49 | 2 | LAIL-TYPE-C-16PIN-08-WT | USB1,USB2 | TYPE-C-SMD_LAIL-TYPE-C-16PIN-08-WT |  | LAILAN(莱联) | 0.5802
50 | 1 | 8MHz | X1 | CRYSTAL-SMD_4P-L3.2-W2.5-BL_SIT8008BI | 8MHz | YXC(扬兴晶振) | 1.0094
51 | 1 | 32.768kHz | X2 | OSC-SMD_L3.2-W1.5 | 32.768kHz | TKD(泰晶) | 1.0406
