rentommy/2026-fpga-dual-channel-ecg/report/history/ads1292_wiring_2026-10-23.md

# ADS1292 时钟核查与 PYNQ-Z2 接线

用户已确认：PWDN/RESET 是一个复用脚，数字接口3.3V；随后进一步澄清，隔离器主机侧尚未设计。以下数字隔离连接属于设计要求，不能视为现有硬件已经完成。新采集显示版本及连接器选择见 使用指南（原工作区引用：`../board/SCOPE_GUIDE.md`，未随此公共候选发布）。本分配接在隔离器的主机侧，采集板保持独立供电和原有时钟电路。

## 接线表

以 **Pmod A 的物理针号**为准，不能把 FPGA 球号当排针号；不要凭照片左右方向判断。Pmod A 与 Raspberry Pi 接口共用信号，不能同时接其他驱动这些引脚的外设。

| 采集接口信号（隔离器主机侧） | Pmod A 针号 | FPGA 球号 | PYNQ 方向 | 初始化状态 |
|---|---:|---|---|---|
| CS | 1 | Y18 | 输出 | 高，未选中 |
| DIN（主机 MOSI） | 2 | Y19 | 输出 | 低 |
| DOUT（主机 MISO） | 3 | Y16 | 输入 | 由 ADC/隔离器驱动 |
| SCLK | 4 | Y17 | 输出 | 低 |
| DRDY | 7 | U18 | 输入 | 下降沿表示新数据 |
| START | 8 | U19 | 输出 | 低，配置完后再启动 |
| PWDN/RESET | 9 | W18 | 输出 | 启动时序控制，正常运行高 |
| GND | 5 或 11 | — | — | 仅接隔离器主机侧地 |

10 脚预留。6、12 脚是 3.3 V 电源，**不接这七根信号，也不跨隔离屏障接采集侧电源或地**。替换 STM32 时必须断开同一 SPI 总线上的 STM32 输出，避免两个主机同时驱动。

DRDY、START、PWDN/RESET 也必须保持隔离，不能只隔离四根 SPI 线却将控制线跨屏障直连。五路主机输出和两路 ADC 输出需使用正确方向的隔离通道。这里不改变采集板的独立供电，也不绕过原有隔离。

针号来自 [TUL PYNQ-Z2 Reference Manual v1.1，Table 13](https://dpoauwgwqsy2x.cloudfront.net/Download/PYNQ_Z2_User_Manual_v1.1.pdf)，并与本项目厂商 `board/board_files/pynq-z2/A.0/part0_pins.xml` 核对。约束文件为 `board/ads1292_pmoda.xdc`，机器可读分配为 `board/ads1292_pinmap.json`。

## STM32 程序核查

> 新材料更新：本次新增采集板网表后，确认U1.14/CLKSEL直接接3.3VD，选择内部标称512kHz时钟。下文关于“未提供原理图，不能从程序断言”的段落保留为此前软件核查的边界；当前硬件连接以[网表检查报告](netlist_review_2026-10-23.md)为准。该报告同时发现新隔离板供电和跨板接地问题，尚不能直接上电验收。

`stm32文件/ECG/MDK-ARM/ECG.uvprojx` 引用 `Core/Src/main.c`；`main2.c` 是另一份源文件，不是该 Keil 工程选择的主程序。

- `Core/Inc/stm32f1xx_hal_conf.h` 中 HSE 为 8 MHz；`main.c` 使用 HSE ×9，AHB 和 APB2 不分频，得到 72 MHz，APB1 为 36 MHz。`.ioc` 的记录一致。
- SPI1 使用 APB2，128 分频，SCLK = 72 MHz / 128 = **562.5 kHz**；`.ioc` 也记为 562.5 KBits/s。
- CPOL=0、第二边沿采样（CPHA=1），即 **SPI Mode 1**，8 位、MSB 优先、软件 CS。
- `CONFIG1=0x02`：按正常 128 kHz 调制时钟配置为 **500 SPS**。
- `CONFIG2=0xA0`：内部基准启用、CLK_EN=0，不从 CLK 脚输出内部振荡时钟。
- `LOFF_STAT=0x00` 中 `CLK_DIV=0`，调制时钟分频为 fCLK/4，对应标称 fCLK=512 kHz；**它不负责选择内部/外部时钟**。源文件该处注释不准确，未擅自修改历史固件。
- **真正时钟源仍由硬件 CLKSEL 决定**：CLKSEL=1 用内部标称 512 kHz；CLKSEL=0 需要外部时钟。工程没有控制 CLKSEL 的代码，也没有提供原理图，因此不能从程序断言实际硬件接法。若沿用同一块以前能工作的采集板，先保留其既有 CLKSEL/CLK 接法，无须从这八根线额外生成 ADC 主时钟。读取 DRDY 周期可验证采样率，但不能唯一判定内部还是外部振荡源。

以上接口和时钟定义按 [TI ADS129x 数据手册 §8.3.7、§6.6、§8.6.1.9](https://www.ti.com/lit/ds/symlink/ads1292r.pdf) 核对。SCLK、ADC 主时钟和采样率是三个不同的量。

旧固件还设置 `CH1SET=0x81`（通道1掉电、输入短路），`CH2SET=0x00`（通道2正常、增益6），读取9字节帧中的第6～8字节作为 CH2 输出。现有程序是单通道有效采集；不能直接称为双导联同步输出。

## 后续 RTL 配置边界

PL 100 MHz 时钟下先用半周期89拍产生约 **561.798 kHz SCLK**，接近旧系统562.5 kHz，待隔离器传播延时确认后再优化。Mode 1，低电平空闲，上升沿推出下一位，下降沿采样 DOUT；CS 覆盖整条命令或完整9字节数据帧。DRDY 经两级同步再检测下降沿。

每帧24位状态字+两路24位数据，共72位；后续应保留两个通道并分别符号扩展到32位。配置命令需遵守解码等待、CS间隔、上电与复位时间，不能只照搬逐位波形。隔离器所有控制线方向、主机侧供电和传播延时仍需按实际器件核对。

**更新：新的 `board/scope/ecg_scope.bit/.hwh` 已生成，包含上述 Pmod A 引脚、SPI 主机、1024帧 FIFO、既有滤波器、HDMI 波形和按键切换。** 原 `board/overlay/` 仍是文件回放版。SPI／FIFO／AXI／按键与视频已通过 RTL 仿真；真实 ADC 通信尚未验收，因为隔离器主机侧仍未设计。新 XDC 使用 Vivado 支持的逐项属性约束；不要继续使用早期 ZIP 内旧约束。
