rentommy/2026-fpga-dual-channel-ecg/report/history/ads1292_board_test_2026-11-03.md

# ADS1292 Pmod A 实物通信与内部测试（2026-11-03）

用户确认已连接ADS1292，未连接人体电极。本次从合成演示切换至ADC内部测试，不采集人体输入。

## 实测结果

- 读取芯片ID：0x53。
- 11个寄存器回读校验通过：`02 A3 10 05 05 2C 00 00 02 07 0C`。两通道均选择内部测试源，增益6，内部2.42 V参考，标称500 SPS。
- 限时显示测试：总执行10.0018秒，包含复位、基准稳定等待等初始化；每通道接收4387点，坏帧0、溢出0、无异常。不能用4387除以总执行时间作为真实采样率。
- 另做独立6.000529秒原始采集：保存2996组双通道样本，硬件帧计数增量折算约499.4559帧/秒，坏帧0、溢出0。此为短时软件墙钟计时，非精密时钟测量。
- 丢弃原始记录前100点，CH1的10/90百分位分别−22238、19814码；CH2分别−22445、19607码；两通道平台差均42052码，按48.081 nV/code折算约2.02190 mV峰峰值。
- 两通道所检出的相邻上升沿间隔均为512个样本，重复4次。以标称500 SPS折算0.9765625 Hz；以短时实测帧率折算约0.9755 Hz。TI资料将该模式描述为约1 Hz方波，不将标称500 SPS推算的频率当作独立精密频率测量。
- TI CONFIG2说明内部幅值为±VREF/2400，2.42 V参考对应约2.0167 mV峰峰值，与本次2.0219 mV接近。参考：https://www.ti.com/lit/ds/symlink/ads1292.pdf 第53页。

## 存档和状态

板上目录：`/home/xilinx/jupyter_notebooks/ecg_scope_20261023/board/scope/`（按既有部署目录；本次未另用pwd核实绝对路径）。实际Notebook使用相对路径 `ecg_scope_20261023/board/scope/`。

- `adc_internal_test_20261103.json`：限时显示测试summary。
- `adc_internal_raw_20261103.npy`：6秒双通道真实原始样本。
- `adc_internal_raw_summary_20261103.json`：幅值、重复周期和帧率统计。
- `adc_internal_live_20261103.json`：持续显示程序停止后才写出的summary，当前不宣称已经生成。

当前已启动 `run_scope.py --source adc-test` 持续显示芯片内部信号。Notebook保存后保留。HDMI经过既有DIAG/FAST滤波，平台/边沿与原始方波有差异；幅值统计来自原始样本，不来自屏幕自动增益刻度。启动HPD仍为0，不能用它否认此前用户已确认的实际出图。

本次证明芯片寄存器访问与内部源经ADC、DRDY、SPI/FIFO读取路径工作。用户现场反馈“两个通道都能看到周期波形”，双通道HDMI画面已确认。两通道共享内部测试源，因此不能仅据此判定外部电极输入连接、通道间串扰、全部隔离设计或人体采集安全已经验收。

## 持续运行补充

用户要求继续测试后，中断先前的内部测试显示程序，正常退出summary记录：总执行1453.794758秒（约24.23分钟，包含初始化），每通道726037点，坏帧0、溢出0、error为null。这是硬件计数器覆盖范围内的持续运行结果，并非精密丢样或时钟认证。

## 输入短接和通道对应验证

分别将CH1SET/CH2SET设为01/01、05/01、01/05，每次停转换、SDATAC、写寄存器并回读确认、清FIFO、START/RDATAC后采4秒，丢弃前250点，使用剩余约1746点的未软件滤波数据统计。增益6、500 SPS，输入电压标定48.081 nV/code。

| 测试 | 样本数 | CH1交流RMS / µV | CH2交流RMS / µV | 备注 |
|---|---:|---:|---:|---|
| 双通道内部短接 | 1996 | 0.9294 | 0.8773 | 全段峰峰值分别5.577/6.299 µV |
| CH1方波、CH2短接 | 1997 | 1000.7343 | 0.9263 | CH1平台差约2.0221 mV |
| CH1短接、CH2方波 | 1996 | 0.9549 | 1000.6519 | CH2平台差约2.0217 mV |

三项坏帧和溢出均为0。激励方波随配置正确出现在对应数据列，短接通道未出现同幅方波，验证了通道编号/读取顺序及粗略独立性。短接测试的数值包含芯片数字滤波后的有效带宽，RMS已扣除均值，没有额外软件带通；采样窗口短，不将其当作所有工况下的噪声保证或精密串扰(dB)测量。内部短接未覆盖电极、外部输入保护和导联线的噪声。

板上保存三份NPY：`both_short_20261103.npy`、`ch1_test_ch2_short_20261103.npy`、`ch1_short_ch2_test_20261103.npy`，汇总为 `channel_and_short_test_20261103.json`，均在既有scope目录。测试完成后恢复双通道内部方波实时HDMI，继续保持未接电极状态。
