rentommy/2026-fpga-dual-channel-ecg/report/history/electrode_test_2026-11-04.md

# 电极输入测试记录

测试使用中文双缓冲固件（ABI 0x45434732），PYNQ Jupyter 中的 `ecg_scope_chinese_20261103/board/run_scope.py`，外部输入 `--source adc`，目标波形更新率30次/秒。用户已确认采集侧电池供电、无充电/USB/调试器连接，隔离板已连接，两侧GND无直连。该确认不等同于整机人体连接安全认证。

## 首次采集

ADS1292 ID 0x53，配置读回 `02 A0 10 00 00 2C 00 00 02 07 0C`，两个通道均为外部差分输入，内部测试源关闭。

25.0023秒，共11889样本/通道，滤波预热丢弃543点；无溢出、无坏帧、无运行异常，实际更新29.9857次/秒。质量统计另舍弃原始数据前1000点。

| 指标 | CH1 | CH2 |
|---|---:|---:|
| 原始交流RMS | 0.497 µV | 1.253 mV |
| 原始P1～P99跨度 | 2.308 µV | 3.774 mV |
| 中位直流偏置 | −0.06659 mV | 34.4721 mV |
| 接近ADC满量程样本占比 | 0 | 0 |
| 49～51 Hz能量占0.5～150 Hz比例 | 3.35% | 97.47% |

末4秒实际HLS滤波波形已在Notebook绘图查看：CH1接近底噪；CH2以干扰为主，未见清晰可辨认的心跳。不能将CH2的大幅信号视为成功的人体心电。

用户确认电极插头接在CN4。当前本地网表CN4经R2/R1连接IN1P/IN1N，CN4.4经R7连接RLDOUT；CN2对应CH2。网表和实际已焊接板的一致性、导联线触点及插座接触情况仍待核实。

原始数据、最后4秒滤波数据、统计和图保存在板端 `ecg_scope_chinese_20261103/board/scope/` 中的 `electrode_raw_20261103.npy`、`electrode_filtered_last4s_20261103.npy`、`electrode_quality_20261103.json`、`electrode_filtered_last4s_20261103.png`。日期后缀沿用首次启动命名；报告日期按客户端日期记录。

## 调整后复测

用户表示刚才有两个电极贴反，已调整位置。25秒复测11889样本/通道，无溢出、坏帧，更新29.9873次/秒。CH1原始交流RMS 2.9577 mV，P1～P99跨度8.9549 mV，工频占比97.733%；CH2交流RMS 3.2289 mV，工频占比99.486%。两路均未削顶，但仍主要为工频干扰，不能认定采集到清晰心电。

该次板端独立目录为 `electrode_repositioned_20250504_012823`，其中日期来自板卡错误的系统时间，不代表实际测试日期；测试日期按客户端2026-11-04记录。未覆盖首次原始数据。

## RLD反馈源核对

核对TI ADS129x数据手册RLD_SENS（06h）：bit5启用RLD，bit3/2选择CH2负/正输入，bit1/0选择CH1负/正输入。原版0x2C使用CH2，而用户确认CN4连接CH1。因此另建 `board/run_scope_cn4_rld1_20261104.py`，仅在外部输入模式将RLD_SENS改为0x23（启用RLD并选择CH1双输入），内部测试模式仍为0x2C；保留原版及中文发布包。参考：https://www.ti.com/lit/ds/symlink/ads1292r.pdf 。该改动为当前CN4单通道接线的专用测试配置，不代表通用双通道接线配置。

独立25秒对比测试完成，寄存器读回确认RLD_SENS=0x23，11889样本/通道，无溢出、坏帧、削顶或运行异常；实际更新29.9864次/秒。CH1原始交流RMS 0.6069 mV，P1～P99跨度2.4785 mV，工频占比降至0.7527%。CH2工频占比仍为97.772%，本次仅CN4/CH1连接电极，不能把CH2作为有效心电通道。

实际HLS输出最后4秒图已查看：CH1保真和快速路径均出现清楚、重复的QRS样尖峰，峰值约1 mV。该观察是工程采集验证，不作临床心律判定。虽然前后测试也可能包含接触/环境变化，RLD反馈源与已连接通道不匹配是已确认的配置问题；改正后本次实测干扰显著下降。

板端数据在 `ecg_scope_chinese_20261103/board/scope/electrode_cn4_rld1_20261104/`，包括 `raw.npy`、`filtered_last4s.npy`、`filtered_last4s.png`、`quality.json` 和 `run_summary.json`。

已使用专用脚本恢复外部电极输入持续显示，目标30次/秒，默认通道1；用户现场确认“已经清楚，持续滚动正常”。启动命令：

```python
%run ecg_scope_chinese_20261103/board/run_scope_cn4_rld1_20261104.py --source adc --display-fps 30 --summary ecg_scope_chinese_20261103/board/scope/electrode_cn4_rld1_20261104/live_summary.json
```

保留中文固件和原始发布包不变，本次无需重新生成比特流。若改接CN2/CH2或改成其他电极拓扑，应重新选择RLD反馈输入，不应直接照用该CN4专用脚本。
