rentommy/2026-fpga-dual-channel-ecg/report/history/hdmi_test_2026-11-03.md

# HDMI 实物输出测试（2026-11-03）

## 已确认

后续连接链路澄清：用户说明使用了采集卡，因此下文早先所称“显示器/现场画面”实际包括采集卡预览环节。可以确认HDMI能被采集卡接收并显示波形，但没有HDMI直连显示器的对照证据，不能将两者等同。

- 访问用户提供的PYNQ-Z2 Jupyter地址 `http://192.168.2.99:9090`，打开现有 `ECG_Scope_Start_20261023.ipynb`。
- 在新的单元格启动 `%run ecg_scope_20261023/board/run_scope.py --source demo --summary ecg_scope_20261023/board/scope/hdmi_live_demo_summary.json`。程序重新加载scope比特流，持续运行演示波形，未进入ADC初始化模式。
- 浏览器输出 `SOURCE demo HDMI_HPD 0 BUTTONS: BTN0 CH1 / BTN1 CH2 / BTN2 PATH / BTN3 HOLD`，随后Notebook保持运行，未见异常输出。
- 用户现场明确反馈：**“已接 OUT，显示心电演示画面”**。因此HDMI OUT至该显示器的实际出图已得到用户确认，不再仅依赖仿真或HPD。
- 设计输出模式640×480、约60 Hz。该模式来自构建配置，未读取显示器菜单测量实际接收参数。

## 边界

启动时HPD读数为0，但用户随后确认实际显示。不能据此单一启动读数断言无图，也不能声称已确认HPD信号始终正确；未持续采集HPD状态。

演示为合成数据，不是人体ADC数据；不据此判定ADS1292/Pmod A实物通信通过。历史board_acceptance.json保留为原测试快照，不将历史记录改写为本次测量。

BTN0/1通道选择、BTN2通路、BTN3冻结/恢复：用户在现场依次测试后明确反馈“四项都正常”，全部通过人工观察验证。该结论来自用户反馈，未另行抓取按钮电平或寄存器变化。

演示保持运行，Notebook已保存。Jupyter工具栏的中断按钮可停止，脚本正常捕获中断后冻结最后画面、保存本次summary。无需运行真实ADC采集来验证HDMI。

## 连续波形绘图修复

用户照片显示QRS陡峭边沿存在分离线段，界面处于HOLD。检查发现原绘图将2000点分入640列，每列仅绘本列最小/最大值；跨列的相邻采样点未连接，导致陡峭变化处空隙。

本地 `board/run_scope.py` 已修改：先求每列极值，再纳入上一列末点，保留极值并使相邻列连接。已用四个bank、639个交替陡变边界验证连续覆盖，同时验证HOLD仍禁止缓存更新。此次不修改ADC数据、滤波器、RTL或比特流。

板上通过Notebook备份原脚本为 `run_scope.before_continuity_20261103.py`，应用同样替换，输出 `CONNECTED_WAVEFORM_PATCH_APPLIED`。旧演示正常中断，summary无错误；随后启动新版演示，输出SOURCE demo，恢复默认CH1/DIAG/LIVE。Notebook已保存。用户现场确认：“已经连起来，并持续滚动”，本次连续绘图及实时滚动修复通过人工显示验证。

注意：本地和板上的20261023历史ZIP未改写；重新解压该ZIP会恢复旧脚本，需再次应用绘图修复。
