rentommy/2026-fpga-dual-channel-ecg/report/evidence/per_beat_fpga_results.csv

index | label | reference_label | confidence | max_logit_error | wall_seconds | fpga_conv_seconds | fpga_conv_calls | recording | anchor_nominal_s
0 | N | N | 0.9973081350326538 | 9.5367431640625e-07 | 0.1546234209999966 | 0.07380923000016537 | 12 | electrode_cn2_20261104 | 3.1796875
1 | N | N | 0.9981036186218262 | 1.9073486328125e-06 | 0.14282212299997354 | 0.07409968600018146 | 12 | electrode_cn2_20261104 | 4.17578125
2 | N | N | 0.9968048334121704 | 1.6689300537109375e-06 | 0.1395738710000387 | 0.07394044600005145 | 12 | electrode_cn2_20261104 | 5.13671875
3 | N | N | 0.9972042441368103 | 9.5367431640625e-07 | 0.14401111399990896 | 0.07454629500000465 | 12 | electrode_cn2_20261104 | 6.0859375
4 | N | N | 0.9983150959014893 | 1.9073486328125e-06 | 0.14352002999999058 | 0.07442920099992989 | 12 | electrode_cn2_20261104 | 7.06640625
5 | N | N | 0.9961475133895874 | 1.9073486328125e-06 | 0.14361949499993898 | 0.07427446199994847 | 12 | electrode_cn2_20261104 | 8.03125
6 | N | N | 0.9949899315834045 | 1.9073486328125e-06 | 0.14277180200008388 | 0.07430792700017719 | 12 | electrode_cn2_20261104 | 8.9375
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
