rentommy/2026-fpga-dual-channel-ecg/report/evidence/clean_bd_validation.txt

INFO: [Common 17-3922] A valid Vivado Design Suite BASIC license has been detected. Your current license is active and will expire on 30-sep-2027.
#-----------------------------------------------------------
# Vivado v2026.1 (64-bit)
# SW Build 6511674 on Tue Jun 16 11:02:23 MDT 2026
# IP Build 6504888 on Tue Jun 09 09:05:25 MDT 2026
# SharedData Build 6501428 on Mon Jun 08 17:34:18 MDT 2026
# Start of session at: Wed Nov  4 16:03:36 2026
# Process ID         : 79676
# Current directory  : D:/ecg_fpga/build/submission_cleancheck_v2
# Command line       : vivado.exe -mode batch -source board/build_system.tcl -log cleancheck.log -journal cleancheck.jou -tclargs --validate-only
# Log file           : D:/ecg_fpga/build/submission_cleancheck_v2/cleancheck.log
# Journal file       : D:/ecg_fpga/build/submission_cleancheck_v2\cleancheck.jou
# Running On         : LAPTOP-V960FPLV
# Platform           : Windows 11
# Operating System   : 26200
# Processor Detail   : AMD Ryzen 9 8945HX with Radeon Graphics        
# CPU Frequency      : 2495 MHz
# CPU Physical cores : 16
# CPU Logical cores  : 32
# Host memory        : 33605 MB
# Swap memory        : 25769 MB
# Total Virtual      : 59375 MB
# Available Virtual  : 12127 MB
#-----------------------------------------------------------
source board/build_system.tcl
# set root [file normalize [file join [file dirname [info script]] ..]]
# source [file join $root board create_scope.tcl]
## set ecg_root [file normalize [file join [file dirname [info script]] ..]]
## set_param board.repoPaths [list [file join $ecg_root board board_files]]
## set ecg_project_dir [file join $ecg_root build vivado ecg_scope]
## if {[file exists [file join $ecg_project_dir ecg_overlay.xpr]]} {
##  open_project [file join $ecg_project_dir ecg_overlay.xpr]
##  open_bd_design [get_files */ecg_system.bd]
##  if {[llength [get_bd_cells -quiet ecg_io]]} {error "Scope design already exists; open/rebuild that project instead."}
## } else {source [file join $ecg_root board create_overlay.tcl]}
### set ecg_root [file normalize [file join [file dirname [info script]] ..]]
### if {![info exists ecg_project_dir]} {
###     set ecg_project_dir [file join $ecg_root build vivado ecg_overlay]
### }
### set ecg_ip_dir [file join $ecg_root hls_ecg2 hls impl ip]
### if {[file exists [file join $ecg_project_dir ecg_overlay.xpr]]} {
###     error "Project already exists: $ecg_project_dir. Open it instead of overwriting it."
### }
### if {![file exists [file join $ecg_ip_dir component.xml]]} {
###     error "Export the HLS IP first: $ecg_ip_dir/component.xml is missing."
### }
### set_param board.repoPaths [list [file join $ecg_root board board_files]]
### set ecg_board_part [get_board_parts -quiet tul.com.tw:pynq-z2:part0:1.0]
### if {[llength $ecg_board_part] != 1} { error "PYNQ-Z2 vendor board files were not discovered." }
### create_project ecg_overlay $ecg_project_dir -part xc7z020clg400-1
create_project: Time (s): cpu = 00:00:00 ; elapsed = 00:00:11 . Memory (MB): peak = 588.141 ; gain = 25.887
### set_property board_part $ecg_board_part [current_project]
### set_property target_language Verilog [current_project]
### set_property ip_repo_paths [list $ecg_ip_dir] [current_project]
### update_ip_catalog
INFO: [IP_Flow 19-234] Refreshing IP repositories
INFO: [IP_Flow 19-1700] Loaded user IP repository 'd:/ecg_fpga/build/submission_cleancheck_v2/hls_ecg2/hls/impl/ip'.
INFO: [IP_Flow 19-2313] Loaded Vivado IP repository 'D:/AMDDesignTools/2026.1/Vivado/data/ip'.
### create_bd_design ecg_system
Wrote  : <D:\ecg_fpga\build\submission_cleancheck_v2\build\vivado\ecg_scope\ecg_overlay.srcs\sources_1\bd\ecg_system\ecg_system.bd> 
### set ecg_ps [create_bd_cell -type ip -vlnv xilinx.com:ip:processing_system7:5.5 ps7]
### apply_bd_automation -rule xilinx.com:bd_rule:processing_system7 \
###     -config {make_external "FIXED_IO, DDR" apply_board_preset "1" Master "Disable" Slave "Disable"} $ecg_ps
### set_property -dict [list CONFIG.PCW_USE_M_AXI_GP0 {1} \
###     CONFIG.PCW_USE_S_AXI_HP0 {1} CONFIG.PCW_USE_S_AXI_HP1 {1} \
###     CONFIG.PCW_FPGA0_PERIPHERAL_FREQMHZ {100}] $ecg_ps
CRITICAL WARNING: [PSU-1]  Parameter : PCW_UIPARAM_DDR_DQS_TO_CLK_DELAY_0 has negative value -0.051 . PS DDR interfaces might fail when entering negative DQS skew values. 
CRITICAL WARNING: [PSU-2]  Parameter : PCW_UIPARAM_DDR_DQS_TO_CLK_DELAY_1 has negative value -0.006 . PS DDR interfaces might fail when entering negative DQS skew values. 
CRITICAL WARNING: [PSU-3]  Parameter : PCW_UIPARAM_DDR_DQS_TO_CLK_DELAY_2 has negative value -0.009 . PS DDR interfaces might fail when entering negative DQS skew values. 
CRITICAL WARNING: [PSU-4]  Parameter : PCW_UIPARAM_DDR_DQS_TO_CLK_DELAY_3 has negative value -0.033 . PS DDR interfaces might fail when entering negative DQS skew values. 
### set ecg_filter [create_bd_cell -type ip -vlnv nuaa:ecg:ecg_filter_top:1.0 ecg_filter_0]
### foreach ecg_name {ctrl_connect read_connect write_connect} {
###     set ecg_sc [create_bd_cell -type ip -vlnv xilinx.com:ip:smartconnect:1.0 $ecg_name]
###     set_property -dict [list CONFIG.NUM_SI {1} CONFIG.NUM_MI {1}] $ecg_sc
### }
### create_bd_cell -type ip -vlnv xilinx.com:ip:proc_sys_reset:5.0 reset_100m
INFO: [Ipptcl 7-1463] No Compatible Board Interface found. Board Tab not created in customize GUI
### set_property CONFIG.C_AUX_RESET_HIGH {1} [get_bd_cells reset_100m]
### create_bd_cell -type ip -vlnv xilinx.com:ip:xlconstant:1.1 const_one
INFO: [BD 5-1043] It is recommended to use inline hdl version xilinx.com:inline_hdl:ilconstant:1.0 for the IP type xilinx.com:ip:xlconstant:1.1 for improved performance and reduced disk space. IPs with VLNV xilinx.com:ip:xlconstant:1.1 will not be supported from release 2025.2. More information on inline hdl IP is available in UG994 
### set_property CONFIG.CONST_VAL {1} [get_bd_cells const_one]
### create_bd_cell -type ip -vlnv xilinx.com:ip:xlconstant:1.1 const_zero
INFO: [BD 5-1043] It is recommended to use inline hdl version xilinx.com:inline_hdl:ilconstant:1.0 for the IP type xilinx.com:ip:xlconstant:1.1 for improved performance and reduced disk space. IPs with VLNV xilinx.com:ip:xlconstant:1.1 will not be supported from release 2025.2. More information on inline hdl IP is available in UG994 
### set_property CONFIG.CONST_VAL {0} [get_bd_cells const_zero]
### connect_bd_intf_net [get_bd_intf_pins ps7/M_AXI_GP0] [get_bd_intf_pins ctrl_connect/S00_AXI]
### connect_bd_intf_net [get_bd_intf_pins ctrl_connect/M00_AXI] [get_bd_intf_pins ecg_filter_0/s_axi_ctrl]
### connect_bd_intf_net [get_bd_intf_pins ecg_filter_0/m_axi_gmem0] [get_bd_intf_pins read_connect/S00_AXI]
### connect_bd_intf_net [get_bd_intf_pins read_connect/M00_AXI] [get_bd_intf_pins ps7/S_AXI_HP0]
### connect_bd_intf_net [get_bd_intf_pins ecg_filter_0/m_axi_gmem1] [get_bd_intf_pins write_connect/S00_AXI]
### connect_bd_intf_net [get_bd_intf_pins write_connect/M00_AXI] [get_bd_intf_pins ps7/S_AXI_HP1]
### connect_bd_net [get_bd_pins ps7/FCLK_CLK0] \
###     [get_bd_pins ps7/M_AXI_GP0_ACLK] [get_bd_pins ps7/S_AXI_HP0_ACLK] \
###     [get_bd_pins ps7/S_AXI_HP1_ACLK] [get_bd_pins ecg_filter_0/ap_clk] \
###     [get_bd_pins ctrl_connect/aclk] [get_bd_pins read_connect/aclk] \
###     [get_bd_pins write_connect/aclk] [get_bd_pins reset_100m/slowest_sync_clk]
### connect_bd_net [get_bd_pins ps7/FCLK_RESET0_N] [get_bd_pins reset_100m/ext_reset_in]
### connect_bd_net [get_bd_pins const_one/dout] [get_bd_pins reset_100m/dcm_locked]
### connect_bd_net [get_bd_pins const_zero/dout] [get_bd_pins reset_100m/aux_reset_in] [get_bd_pins reset_100m/mb_debug_sys_rst]
### connect_bd_net [get_bd_pins reset_100m/peripheral_aresetn] \
###     [get_bd_pins ecg_filter_0/ap_rst_n] [get_bd_pins ctrl_connect/aresetn] \
###     [get_bd_pins read_connect/aresetn] [get_bd_pins write_connect/aresetn]
### assign_bd_address
INFO: [BD 41-3093] Triggering Legacy Auto Assign Algorithm
Slave segment '/ps7/S_AXI_HP0/HP0_DDR_LOWOCM' is being assigned into address space '/ecg_filter_0/Data_m_axi_gmem0' at <0x0000_0000 [ 512M ]>.
Slave segment '/ps7/S_AXI_HP1/HP1_DDR_LOWOCM' is being assigned into address space '/ecg_filter_0/Data_m_axi_gmem1' at <0x0000_0000 [ 512M ]>.
Slave segment '/ecg_filter_0/s_axi_ctrl/Reg' is being assigned into address space '/ps7/Data' at <0x4000_0000 [ 64K ]>.
### set ecg_ctrl_segments [get_bd_addr_segs -of_objects [get_bd_addr_spaces ps7/Data] -filter {NAME =~ *ecg_filter_0*}]
### if {[llength $ecg_ctrl_segments] != 1} { error "Could not uniquely identify the filter control address segment." }
### set_property offset 0x40000000 $ecg_ctrl_segments
### set_property range 64K $ecg_ctrl_segments
### validate_bd_design
WARNING: [BD 41-3281] Instance '/ps7' is connected on both sides by SmartConnects and cannot automatically configure itself to match the endpoints. Please manually configure its AXI interfaces as required for the design.
WARNING: [BD 41-3281] Instance '/ecg_filter_0' is connected on both sides by SmartConnects and cannot automatically configure itself to match the endpoints. Please manually configure its AXI interfaces as required for the design.
WARNING: [BD 41-702] Propagation TCL tries to overwrite USER strength parameter PCW_M_AXI_GP0_FREQMHZ(10) on '/ps7' with propagated value(100). Command ignored
CRITICAL WARNING: [PSU-1]  Parameter : PCW_UIPARAM_DDR_DQS_TO_CLK_DELAY_0 has negative value -0.051 . PS DDR interfaces might fail when entering negative DQS skew values. 
CRITICAL WARNING: [PSU-2]  Parameter : PCW_UIPARAM_DDR_DQS_TO_CLK_DELAY_1 has negative value -0.006 . PS DDR interfaces might fail when entering negative DQS skew values. 
CRITICAL WARNING: [PSU-3]  Parameter : PCW_UIPARAM_DDR_DQS_TO_CLK_DELAY_2 has negative value -0.009 . PS DDR interfaces might fail when entering negative DQS skew values. 
CRITICAL WARNING: [PSU-4]  Parameter : PCW_UIPARAM_DDR_DQS_TO_CLK_DELAY_3 has negative value -0.033 . PS DDR interfaces might fail when entering negative DQS skew values. 
INFO: [BD 5-943] Reserving offset range <0x4000_0000 [ 64K ]> from slave interface '/ctrl_connect/S00_AXI' to master interface '/ctrl_connect/M00_AXI'. This will be used by smartconnect on path for routing.
INFO: [xilinx.com:ip:smartconnect:1.0-1] ecg_system_ctrl_connect_0: SmartConnect ecg_system_ctrl_connect_0 is in Ultralite mode.
INFO: [BD 5-943] Reserving offset range <0x0000_0000 [ 512M ]> from slave interface '/read_connect/S00_AXI' to master interface '/read_connect/M00_AXI'. This will be used by smartconnect on path for routing.
INFO: [xilinx.com:ip:smartconnect:1.0-1] ecg_system_read_connect_0: SmartConnect ecg_system_read_connect_0 is in High-performance Mode.
INFO: [Ipptcl 7-1463] No Compatible Board Interface found. Board Tab not created in customize GUI
INFO: [BD 5-943] Reserving offset range <0x0000_0000 [ 512M ]> from slave interface '/write_connect/S00_AXI' to master interface '/write_connect/M00_AXI'. This will be used by smartconnect on path for routing.
INFO: [xilinx.com:ip:smartconnect:1.0-1] ecg_system_write_connect_0: SmartConnect ecg_system_write_connect_0 is in High-performance Mode.
validate_bd_design: Time (s): cpu = 00:00:04 ; elapsed = 00:00:06 . Memory (MB): peak = 791.195 ; gain = 94.383
### if {[get_property CONFIG.C_AUX_RESET_HIGH [get_bd_cells reset_100m]] != 1} {
###     error "aux_reset_in is tied low and must be active-high; otherwise AXI remains in reset."
### }
### if {[get_property CONFIG.C_EXT_RESET_HIGH [get_bd_cells reset_100m]] != 0} {
###     error "FCLK_RESET0_N requires an active-low external reset input."
### }
### save_bd_design
Wrote  : <D:\ecg_fpga\build\submission_cleancheck_v2\build\vivado\ecg_scope\ecg_overlay.srcs\sources_1\bd\ecg_system\ecg_system.bd> 
### set ecg_bd_file [get_files */ecg_system.bd]
### generate_target all $ecg_bd_file
INFO: [BD 41-1662] The design 'ecg_system.bd' is already validated. Therefore parameter propagation will not be re-run.
WARNING: [BD 41-2384] Width mismatch when connecting pin: '/read_connect/S00_AXI_arlock'(1) to pin: '/ecg_filter_0/m_axi_gmem0_ARLOCK'(2) - Only lower order bits will be connected.
WARNING: [BD 41-2384] Width mismatch when connecting pin: '/write_connect/S00_AXI_awlock'(1) to pin: '/ecg_filter_0/m_axi_gmem1_AWLOCK'(2) - Only lower order bits will be connected.
Verilog Output written to : D:/ecg_fpga/build/submission_cleancheck_v2/build/vivado/ecg_scope/ecg_overlay.gen/sources_1/bd/ecg_system/synth/ecg_system.v
WARNING: [BD 41-2384] Width mismatch when connecting pin: '/read_connect/S00_AXI_arlock'(1) to pin: '/ecg_filter_0/m_axi_gmem0_ARLOCK'(2) - Only lower order bits will be connected.
WARNING: [BD 41-2384] Width mismatch when connecting pin: '/write_connect/S00_AXI_awlock'(1) to pin: '/ecg_filter_0/m_axi_gmem1_AWLOCK'(2) - Only lower order bits will be connected.
Verilog Output written to : D:/ecg_fpga/build/submission_cleancheck_v2/build/vivado/ecg_scope/ecg_overlay.gen/sources_1/bd/ecg_system/sim/ecg_system.v
Verilog Output written to : D:/ecg_fpga/build/submission_cleancheck_v2/build/vivado/ecg_scope/ecg_overlay.gen/sources_1/bd/ecg_system/hdl/ecg_system_wrapper.v
INFO: [IP_Flow 19-5611] Unable to find an associated reset port for the interface 'M_AXI_GP0'. A default connection has been created.
INFO: [IP_Flow 19-5611] Unable to find an associated reset port for the interface 'S_AXI_HP0'. A default connection has been created.
INFO: [IP_Flow 19-5611] Unable to find an associated reset port for the interface 'S_AXI_HP1'. A default connection has been created.
INFO: [BD 41-1029] Generation completed for the IP Integrator block ps7 .
INFO: [BD 41-1029] Generation completed for the IP Integrator block ecg_filter_0 .
Exporting to file d:/ecg_fpga/build/submission_cleancheck_v2/build/vivado/ecg_scope/ecg_overlay.gen/sources_1/bd/ecg_system/ip/ecg_system_ctrl_connect_0/bd_0/hw_handoff/ecg_system_ctrl_connect_0.hwh
Generated Hardware Definition File d:/ecg_fpga/build/submission_cleancheck_v2/build/vivado/ecg_scope/ecg_overlay.gen/sources_1/bd/ecg_system/ip/ecg_system_ctrl_connect_0/bd_0/synth/ecg_system_ctrl_connect_0.hwdef
INFO: [BD 41-1029] Generation completed for the IP Integrator block ctrl_connect .
Exporting to file d:/ecg_fpga/build/submission_cleancheck_v2/build/vivado/ecg_scope/ecg_overlay.gen/sources_1/bd/ecg_system/ip/ecg_system_read_connect_0/bd_0/hw_handoff/ecg_system_read_connect_0.hwh
Generated Hardware Definition File d:/ecg_fpga/build/submission_cleancheck_v2/build/vivado/ecg_scope/ecg_overlay.gen/sources_1/bd/ecg_system/ip/ecg_system_read_connect_0/bd_0/synth/ecg_system_read_connect_0.hwdef
INFO: [BD 41-1029] Generation completed for the IP Integrator block read_connect .
Exporting to file d:/ecg_fpga/build/submission_cleancheck_v2/build/vivado/ecg_scope/ecg_overlay.gen/sources_1/bd/ecg_system/ip/ecg_system_write_connect_0/bd_0/hw_handoff/ecg_system_write_connect_0.hwh
Generated Hardware Definition File d:/ecg_fpga/build/submission_cleancheck_v2/build/vivado/ecg_scope/ecg_overlay.gen/sources_1/bd/ecg_system/ip/ecg_system_write_connect_0/bd_0/synth/ecg_system_write_connect_0.hwdef
INFO: [BD 41-1029] Generation completed for the IP Integrator block write_connect .
INFO: [BD 41-1029] Generation completed for the IP Integrator block reset_100m .
INFO: [BD 41-1029] Generation completed for the IP Integrator block const_one .
INFO: [BD 41-1029] Generation completed for the IP Integrator block const_zero .
Exporting to file D:/ecg_fpga/build/submission_cleancheck_v2/build/vivado/ecg_scope/ecg_overlay.gen/sources_1/bd/ecg_system/hw_handoff/ecg_system.hwh
Generated Hardware Definition File D:/ecg_fpga/build/submission_cleancheck_v2/build/vivado/ecg_scope/ecg_overlay.gen/sources_1/bd/ecg_system/synth/ecg_system.hwdef
INFO: [BD 41-3262] Generated VHDL Instantiation Template file d:/ecg_fpga/build/submission_cleancheck_v2/build/vivado/ecg_scope/ecg_overlay.gen/sources_1/bd/ecg_system/ecg_system.vho
INFO: [BD 41-3262] Generated Verilog Instantiation Template file d:/ecg_fpga/build/submission_cleancheck_v2/build/vivado/ecg_scope/ecg_overlay.gen/sources_1/bd/ecg_system/ecg_system.veo
INFO: [BD 41-3262] Generated System Verilog Instantiation Template file d:/ecg_fpga/build/submission_cleancheck_v2/build/vivado/ecg_scope/ecg_overlay.gen/sources_1/bd/ecg_system/ecg_system_sv.sveo
generate_target: Time (s): cpu = 00:00:18 ; elapsed = 00:00:28 . Memory (MB): peak = 831.906 ; gain = 40.711
### set ecg_wrappers [make_wrapper -files $ecg_bd_file -top]
### add_files -norecurse $ecg_wrappers
### set_property top ecg_system_wrapper [current_fileset]
### update_compile_order -fileset sources_1
### file mkdir [file join $ecg_root board overlay]
### write_bd_tcl -force [file join $ecg_root board overlay ecg_system_generated.tcl]
WARNING: [BD 41-2937] The design that will be created by this Tcl script contains the following user IPs:
/ecg_filter_0
Please add the following user repository(s):
d:/ecg_fpga/build/submission_cleancheck_v2/hls_ecg2/hls/impl/ip
before sourcing this Tcl script or use write_project_tcl.
INFO: [BD 5-148] Tcl file written out <D:/ecg_fpga/build/submission_cleancheck_v2/board/overlay/ecg_system_generated.tcl>.

### puts "ECG_DESIGN_READY: $ecg_project_dir/ecg_overlay.xpr"
ECG_DESIGN_READY: D:/ecg_fpga/build/submission_cleancheck_v2/build/vivado/ecg_scope/ecg_overlay.xpr
### puts "Next: source [file join $ecg_root board build_overlay.tcl]"
Next: source D:/ecg_fpga/build/submission_cleancheck_v2/board/build_overlay.tcl
## close_bd_design [current_bd_design]
## set_property ip_repo_paths [list [file join $ecg_root hls_ecg2 hls impl ip] [file join $ecg_root board vendor digilent]] [current_project]
## update_ip_catalog
INFO: [IP_Flow 19-234] Refreshing IP repositories
INFO: [IP_Flow 19-1700] Loaded user IP repository 'd:/ecg_fpga/build/submission_cleancheck_v2/hls_ecg2/hls/impl/ip'.
INFO: [IP_Flow 19-1700] Loaded user IP repository 'd:/ecg_fpga/build/submission_cleancheck_v2/board/vendor/digilent'.
## add_files -norecurse [glob [file join $ecg_root src rtl *.sv]]
## add_files -norecurse [glob [file join $ecg_root src rtl *.vh]]
## set_property include_dirs [list [file join $ecg_root src rtl]] [current_fileset]
## update_compile_order -fileset sources_1
## open_bd_design [get_files */ecg_system.bd]
Reading block design file <D:/ecg_fpga/build/submission_cleancheck_v2/build/vivado/ecg_scope/ecg_overlay.srcs/sources_1/bd/ecg_system/ecg_system.bd>...
Adding component instance block -- xilinx.com:ip:processing_system7:5.5 - ps7
Adding component instance block -- nuaa:ecg:ecg_filter_top:1.0 - ecg_filter_0
Adding component instance block -- xilinx.com:ip:smartconnect:1.0 - ctrl_connect
Adding component instance block -- xilinx.com:ip:smartconnect:1.0 - read_connect
Adding component instance block -- xilinx.com:ip:smartconnect:1.0 - write_connect
Adding component instance block -- xilinx.com:ip:proc_sys_reset:5.0 - reset_100m
Adding component instance block -- xilinx.com:ip:xlconstant:1.1 - const_one
Adding component instance block -- xilinx.com:ip:xlconstant:1.1 - const_zero
Successfully read diagram <ecg_system> from block design file <D:/ecg_fpga/build/submission_cleancheck_v2/build/vivado/ecg_scope/ecg_overlay.srcs/sources_1/bd/ecg_system/ecg_system.bd>
## create_bd_cell -type module -reference ecg_io_top ecg_io
WARNING: [IP_Flow 19-5101] Packaging a component with a SystemVerilog top file is not fully supported. Please refer to UG1118 'Creating and Packaging Custom IP'.
WARNING: [IP_Flow 19-587] [HDL Parser] HDL port or parameter 'fifo' has a dependency on the module local parameter or undefined parameter 'FIFO_DEPTH'.
WARNING: [IP_Flow 19-587] [HDL Parser] HDL port or parameter 'fifo_push' has a dependency on the module local parameter or undefined parameter 'FIFO_DEPTH'.
WARNING: [IP_Flow 19-587] [HDL Parser] HDL port or parameter 'drdy_missed' has a dependency on the module local parameter or undefined parameter 'FIFO_DEPTH'.
INFO: [IP_Flow 19-5107] Inferred bus interface 's_axi_aclk' of definition 'xilinx.com:signal:clock:1.0' (from X_INTERFACE_INFO parameter from HDL file).
INFO: [IP_Flow 19-5107] Inferred bus interface 's_axi_aclk' of definition 'xilinx.com:signal:clock:1.0' (from 'X_INTERFACE_INFO' attribute).
INFO: [IP_Flow 19-5107] Inferred bus interface 's_axi_aresetn' of definition 'xilinx.com:signal:reset:1.0' (from X_INTERFACE_INFO parameter from HDL file).
INFO: [IP_Flow 19-5107] Inferred bus interface 's_axi_aresetn' of definition 'xilinx.com:signal:reset:1.0' (from 'X_INTERFACE_INFO' attribute).
INFO: [IP_Flow 19-5107] Inferred bus interface 'pixel_clk' of definition 'xilinx.com:signal:clock:1.0' (from X_INTERFACE_INFO parameter from HDL file).
INFO: [IP_Flow 19-5107] Inferred bus interface 'pixel_clk' of definition 'xilinx.com:signal:clock:1.0' (from 'X_INTERFACE_INFO' attribute).
INFO: [IP_Flow 19-5107] Inferred bus interface 'pixel_resetn' of definition 'xilinx.com:signal:reset:1.0' (from X_INTERFACE_INFO parameter from HDL file).
INFO: [IP_Flow 19-5107] Inferred bus interface 'pixel_resetn' of definition 'xilinx.com:signal:reset:1.0' (from 'X_INTERFACE_INFO' attribute).
INFO: [IP_Flow 19-5107] Inferred bus interface 's_axi' of definition 'xilinx.com:interface:aximm:1.0' (from Xilinx Repository).
INFO: [IP_Flow 19-4728] Bus Interface 's_axi_aclk': Added interface parameter 'ASSOCIATED_BUSIF' with value 's_axi'.
INFO: [IP_Flow 19-4728] Bus Interface 's_axi_aclk': Added interface parameter 'ASSOCIATED_RESET' with value 's_axi_aresetn'.
INFO: [IP_Flow 19-4728] Bus Interface 'pixel_clk': Added interface parameter 'ASSOCIATED_RESET' with value 'pixel_resetn'.
INFO: [IP_Flow 19-4728] Bus Interface 's_axi_aclk': Added interface parameter 'FREQ_HZ' with value '100000000'.
INFO: [IP_Flow 19-4728] Bus Interface 's_axi_aresetn': Added interface parameter 'POLARITY' with value 'ACTIVE_LOW'.
INFO: [IP_Flow 19-4728] Bus Interface 'pixel_clk': Added interface parameter 'FREQ_HZ' with value '25200000'.
INFO: [IP_Flow 19-4728] Bus Interface 'pixel_resetn': Added interface parameter 'POLARITY' with value 'ACTIVE_LOW'.
INFO: [IP_Flow 19-7067] Note that bus interface 's_axi_aclk' has a fixed FREQ_HZ of '100000000'. This value will be respected whenever this IP is instantiated in IP Integrator.
INFO: [IP_Flow 19-7067] Note that bus interface 'pixel_clk' has a fixed FREQ_HZ of '25200000'. This value will be respected whenever this IP is instantiated in IP Integrator.
WARNING: [IP_Flow 19-5661] Bus Interface 'pixel_clk' does not have any bus interfaces associated with it.
WARNING: [IP_Flow 19-3158] Bus Interface 's_axi': FREQ_HZ bus parameter missing from AXI interface when interface is not associated to a clock.
## set_property CONFIG.NUM_MI {2} [get_bd_cells ctrl_connect]
## set ecg_axi [get_bd_intf_pins -of_objects [get_bd_cells ecg_io] -filter {VLNV =~ *aximm_rtl*}]
## if {[llength $ecg_axi]!=1} {error "Could not infer ecg_io AXI interface: $ecg_axi"}
## connect_bd_intf_net [get_bd_intf_pins ctrl_connect/M01_AXI] $ecg_axi
## create_bd_cell -type ip -vlnv xilinx.com:ip:clk_wiz:6.0 video_clocks
INFO: [Device 21-403] Loading part xc7z020clg400-1
## set_property -dict [list CONFIG.PRIM_IN_FREQ {100.000} CONFIG.PRIM_SOURCE {No_buffer} CONFIG.NUM_OUT_CLKS {2} \
##  CONFIG.CLKOUT1_REQUESTED_OUT_FREQ {25.200} CONFIG.CLKOUT2_USED {true} \
##  CONFIG.CLKOUT2_REQUESTED_OUT_FREQ {126.000} CONFIG.RESET_TYPE {ACTIVE_LOW} \
##  CONFIG.USE_RESET {true} CONFIG.USE_LOCKED {true}] [get_bd_cells video_clocks]
## create_bd_cell -type ip -vlnv digilentinc.com:ip:rgb2dvi:1.4 hdmi_encoder
## set_property -dict [list CONFIG.kGenerateSerialClk {false} CONFIG.kRstActiveHigh {false}] [get_bd_cells hdmi_encoder]
## create_bd_cell -type ip -vlnv xilinx.com:ip:proc_sys_reset:5.0 reset_video
INFO: [Ipptcl 7-1463] No Compatible Board Interface found. Board Tab not created in customize GUI
## set_property CONFIG.C_AUX_RESET_HIGH {1} [get_bd_cells reset_video]
## set_property CONFIG.C_EXT_RESET_HIGH {0} [get_bd_cells reset_video]
CRITICAL WARNING: [BD 41-737] Cannot set the parameter C_EXT_RESET_HIGH on /reset_video. It is read-only.
## connect_bd_net [get_bd_pins ps7/FCLK_CLK0] [get_bd_pins ecg_io/s_axi_aclk] [get_bd_pins video_clocks/clk_in1]
## connect_bd_net [get_bd_pins ps7/FCLK_RESET0_N] [get_bd_pins video_clocks/resetn] [get_bd_pins reset_video/ext_reset_in]
## disconnect_bd_net [get_bd_nets -of_objects [get_bd_pins reset_100m/dcm_locked]] [get_bd_pins reset_100m/dcm_locked]
## connect_bd_net [get_bd_pins video_clocks/locked] [get_bd_pins reset_100m/dcm_locked] [get_bd_pins reset_video/dcm_locked]
## connect_bd_net [get_bd_pins reset_100m/peripheral_aresetn] [get_bd_pins ecg_io/s_axi_aresetn]
## connect_bd_net [get_bd_pins const_zero/dout] [get_bd_pins reset_video/aux_reset_in] [get_bd_pins reset_video/mb_debug_sys_rst]
## connect_bd_net [get_bd_pins video_clocks/clk_out1] [get_bd_pins reset_video/slowest_sync_clk] \
##  [get_bd_pins ecg_io/pixel_clk] [get_bd_pins hdmi_encoder/PixelClk]
## connect_bd_net [get_bd_pins video_clocks/clk_out2] [get_bd_pins hdmi_encoder/SerialClk]
## connect_bd_net [get_bd_pins reset_video/peripheral_aresetn] [get_bd_pins ecg_io/pixel_resetn] [get_bd_pins hdmi_encoder/aRst_n]
## connect_bd_net [get_bd_pins ecg_io/video_rgb] [get_bd_pins hdmi_encoder/vid_pData]
WARNING: [BD 41-1306] The connection to interface pin </hdmi_encoder/vid_pData> is being overridden by the user with net <ecg_io_video_rgb>. This pin will not be connected as a part of interface connection <RGB>, and might not recreate the connectivity as expected using the writ_bd_tcl command.
## connect_bd_net [get_bd_pins ecg_io/video_de] [get_bd_pins hdmi_encoder/vid_pVDE]
WARNING: [BD 41-1306] The connection to interface pin </hdmi_encoder/vid_pVDE> is being overridden by the user with net <ecg_io_video_de>. This pin will not be connected as a part of interface connection <RGB>, and might not recreate the connectivity as expected using the writ_bd_tcl command.
## connect_bd_net [get_bd_pins ecg_io/video_hsync] [get_bd_pins hdmi_encoder/vid_pHSync]
WARNING: [BD 41-1306] The connection to interface pin </hdmi_encoder/vid_pHSync> is being overridden by the user with net <ecg_io_video_hsync>. This pin will not be connected as a part of interface connection <RGB>, and might not recreate the connectivity as expected using the writ_bd_tcl command.
## connect_bd_net [get_bd_pins ecg_io/video_vsync] [get_bd_pins hdmi_encoder/vid_pVSync]
WARNING: [BD 41-1306] The connection to interface pin </hdmi_encoder/vid_pVSync> is being overridden by the user with net <ecg_io_video_vsync>. This pin will not be connected as a part of interface connection <RGB>, and might not recreate the connectivity as expected using the writ_bd_tcl command.
## proc scope_port {name dir pin {left -1}} {
##  if {$left>=0} {set p [create_bd_port -dir $dir -from $left -to 0 $name]} else {set p [create_bd_port -dir $dir $name]}
##  connect_bd_net $p [get_bd_pins $pin]
## }
## foreach p {ads_cs_n ads_sclk ads_din ads_start ads_pwdn_reset_n} {scope_port $p O ecg_io/$p}
## foreach p {ads_dout ads_drdy_n hdmi_hpd} {scope_port $p I ecg_io/$p}
## scope_port buttons I ecg_io/buttons 3
## scope_port sw0 I ecg_io/sw0
## scope_port hdmi_clk_p O hdmi_encoder/TMDS_Clk_p
WARNING: [BD 41-1306] The connection to interface pin </hdmi_encoder/TMDS_Clk_p> is being overridden by the user with net <hdmi_encoder_TMDS_Clk_p>. This pin will not be connected as a part of interface connection <TMDS>, and might not recreate the connectivity as expected using the writ_bd_tcl command.
## scope_port hdmi_clk_n O hdmi_encoder/TMDS_Clk_n
WARNING: [BD 41-1306] The connection to interface pin </hdmi_encoder/TMDS_Clk_n> is being overridden by the user with net <hdmi_encoder_TMDS_Clk_n>. This pin will not be connected as a part of interface connection <TMDS>, and might not recreate the connectivity as expected using the writ_bd_tcl command.
## scope_port hdmi_data_p O hdmi_encoder/TMDS_Data_p 2
WARNING: [BD 41-1306] The connection to interface pin </hdmi_encoder/TMDS_Data_p> is being overridden by the user with net <hdmi_encoder_TMDS_Data_p>. This pin will not be connected as a part of interface connection <TMDS>, and might not recreate the connectivity as expected using the writ_bd_tcl command.
## scope_port hdmi_data_n O hdmi_encoder/TMDS_Data_n 2
WARNING: [BD 41-1306] The connection to interface pin </hdmi_encoder/TMDS_Data_n> is being overridden by the user with net <hdmi_encoder_TMDS_Data_n>. This pin will not be connected as a part of interface connection <TMDS>, and might not recreate the connectivity as expected using the writ_bd_tcl command.
## assign_bd_address
INFO: [BD 41-3093] Triggering Legacy Auto Assign Algorithm
Slave segment '/ecg_io/s_axi/reg0' is being assigned into address space '/ps7/Data' at <0x4001_0000 [ 64K ]>.
## set ecg_io_seg [get_bd_addr_segs -of_objects [get_bd_addr_spaces ps7/Data] -filter {NAME =~ *ecg_io*}]
## if {[llength $ecg_io_seg]!=1} {error "Missing ecg_io control address segment"}
## set_property offset 0x40010000 $ecg_io_seg
## set_property range 64K $ecg_io_seg
## validate_bd_design
WARNING: [BD 41-3281] Instance '/ecg_filter_0' is connected on both sides by SmartConnects and cannot automatically configure itself to match the endpoints. Please manually configure its AXI interfaces as required for the design.
WARNING: [BD 41-3281] Instance '/ps7' is connected on both sides by SmartConnects and cannot automatically configure itself to match the endpoints. Please manually configure its AXI interfaces as required for the design.
clk_domain: ecg_system_ps7_0_FCLK_CLK0, clk_domain_1: ecg_system_video_clocks_0_clk_out1, clkDomainValSrc_1: DEFAULT, clk_domain_ctrl: 0
WARNING: [BD 41-702] Propagation TCL tries to overwrite USER strength parameter PCW_M_AXI_GP0_FREQMHZ(10) on '/ps7' with propagated value(100). Command ignored
INFO: [BD 5-943] Reserving offset range <0x4000_0000 [ 64K ]> from slave interface '/ctrl_connect/S00_AXI' to master interface '/ctrl_connect/M00_AXI'. This will be used by smartconnect on path for routing.
INFO: [BD 5-943] Reserving offset range <0x4001_0000 [ 64K ]> from slave interface '/ctrl_connect/S00_AXI' to master interface '/ctrl_connect/M01_AXI'. This will be used by smartconnect on path for routing.
INFO: [xilinx.com:ip:smartconnect:1.0-1] ecg_system_ctrl_connect_0: SmartConnect ecg_system_ctrl_connect_0 is in Ultralite mode.
INFO: [BD 5-943] Reserving offset range <0x0000_0000 [ 512M ]> from slave interface '/read_connect/S00_AXI' to master interface '/read_connect/M00_AXI'. This will be used by smartconnect on path for routing.
INFO: [xilinx.com:ip:smartconnect:1.0-1] ecg_system_read_connect_0: SmartConnect ecg_system_read_connect_0 is in High-performance Mode.
INFO: [Ipptcl 7-1463] No Compatible Board Interface found. Board Tab not created in customize GUI
INFO: [BD 5-943] Reserving offset range <0x0000_0000 [ 512M ]> from slave interface '/write_connect/S00_AXI' to master interface '/write_connect/M00_AXI'. This will be used by smartconnect on path for routing.
INFO: [xilinx.com:ip:smartconnect:1.0-1] ecg_system_write_connect_0: SmartConnect ecg_system_write_connect_0 is in High-performance Mode.
INFO: [xilinx.com:ip:clk_wiz:6.0-1] /video_clocks clk_wiz propagate
## save_bd_design
Wrote  : <D:\ecg_fpga\build\submission_cleancheck_v2\build\vivado\ecg_scope\ecg_overlay.srcs\sources_1\bd\ecg_system\ecg_system.bd> 
## generate_target all [get_files */ecg_system.bd]
INFO: [BD 41-1662] The design 'ecg_system.bd' is already validated. Therefore parameter propagation will not be re-run.
WARNING: [BD 41-2384] Width mismatch when connecting pin: '/read_connect/S00_AXI_arlock'(1) to pin: '/ecg_filter_0/m_axi_gmem0_ARLOCK'(2) - Only lower order bits will be connected.
WARNING: [BD 41-2384] Width mismatch when connecting pin: '/write_connect/S00_AXI_awlock'(1) to pin: '/ecg_filter_0/m_axi_gmem1_AWLOCK'(2) - Only lower order bits will be connected.
Verilog Output written to : d:/ecg_fpga/build/submission_cleancheck_v2/build/vivado/ecg_scope/ecg_overlay.gen/sources_1/bd/ecg_system/synth/ecg_system.v
WARNING: [BD 41-2384] Width mismatch when connecting pin: '/read_connect/S00_AXI_arlock'(1) to pin: '/ecg_filter_0/m_axi_gmem0_ARLOCK'(2) - Only lower order bits will be connected.
WARNING: [BD 41-2384] Width mismatch when connecting pin: '/write_connect/S00_AXI_awlock'(1) to pin: '/ecg_filter_0/m_axi_gmem1_AWLOCK'(2) - Only lower order bits will be connected.
Verilog Output written to : d:/ecg_fpga/build/submission_cleancheck_v2/build/vivado/ecg_scope/ecg_overlay.gen/sources_1/bd/ecg_system/sim/ecg_system.v
Verilog Output written to : d:/ecg_fpga/build/submission_cleancheck_v2/build/vivado/ecg_scope/ecg_overlay.gen/sources_1/bd/ecg_system/hdl/ecg_system_wrapper.v
Exporting to file d:/ecg_fpga/build/submission_cleancheck_v2/build/vivado/ecg_scope/ecg_overlay.gen/sources_1/bd/ecg_system/ip/ecg_system_ctrl_connect_0/bd_0/hw_handoff/ecg_system_ctrl_connect_0.hwh
Generated Hardware Definition File d:/ecg_fpga/build/submission_cleancheck_v2/build/vivado/ecg_scope/ecg_overlay.gen/sources_1/bd/ecg_system/ip/ecg_system_ctrl_connect_0/bd_0/synth/ecg_system_ctrl_connect_0.hwdef
INFO: [BD 41-1029] Generation completed for the IP Integrator block ctrl_connect .
Exporting to file d:/ecg_fpga/build/submission_cleancheck_v2/build/vivado/ecg_scope/ecg_overlay.gen/sources_1/bd/ecg_system/ip/ecg_system_read_connect_0/bd_0/hw_handoff/ecg_system_read_connect_0.hwh
Generated Hardware Definition File d:/ecg_fpga/build/submission_cleancheck_v2/build/vivado/ecg_scope/ecg_overlay.gen/sources_1/bd/ecg_system/ip/ecg_system_read_connect_0/bd_0/synth/ecg_system_read_connect_0.hwdef
INFO: [BD 41-1029] Generation completed for the IP Integrator block read_connect .
Exporting to file d:/ecg_fpga/build/submission_cleancheck_v2/build/vivado/ecg_scope/ecg_overlay.gen/sources_1/bd/ecg_system/ip/ecg_system_write_connect_0/bd_0/hw_handoff/ecg_system_write_connect_0.hwh
Generated Hardware Definition File d:/ecg_fpga/build/submission_cleancheck_v2/build/vivado/ecg_scope/ecg_overlay.gen/sources_1/bd/ecg_system/ip/ecg_system_write_connect_0/bd_0/synth/ecg_system_write_connect_0.hwdef
INFO: [BD 41-1029] Generation completed for the IP Integrator block write_connect .
INFO: [BD 41-1029] Generation completed for the IP Integrator block ecg_io .
INFO: [BD 41-1029] Generation completed for the IP Integrator block video_clocks .
INFO: [BD 41-1029] Generation completed for the IP Integrator block hdmi_encoder .
INFO: [BD 41-1029] Generation completed for the IP Integrator block reset_video .
Exporting to file d:/ecg_fpga/build/submission_cleancheck_v2/build/vivado/ecg_scope/ecg_overlay.gen/sources_1/bd/ecg_system/hw_handoff/ecg_system.hwh
Generated Hardware Definition File d:/ecg_fpga/build/submission_cleancheck_v2/build/vivado/ecg_scope/ecg_overlay.gen/sources_1/bd/ecg_system/synth/ecg_system.hwdef
INFO: [BD 41-3262] Generated VHDL Instantiation Template file d:/ecg_fpga/build/submission_cleancheck_v2/build/vivado/ecg_scope/ecg_overlay.gen/sources_1/bd/ecg_system/ecg_system.vho
INFO: [BD 41-3262] Generated Verilog Instantiation Template file d:/ecg_fpga/build/submission_cleancheck_v2/build/vivado/ecg_scope/ecg_overlay.gen/sources_1/bd/ecg_system/ecg_system.veo
INFO: [BD 41-3262] Generated System Verilog Instantiation Template file d:/ecg_fpga/build/submission_cleancheck_v2/build/vivado/ecg_scope/ecg_overlay.gen/sources_1/bd/ecg_system/ecg_system_sv.sveo
generate_target: Time (s): cpu = 00:00:04 ; elapsed = 00:00:08 . Memory (MB): peak = 1092.770 ; gain = 13.445
## set_property top ecg_system_wrapper [current_fileset]
## add_files -fileset constrs_1 [file join $ecg_root board ads1292_pmoda.xdc]
## add_files -fileset constrs_1 [file join $ecg_root board scope_hdmi.xdc]
## update_compile_order -fileset sources_1
## file mkdir [file join $ecg_root board scope]
## write_bd_tcl -force [file join $ecg_root board scope ecg_scope_generated.tcl]
WARNING: [BD 41-2937] The design that will be created by this Tcl script contains the following user IPs:
/ecg_filter_0, /hdmi_encoder
Please add the following user repository(s):
d:/ecg_fpga/build/submission_cleancheck_v2/hls_ecg2/hls/impl/ip
d:/ecg_fpga/build/submission_cleancheck_v2/board/vendor/digilent
before sourcing this Tcl script or use write_project_tcl.
WARNING: [BD 41-2925] The design that will be created by this Tcl script contains the following module references: ecg_io_top.
Please add the sources of those modules before sourcing this Tcl script or use write_project_tcl.
INFO: [BD 5-148] Tcl file written out <D:/ecg_fpga/build/submission_cleancheck_v2/board/scope/ecg_scope_generated.tcl>.

## puts "ECG_SCOPE_READY"
ECG_SCOPE_READY
# close_bd_design [current_bd_design]
# set_property ip_repo_paths [list [file join $root hls_ecg2 hls impl ip] [file join $root hls_conv hls impl ip] [file join $root board vendor digilent]] [current_project]
# update_ip_catalog
INFO: [IP_Flow 19-234] Refreshing IP repositories
INFO: [IP_Flow 19-1700] Loaded user IP repository 'd:/ecg_fpga/build/submission_cleancheck_v2/hls_ecg2/hls/impl/ip'.
INFO: [IP_Flow 19-1700] Loaded user IP repository 'd:/ecg_fpga/build/submission_cleancheck_v2/hls_conv/hls/impl/ip'.
INFO: [IP_Flow 19-1700] Loaded user IP repository 'd:/ecg_fpga/build/submission_cleancheck_v2/board/vendor/digilent'.
# open_bd_design [get_files */ecg_system.bd]
Reading block design file <D:/ecg_fpga/build/submission_cleancheck_v2/build/vivado/ecg_scope/ecg_overlay.srcs/sources_1/bd/ecg_system/ecg_system.bd>...
Adding component instance block -- xilinx.com:ip:processing_system7:5.5 - ps7
Adding component instance block -- nuaa:ecg:ecg_filter_top:1.0 - ecg_filter_0
Adding component instance block -- xilinx.com:ip:smartconnect:1.0 - ctrl_connect
Adding component instance block -- xilinx.com:ip:smartconnect:1.0 - read_connect
Adding component instance block -- xilinx.com:ip:smartconnect:1.0 - write_connect
Adding component instance block -- xilinx.com:ip:proc_sys_reset:5.0 - reset_100m
Adding component instance block -- xilinx.com:ip:xlconstant:1.1 - const_one
Adding component instance block -- xilinx.com:ip:xlconstant:1.1 - const_zero
Adding component instance block -- xilinx.com:module_ref:ecg_io_top:1.0 - ecg_io
Adding component instance block -- xilinx.com:ip:clk_wiz:6.0 - video_clocks
Adding component instance block -- digilentinc.com:ip:rgb2dvi:1.4 - hdmi_encoder
Adding component instance block -- xilinx.com:ip:proc_sys_reset:5.0 - reset_video
Successfully read diagram <ecg_system> from block design file <D:/ecg_fpga/build/submission_cleancheck_v2/build/vivado/ecg_scope/ecg_overlay.srcs/sources_1/bd/ecg_system/ecg_system.bd>
# set_property -dict [list CONFIG.PCW_USE_S_AXI_HP2 {1} CONFIG.PCW_USE_S_AXI_HP3 {1}] [get_bd_cells ps7]
CRITICAL WARNING: [PSU-1]  Parameter : PCW_UIPARAM_DDR_DQS_TO_CLK_DELAY_0 has negative value -0.051 . PS DDR interfaces might fail when entering negative DQS skew values. 
CRITICAL WARNING: [PSU-2]  Parameter : PCW_UIPARAM_DDR_DQS_TO_CLK_DELAY_1 has negative value -0.006 . PS DDR interfaces might fail when entering negative DQS skew values. 
CRITICAL WARNING: [PSU-3]  Parameter : PCW_UIPARAM_DDR_DQS_TO_CLK_DELAY_2 has negative value -0.009 . PS DDR interfaces might fail when entering negative DQS skew values. 
CRITICAL WARNING: [PSU-4]  Parameter : PCW_UIPARAM_DDR_DQS_TO_CLK_DELAY_3 has negative value -0.033 . PS DDR interfaces might fail when entering negative DQS skew values. 
# set_property CONFIG.NUM_MI 3 [get_bd_cells ctrl_connect]
# create_bd_cell -type ip -vlnv nuaa:ecg:ecg_conv:1.0 ecg_conv_0
# connect_bd_intf_net [get_bd_intf_pins ctrl_connect/M02_AXI] [get_bd_intf_pins ecg_conv_0/s_axi_ctrl]
# foreach {name master slave} {conv_read gmem0 HP2 conv_write gmem1 HP3} {
#  create_bd_cell -type ip -vlnv xilinx.com:ip:smartconnect:1.0 $name
#  set_property -dict [list CONFIG.NUM_SI 1 CONFIG.NUM_MI 1] [get_bd_cells $name]
#  connect_bd_intf_net [get_bd_intf_pins ecg_conv_0/m_axi_$master] [get_bd_intf_pins $name/S00_AXI]
#  connect_bd_intf_net [get_bd_intf_pins $name/M00_AXI] [get_bd_intf_pins ps7/S_AXI_$slave]
#  connect_bd_net [get_bd_pins ps7/FCLK_CLK0] [get_bd_pins $name/aclk] [get_bd_pins ps7/S_AXI_${slave}_ACLK]
#  connect_bd_net [get_bd_pins reset_100m/peripheral_aresetn] [get_bd_pins $name/aresetn]
# }
# connect_bd_net [get_bd_pins ps7/FCLK_CLK0] [get_bd_pins ecg_conv_0/ap_clk]
# connect_bd_net [get_bd_pins reset_100m/peripheral_aresetn] [get_bd_pins ecg_conv_0/ap_rst_n]
# assign_bd_address
INFO: [BD 41-3093] Triggering Legacy Auto Assign Algorithm
Slave segment '/ps7/S_AXI_HP2/HP2_DDR_LOWOCM' is being assigned into address space '/ecg_conv_0/Data_m_axi_gmem0' at <0x0000_0000 [ 512M ]>.
Slave segment '/ps7/S_AXI_HP3/HP3_DDR_LOWOCM' is being assigned into address space '/ecg_conv_0/Data_m_axi_gmem1' at <0x0000_0000 [ 512M ]>.
Slave segment '/ecg_conv_0/s_axi_ctrl/Reg' is being assigned into address space '/ps7/Data' at <0x4002_0000 [ 64K ]>.
# set seg [get_bd_addr_segs -of_objects [get_bd_addr_spaces ps7/Data] -filter {NAME =~ *ecg_conv_0*}]
# set_property offset 0x40020000 $seg
# set_property range 64K $seg
# validate_bd_design
WARNING: [BD 41-3281] Instance '/ps7' is connected on both sides by SmartConnects and cannot automatically configure itself to match the endpoints. Please manually configure its AXI interfaces as required for the design.
WARNING: [BD 41-3281] Instance '/ecg_filter_0' is connected on both sides by SmartConnects and cannot automatically configure itself to match the endpoints. Please manually configure its AXI interfaces as required for the design.
WARNING: [BD 41-3281] Instance '/ecg_conv_0' is connected on both sides by SmartConnects and cannot automatically configure itself to match the endpoints. Please manually configure its AXI interfaces as required for the design.
clk_domain: ecg_system_ps7_0_FCLK_CLK0, clk_domain_1: ecg_system_ps7_0_FCLK_CLK0, clkDomainValSrc_1: PROPAGATED, clk_domain_ctrl: 0
WARNING: [BD 41-702] Propagation TCL tries to overwrite USER strength parameter PCW_M_AXI_GP0_FREQMHZ(10) on '/ps7' with propagated value(100). Command ignored
CRITICAL WARNING: [PSU-1]  Parameter : PCW_UIPARAM_DDR_DQS_TO_CLK_DELAY_0 has negative value -0.051 . PS DDR interfaces might fail when entering negative DQS skew values. 
CRITICAL WARNING: [PSU-2]  Parameter : PCW_UIPARAM_DDR_DQS_TO_CLK_DELAY_1 has negative value -0.006 . PS DDR interfaces might fail when entering negative DQS skew values. 
CRITICAL WARNING: [PSU-3]  Parameter : PCW_UIPARAM_DDR_DQS_TO_CLK_DELAY_2 has negative value -0.009 . PS DDR interfaces might fail when entering negative DQS skew values. 
CRITICAL WARNING: [PSU-4]  Parameter : PCW_UIPARAM_DDR_DQS_TO_CLK_DELAY_3 has negative value -0.033 . PS DDR interfaces might fail when entering negative DQS skew values. 
INFO: [BD 5-943] Reserving offset range <0x4000_0000 [ 64K ]> from slave interface '/ctrl_connect/S00_AXI' to master interface '/ctrl_connect/M00_AXI'. This will be used by smartconnect on path for routing.
INFO: [BD 5-943] Reserving offset range <0x4001_0000 [ 64K ]> from slave interface '/ctrl_connect/S00_AXI' to master interface '/ctrl_connect/M01_AXI'. This will be used by smartconnect on path for routing.
INFO: [BD 5-943] Reserving offset range <0x4002_0000 [ 64K ]> from slave interface '/ctrl_connect/S00_AXI' to master interface '/ctrl_connect/M02_AXI'. This will be used by smartconnect on path for routing.
INFO: [xilinx.com:ip:smartconnect:1.0-1] ecg_system_ctrl_connect_0: SmartConnect ecg_system_ctrl_connect_0 is in Ultralite mode.
INFO: [BD 5-943] Reserving offset range <0x0000_0000 [ 512M ]> from slave interface '/read_connect/S00_AXI' to master interface '/read_connect/M00_AXI'. This will be used by smartconnect on path for routing.
INFO: [xilinx.com:ip:smartconnect:1.0-1] ecg_system_read_connect_0: SmartConnect ecg_system_read_connect_0 is in High-performance Mode.
INFO: [Ipptcl 7-1463] No Compatible Board Interface found. Board Tab not created in customize GUI
INFO: [BD 5-943] Reserving offset range <0x0000_0000 [ 512M ]> from slave interface '/write_connect/S00_AXI' to master interface '/write_connect/M00_AXI'. This will be used by smartconnect on path for routing.
INFO: [xilinx.com:ip:smartconnect:1.0-1] ecg_system_write_connect_0: SmartConnect ecg_system_write_connect_0 is in High-performance Mode.
INFO: [BD 5-943] Reserving offset range <0x0000_0000 [ 512M ]> from slave interface '/conv_read/S00_AXI' to master interface '/conv_read/M00_AXI'. This will be used by smartconnect on path for routing.
INFO: [xilinx.com:ip:smartconnect:1.0-1] ecg_system_conv_read_0: SmartConnect ecg_system_conv_read_0 is in High-performance Mode.
INFO: [BD 5-943] Reserving offset range <0x0000_0000 [ 512M ]> from slave interface '/conv_write/S00_AXI' to master interface '/conv_write/M00_AXI'. This will be used by smartconnect on path for routing.
INFO: [xilinx.com:ip:smartconnect:1.0-1] ecg_system_conv_write_0: SmartConnect ecg_system_conv_write_0 is in High-performance Mode.
INFO: [xilinx.com:ip:clk_wiz:6.0-1] /video_clocks clk_wiz propagate
validate_bd_design: Time (s): cpu = 00:00:07 ; elapsed = 00:00:09 . Memory (MB): peak = 1122.969 ; gain = 30.199
# save_bd_design
Wrote  : <D:\ecg_fpga\build\submission_cleancheck_v2\build\vivado\ecg_scope\ecg_overlay.srcs\sources_1\bd\ecg_system\ecg_system.bd> 
# generate_target all [get_files */ecg_system.bd]
INFO: [BD 41-1662] The design 'ecg_system.bd' is already validated. Therefore parameter propagation will not be re-run.
WARNING: [BD 41-2384] Width mismatch when connecting pin: '/read_connect/S00_AXI_arlock'(1) to pin: '/ecg_filter_0/m_axi_gmem0_ARLOCK'(2) - Only lower order bits will be connected.
WARNING: [BD 41-2384] Width mismatch when connecting pin: '/write_connect/S00_AXI_awlock'(1) to pin: '/ecg_filter_0/m_axi_gmem1_AWLOCK'(2) - Only lower order bits will be connected.
WARNING: [BD 41-2384] Width mismatch when connecting pin: '/conv_read/S00_AXI_arlock'(1) to pin: '/ecg_conv_0/m_axi_gmem0_ARLOCK'(2) - Only lower order bits will be connected.
WARNING: [BD 41-2384] Width mismatch when connecting pin: '/conv_write/S00_AXI_awlock'(1) to pin: '/ecg_conv_0/m_axi_gmem1_AWLOCK'(2) - Only lower order bits will be connected.
Verilog Output written to : d:/ecg_fpga/build/submission_cleancheck_v2/build/vivado/ecg_scope/ecg_overlay.gen/sources_1/bd/ecg_system/synth/ecg_system.v
WARNING: [BD 41-2384] Width mismatch when connecting pin: '/read_connect/S00_AXI_arlock'(1) to pin: '/ecg_filter_0/m_axi_gmem0_ARLOCK'(2) - Only lower order bits will be connected.
WARNING: [BD 41-2384] Width mismatch when connecting pin: '/write_connect/S00_AXI_awlock'(1) to pin: '/ecg_filter_0/m_axi_gmem1_AWLOCK'(2) - Only lower order bits will be connected.
WARNING: [BD 41-2384] Width mismatch when connecting pin: '/conv_read/S00_AXI_arlock'(1) to pin: '/ecg_conv_0/m_axi_gmem0_ARLOCK'(2) - Only lower order bits will be connected.
WARNING: [BD 41-2384] Width mismatch when connecting pin: '/conv_write/S00_AXI_awlock'(1) to pin: '/ecg_conv_0/m_axi_gmem1_AWLOCK'(2) - Only lower order bits will be connected.
Verilog Output written to : d:/ecg_fpga/build/submission_cleancheck_v2/build/vivado/ecg_scope/ecg_overlay.gen/sources_1/bd/ecg_system/sim/ecg_system.v
Verilog Output written to : d:/ecg_fpga/build/submission_cleancheck_v2/build/vivado/ecg_scope/ecg_overlay.gen/sources_1/bd/ecg_system/hdl/ecg_system_wrapper.v
INFO: [IP_Flow 19-5611] Unable to find an associated reset port for the interface 'M_AXI_GP0'. A default connection has been created.
INFO: [IP_Flow 19-5611] Unable to find an associated reset port for the interface 'S_AXI_HP0'. A default connection has been created.
INFO: [IP_Flow 19-5611] Unable to find an associated reset port for the interface 'S_AXI_HP1'. A default connection has been created.
INFO: [IP_Flow 19-5611] Unable to find an associated reset port for the interface 'S_AXI_HP2'. A default connection has been created.
INFO: [IP_Flow 19-5611] Unable to find an associated reset port for the interface 'S_AXI_HP3'. A default connection has been created.
INFO: [BD 41-1029] Generation completed for the IP Integrator block ps7 .
Exporting to file d:/ecg_fpga/build/submission_cleancheck_v2/build/vivado/ecg_scope/ecg_overlay.gen/sources_1/bd/ecg_system/ip/ecg_system_ctrl_connect_0/bd_0/hw_handoff/ecg_system_ctrl_connect_0.hwh
Generated Hardware Definition File d:/ecg_fpga/build/submission_cleancheck_v2/build/vivado/ecg_scope/ecg_overlay.gen/sources_1/bd/ecg_system/ip/ecg_system_ctrl_connect_0/bd_0/synth/ecg_system_ctrl_connect_0.hwdef
INFO: [BD 41-1029] Generation completed for the IP Integrator block ctrl_connect .
Exporting to file d:/ecg_fpga/build/submission_cleancheck_v2/build/vivado/ecg_scope/ecg_overlay.gen/sources_1/bd/ecg_system/ip/ecg_system_read_connect_0/bd_0/hw_handoff/ecg_system_read_connect_0.hwh
Generated Hardware Definition File d:/ecg_fpga/build/submission_cleancheck_v2/build/vivado/ecg_scope/ecg_overlay.gen/sources_1/bd/ecg_system/ip/ecg_system_read_connect_0/bd_0/synth/ecg_system_read_connect_0.hwdef
INFO: [BD 41-1029] Generation completed for the IP Integrator block read_connect .
Exporting to file d:/ecg_fpga/build/submission_cleancheck_v2/build/vivado/ecg_scope/ecg_overlay.gen/sources_1/bd/ecg_system/ip/ecg_system_write_connect_0/bd_0/hw_handoff/ecg_system_write_connect_0.hwh
Generated Hardware Definition File d:/ecg_fpga/build/submission_cleancheck_v2/build/vivado/ecg_scope/ecg_overlay.gen/sources_1/bd/ecg_system/ip/ecg_system_write_connect_0/bd_0/synth/ecg_system_write_connect_0.hwdef
INFO: [BD 41-1029] Generation completed for the IP Integrator block write_connect .
INFO: [BD 41-1029] Generation completed for the IP Integrator block ecg_conv_0 .
Exporting to file d:/ecg_fpga/build/submission_cleancheck_v2/build/vivado/ecg_scope/ecg_overlay.gen/sources_1/bd/ecg_system/ip/ecg_system_conv_read_0/bd_0/hw_handoff/ecg_system_conv_read_0.hwh
Generated Hardware Definition File d:/ecg_fpga/build/submission_cleancheck_v2/build/vivado/ecg_scope/ecg_overlay.gen/sources_1/bd/ecg_system/ip/ecg_system_conv_read_0/bd_0/synth/ecg_system_conv_read_0.hwdef
INFO: [BD 41-1029] Generation completed for the IP Integrator block conv_read .
Exporting to file d:/ecg_fpga/build/submission_cleancheck_v2/build/vivado/ecg_scope/ecg_overlay.gen/sources_1/bd/ecg_system/ip/ecg_system_conv_write_0/bd_0/hw_handoff/ecg_system_conv_write_0.hwh
Generated Hardware Definition File d:/ecg_fpga/build/submission_cleancheck_v2/build/vivado/ecg_scope/ecg_overlay.gen/sources_1/bd/ecg_system/ip/ecg_system_conv_write_0/bd_0/synth/ecg_system_conv_write_0.hwdef
INFO: [BD 41-1029] Generation completed for the IP Integrator block conv_write .
Exporting to file d:/ecg_fpga/build/submission_cleancheck_v2/build/vivado/ecg_scope/ecg_overlay.gen/sources_1/bd/ecg_system/hw_handoff/ecg_system.hwh
Generated Hardware Definition File d:/ecg_fpga/build/submission_cleancheck_v2/build/vivado/ecg_scope/ecg_overlay.gen/sources_1/bd/ecg_system/synth/ecg_system.hwdef
INFO: [BD 41-3262] Generated VHDL Instantiation Template file d:/ecg_fpga/build/submission_cleancheck_v2/build/vivado/ecg_scope/ecg_overlay.gen/sources_1/bd/ecg_system/ecg_system.vho
INFO: [BD 41-3262] Generated Verilog Instantiation Template file d:/ecg_fpga/build/submission_cleancheck_v2/build/vivado/ecg_scope/ecg_overlay.gen/sources_1/bd/ecg_system/ecg_system.veo
INFO: [BD 41-3262] Generated System Verilog Instantiation Template file d:/ecg_fpga/build/submission_cleancheck_v2/build/vivado/ecg_scope/ecg_overlay.gen/sources_1/bd/ecg_system/ecg_system_sv.sveo
generate_target: Time (s): cpu = 00:00:26 ; elapsed = 00:00:34 . Memory (MB): peak = 1189.980 ; gain = 67.012
# update_compile_order -fileset sources_1
# make_wrapper -files [get_files */ecg_system.bd] -top -force
# add_files -fileset constrs_1 [file join $root board dual_view.xdc]
# if {[lsearch -exact $argv --validate-only]>=0} {
#  write_bd_tcl -force [file join $root build clean_system_generated.tcl]
#  puts "CLEAN_BD_VALIDATION_PASS: reused exported IP; not a full HLS/bit rebuild"
#  close_project
#  exit
# }
WARNING: [BD 41-2937] The design that will be created by this Tcl script contains the following user IPs:
/ecg_filter_0, /hdmi_encoder, /ecg_conv_0
Please add the following user repository(s):
d:/ecg_fpga/build/submission_cleancheck_v2/hls_ecg2/hls/impl/ip
d:/ecg_fpga/build/submission_cleancheck_v2/board/vendor/digilent
d:/ecg_fpga/build/submission_cleancheck_v2/hls_conv/hls/impl/ip
before sourcing this Tcl script or use write_project_tcl.
WARNING: [BD 41-2925] The design that will be created by this Tcl script contains the following module references: ecg_io_top.
Please add the sources of those modules before sourcing this Tcl script or use write_project_tcl.
INFO: [BD 5-148] Tcl file written out <D:/ecg_fpga/build/submission_cleancheck_v2/build/clean_system_generated.tcl>.

CLEAN_BD_VALIDATION_PASS: reused exported IP; not a full HLS/bit rebuild
INFO: [Common 17-206] Exiting Vivado at Wed Nov  4 16:06:04 2026...
