rentommy/2026-fpga-dual-channel-ecg/archive/original_code/model_training/item_d83a071a9a27/benchmark_03/item_1c06e8ed5c4b.md

# MIT-BIH 同导联逐拍基准结果

本轮只使用 MLII，保留九类原始标签；B 无样本，S 仅两拍且来源不足，无法独立验证九类。

**当前结论：可信基准与失败定位已完成，可用九分类尚未完成。** 三种子集成测试 macro-F1 为 0.3423；L 召回率为 0，R 约 0.10%。V 召回率虽为 90.13%，精确率仅 49.46%，误报仍多。不能将本轮报告为改进成功，也不能与不同数据库、不同划分的上一轮分数直接比较。

验证集上固定真实时宽没有优于周期缩放。选定模型训练 L/R 召回率接近 100%，验证却分别只有 0.05%/12.16%，说明跨受试者泛化严重不足。下一步优先审核训练/验证错误形态及独立来源覆盖，再开展有限的抗过拟合对照；具体路线见文末链接。

| 预处理与模型 | 验证 macro-F1 |
|---|---:|
| physical_cnn | 0.3475 |
| physical_rr | 0.3738 |
| warped_cnn | 0.3463 |
| warped_rr | 0.4284 |
| 线性 SVM：形态＋RR | 0.3366 |
| RBF-SVM：形态＋RR | 0.2443 |

线性 SVM 达到迭代上限，未确认收敛；其成绩仅为未收敛参考，不能据此认定线性 SVM 方法本身无效。

仅依据验证集选中的神经配置：warped_rr。三个种子的测试 macro-F1：[0.34467532020599745, 0.3046968161121081, 0.32764281920044713]，均值 0.3257，标准差 0.0164。

| 最终模型 | 测试准确率 | 有支持类别 macro-F1 |
|---|---:|---:|
| 线性 SVM | 63.87% | 0.2661 |
| RBF-SVM | 67.97% | 0.2853 |
| 三种子神经模型概率平均 | 75.52% | 0.3423 |

| 类别 | 测试拍数 | 独立来源组数 | 精确率 | 召回率 | F1 |
|---|---:|---:|---:|---:|---:|
| A | 180 | 4 | 0.1809 | 0.2944 | 0.2241 |
| B | 0 | 0 | 无法估计 | 无法估计 | 无法估计 |
| F | 14 | 2 | 0.0015 | 0.1429 | 0.0029 |
| L | 1452 | 1 | 0.0000 | 0.0000 | 0.0000 |
| N | 16082 | 8 | 0.8810 | 0.9031 | 0.8919 |
| R | 1906 | 2 | 0.0206 | 0.0010 | 0.0020 |
| S | 0 | 0 | 无法估计 | 无法估计 | 无法估计 |
| V | 1672 | 4 | 0.4946 | 0.9013 | 0.6387 |
| \| | 15 | 6 | 0.4828 | 0.9333 | 0.6364 |

全猜 N 的准确率参考：75.43%。不能只看准确率。

## 结论的范围

这是同导联、专家候选定位、离线零相位滤波条件下的研究基准，不包含自动检测与硬件误差。
本数据库曾用于前几轮实验，本轮测试未用于配置选择，但不是从未接触过的外部验证。
物理时宽与缩放输入还存在有效范围和 mask 形状差异，结果不能单独证明 QRS 时宽是唯一因果。
三种子只衡量训练随机性，不能代替多个受试者划分或外部数据库验证。B/S 数据覆盖仍需补充。
本轮没有把九类偷偷合并成粗分类，也不把缺少样本的类别计作通过。

数据、记录划分、预处理参数、原始文件校验值、源码快照、配置、逐拍预测和各记录成绩均已保存。

进一步阅读：[验证失败定位](验证失败定位.md)、[现有资料标签覆盖](现有资料标签覆盖.md)、[后续执行路线](后续执行路线.md)。
