rentommy/2026-fpga-dual-channel-ecg/archive/original_code/model_training/item_d83a071a9a27/benchmark_03/item_38891cfadb6a.md

# 验证集失败定位

以下定位仅用训练/验证，未据此重选模型。训练分数来自验证集选定的 seed0 最佳权重。

| 原始标签 | 训练召回率 | 验证召回率 | 验证最常误判为 | 该误判拍数 |
|---|---:|---:|---|---:|
| A | 99.88% | 22.70% | N | 1047 |
| B | 无样本 | 无样本 | 无 | 0 |
| F | 94.00% | 4.76% | V | 15 |
| L | 99.96% | 0.05% | N | 2057 |
| N | 99.59% | 96.48% | A | 236 |
| R | 100.00% | 12.16% | N | 1691 |
| S | 50.00% | 无样本 | 无 | 0 |
| V | 99.03% | 92.55% | N | 68 |
| \| | 100.00% | 76.67% | V | 5 |

逐记录结果见 `validation_record_diagnostics.csv`。训练/验证落差提示泛化不足，但不能仅凭落差判定是哪一种生理或设备因素造成。
L 在训练中仅来自两个受试者组、验证中仅一个；R 在训练中仅两个受试者组。大量相似心拍不能替代独立受试者覆盖。
B 在本库没有训练样本；原始 S 只有同一记录的两拍。保持九个输出节点不等于已经能训练和验证九类。
