rentommy/2026-fpga-dual-channel-ecg/archive/original_code/model_training/item_d83a071a9a27/experiment_07/item_1c06e8ed5c4b.md

# 第七轮：真实时间轴、新结构与新增患者

七输出仍为A/F/L/N/R/V/伪迹。S没有改为A，B没有改为R。SVDB未用于训练。

## 同口径开发对照（seed0，含后续追加标准化对照）

| 模型 | MIT验证准确率 | MIT验证macro-F1 |
|---|---:|---:|
| baseline_mit_seed0 | 68.55% | 0.3953 |
| baseline_mixed_seed0 | 69.82% | 0.4189 |
| baseline_z_mit_seed0 | 71.84% | 0.4230 |
| baseline_z_mixed_seed0 | 71.19% | 0.3940 |
| multi_mit_seed0 | 71.34% | 0.4265 |
| multi_mixed_seed0 | 71.95% | 0.4430 |
| multi_z_mit_seed0 | 73.55% | 0.4519 |
| multi_z_mixed_seed0 | 73.65% | 0.4587 |
| template_mit_seed0 | 65.22% | 0.4070 |
| template_mixed_seed0 | 66.01% | 0.4267 |

## 上一轮结果供整体方案比较

| 方案 | MIT验证准确率三种子均值 | macro-F1三种子均值 |
|---|---:|---:|
| study_05/baseline | 74.02% | 0.4360 |
| study_05/balanced_all | 70.89% | 0.4410 |

这些是相同MIT开发患者上的整体方案比较；输入表示等多项因素不同，不作单因素归因。

按预定MIT验证macro-F1选出的候选为 **multi_z_mixed**。不是根据外部测试挑选。

## 三种子复核及外部评估

| 模型 | 数据集 | 准确率均值±种子标准差 | 七类macro-F1均值 | 有样本类别macro-F1均值 |
|---|---|---:|---:|---:|
| baseline_mit | mit/val | 69.32% ± 1.07% | 0.3896 | 0.3896 |
| baseline_mit | incart/val | 82.46% ± 5.05% | 0.2168 | 0.3794 |
| baseline_mit | incart/test | 73.48% ± 1.83% | 0.2551 | 0.3571 |
| baseline_mit | svdb/external | 64.93% ± 5.84% | 0.2815 | 0.4926 |
| baseline_z_mit | mit/val | 71.89% ± 1.35% | 0.4170 | 0.4170 |
| baseline_z_mit | incart/val | 85.10% ± 4.41% | 0.2180 | 0.3815 |
| baseline_z_mit | incart/test | 80.25% ± 2.90% | 0.2894 | 0.4052 |
| baseline_z_mit | svdb/external | 71.09% ± 2.92% | 0.3078 | 0.5386 |
| multi_z_mixed | mit/val | 72.60% ± 0.76% | 0.4427 | 0.4427 |
| multi_z_mixed | incart/val | 89.23% ± 6.43% | 0.2867 | 0.5016 |
| multi_z_mixed | incart/test | 87.79% ± 1.95% | 0.3871 | 0.5420 |
| multi_z_mixed | svdb/external | 79.91% ± 6.54% | 0.3442 | 0.6024 |

## 多数类基线与实际覆盖

| 集合 | 保留样本数 | 全猜N准确率 | 存在的目标类别 |
|---|---:|---:|---|
| mit/val | 20432 | 66.57% | A,F,L,N,R,V,伪迹 |
| incart/val | 33330 | 94.00% | A,F,N,V |
| incart/test | 37708 | 77.03% | A,F,N,R,V |
| svdb/external | 174354 | 93.03% | F,N,V,伪迹 |

标准差反映训练随机性，不是患者总体置信区间。外部集合不存在的类别不能据其分数声称已验证；七类macro-F1会将无支持类别计零，另列有支持类别均值便于解释。

## MIT验证逐类表现（三种子平均）

| 模型 | 类别 | 精确率 | 召回率 | F1 |
|---|---|---:|---:|---:|
| baseline_mit | A | 74.74% | 18.34% | 0.2935 |
| baseline_mit | F | 0.70% | 12.70% | 0.0131 |
| baseline_mit | L | 0.00% | 0.00% | 0.0000 |
| baseline_mit | N | 70.72% | 94.70% | 0.8096 |
| baseline_mit | R | 22.22% | 0.35% | 0.0068 |
| baseline_mit | V | 80.83% | 78.87% | 0.7982 |
| baseline_mit | \| | 79.93% | 83.33% | 0.8061 |
| baseline_z_mit | A | 55.81% | 21.25% | 0.2971 |
| baseline_z_mit | F | 1.30% | 15.87% | 0.0240 |
| baseline_z_mit | L | 3.88% | 0.38% | 0.0069 |
| baseline_z_mit | N | 72.92% | 97.26% | 0.8333 |
| baseline_z_mit | R | 54.63% | 6.86% | 0.1123 |
| baseline_z_mit | V | 83.13% | 78.84% | 0.8086 |
| baseline_z_mit | \| | 83.15% | 84.44% | 0.8370 |
| multi_z_mixed | A | 74.16% | 33.53% | 0.4610 |
| multi_z_mixed | F | 2.08% | 11.11% | 0.0347 |
| multi_z_mixed | L | 3.54% | 0.31% | 0.0056 |
| multi_z_mixed | N | 73.89% | 97.58% | 0.8408 |
| multi_z_mixed | R | 12.81% | 0.87% | 0.0119 |
| multi_z_mixed | V | 92.28% | 81.67% | 0.8633 |
| multi_z_mixed | \| | 98.77% | 80.00% | 0.8816 |

## 数据与限制

- MIT保持原患者分组，201/202同组，旧MIT测试未评估。INCART按患者冻结20训练/6验证/6测试；SVDB整体外部评估，但其唯一患者身份未知。
- 只对七类内且切分有效的目标评估。SVDB中大量S等非目标心拍被排除；外部准确率不代表全部心拍识别能力。具体排除及覆盖见data/manifest.json。
- 数据输入：256Hz、205点、中心77，0.5–40Hz滤波、抗混叠重采样、中点约束、补零掩码；普通配置采用训练集全局幅值尺度，带_z_配置采用有效点逐拍均值/标准差。没有逐拍时间拉伸。
- 标准化对照是观察第一阶段开发结果后的追加研究，不是最初预注册的六组；选型始终只使用MIT开发验证，结果存在反复使用开发集的乐观偏差。
- 真心拍RR序列排除伪迹。伪迹候选使用到左右真心拍的距离作为上下文，不作为真RR插入序列，也没有用目标标签直接生成零向量作为类别提示。
- 当前依赖专家心拍位置，使用未来间期和零相位滤波；未验证实时检测或FPGA部署。INCART尚未做局部重新对齐。
- 改变了输入、采样率和幅值表示，因此与study_05的跨轮差值不是单独修复RR的因果收益；本轮内部同数据结构对照才可比较。
- 混合训练每轮样本更多，优化步数也更多；这是完整训练方案的比较，并非严格固定计算量的数据增益实验。
- 模板网络是受论文启发的可训练局部模板实现，不是论文原版复现；模板只从训练患者提取，索引保存在配置中。
- 所有真实原始文件不变，旧实验不覆盖。新权重未自动替换部署权重。

总体准确率80%为目标；应同时检查逐类召回、精确率和患者结果，不能靠多数类达标认定任务已完成。
