rentommy/2026-fpga-dual-channel-ecg/archive/original_code/model_training/item_d83a071a9a27/experiment_09/item_1c06e8ed5c4b.md

# 六库完整接入对照结果

使用0.5–40Hz双向带通＋50Hz Q30双向陷波、256Hz真实时间轴单拍、逐拍标准化、多尺度残差＋RR。恢复原始S，共八输出A/F/L/N/R/S/V/伪迹，S不改成A。
对照为相同八输出网络、训练设置和固定选型验证子集的两库训练与六库训练；不是将七输出旧权重与八输出新权重直接比较。

## 数据覆盖

| 库 | 有人工参考标注的记录 | 训练记录 | 验证记录 | 测试记录 | 保留目标心拍数 |
|---|---:|---:|---:|---:|---:|
| mit | 48 | 29 | 9 | 10 | 100,911 |
| edb | 90 | 55 | 19 | 16 | 790,445 |
| stdb | 28 | 28 | 0 | 0 | 76,119 |
| sddb | 12 | 8 | 2 | 2 | 785,015 |
| incart | 75 | 44 | 15 | 16 | 175,619 |
| svdb | 78 | 78 | 0 | 0 | 186,538 |

## 完整自然分布结果（三种子均值±标准差）

| 训练方案 | 集合 | 准确率 | 八类macro-F1 | 全猜N准确率 |
|---|---|---:|---:|---:|
| two_db | all/val | 91.79% ± 1.14% | 0.3260 ± 0.0048 | 96.01% |
| two_db | mit/val | 71.27% ± 1.40% | 0.3585 ± 0.0133 | 66.57% |
| two_db | edb/val | 89.38% ± 2.37% | 0.2838 ± 0.0097 | 98.54% |
| two_db | sddb/val | 98.82% ± 0.06% | 0.2879 ± 0.0031 | 98.61% |
| two_db | incart/val | 95.44% ± 2.68% | 0.2569 ± 0.0108 | 94.00% |
| two_db | all/test | 88.87% ± 1.93% | 0.3759 ± 0.0035 | 93.91% |
| two_db | mit/test | 75.40% ± 4.81% | 0.3776 ± 0.0019 | 75.40% |
| two_db | edb/test | 93.78% ± 1.21% | 0.2158 ± 0.0384 | 99.44% |
| two_db | sddb/test | 87.08% ± 4.63% | 0.3322 ± 0.0137 | 94.98% |
| two_db | incart/test | 86.30% ± 1.12% | 0.2884 ± 0.0144 | 77.02% |
| six_db | all/val | 96.42% ± 0.49% | 0.4029 ± 0.0164 | 96.01% |
| six_db | mit/val | 70.72% ± 0.66% | 0.3487 ± 0.0050 | 66.57% |
| six_db | edb/val | 98.12% ± 0.81% | 0.3723 ± 0.0222 | 98.54% |
| six_db | sddb/val | 98.82% ± 0.07% | 0.3423 ± 0.0074 | 98.61% |
| six_db | incart/val | 96.85% ± 0.90% | 0.2481 ± 0.0011 | 94.00% |
| six_db | all/test | 97.08% ± 0.17% | 0.3956 ± 0.0085 | 93.91% |
| six_db | mit/test | 81.12% ± 0.87% | 0.3630 ± 0.0085 | 75.40% |
| six_db | edb/test | 99.20% ± 0.13% | 0.2656 ± 0.0129 | 99.44% |
| six_db | sddb/test | 99.18% ± 0.13% | 0.3602 ± 0.0029 | 94.98% |
| six_db | incart/test | 86.97% ± 0.49% | 0.2716 ± 0.0177 | 77.02% |

## MIT原七类可比范围

| 训练方案 | 集合 | 七类范围准确率 | 七类macro-F1 |
|---|---|---:|---:|
| two_db | MIT/val | 71.27% | 0.4097 |
| two_db | MIT/test | 75.40% | 0.4316 |
| six_db | MIT/val | 70.72% | 0.3985 |
| six_db | MIT/test | 81.12% | 0.4149 |

MIT原七类范围只排除真实S，预测为S的其他真类仍计为错误。与旧轮次比较时须同时考虑网络输出、选型规则和训练轮定义已改变。

## 六库方案逐类表现（三种子平均）

| 集合 | 类别 | 精确率 | 召回率 | F1 | 样本数 |
|---|---|---:|---:|---:|---:|
| mit/val | A | 94.59% | 2.29% | 0.0448 | 1498 |
| mit/val | F | 7.24% | 14.29% | 0.0926 | 21 |
| mit/val | L | 0.00% | 0.00% | 0.0000 | 2121 |
| mit/val | N | 72.10% | 97.64% | 0.8295 | 13602 |
| mit/val | R | 0.00% | 0.00% | 0.0000 | 1925 |
| mit/val | S | — | — | — | 0 |
| mit/val | V | 85.37% | 89.28% | 0.8695 | 1235 |
| mit/val | \| | 93.21% | 97.78% | 0.9530 | 30 |
| all/test | A | 45.63% | 16.28% | 0.2387 | 305 |
| all/test | F | 6.63% | 10.10% | 0.0795 | 165 |
| all/test | L | 0.00% | 0.00% | 0.0000 | 1457 |
| all/test | N | 98.02% | 99.25% | 0.9863 | 376397 |
| all/test | R | 39.68% | 0.05% | 0.0009 | 5070 |
| all/test | S | 1.86% | 41.58% | 0.0356 | 93 |
| all/test | V | 85.38% | 82.00% | 0.8353 | 10585 |
| all/test | \| | 97.88% | 99.75% | 0.9880 | 6754 |

## 解释与限制

- “完整”表示六库所有具备参考atr标注且可解析的记录均审核接入；每记录取一个明确记录的导联，缺首选导联时取第一导联，未只保留MLII/MLIII记录。
- 猝死库有11条记录缺少人工参考atr（33,37,38,39,40,42,43,44,47,48,50），未把未审核ari自动标注当作监督真值。
- B的54,725个原始标注集中在猝死库36号记录，另两库各仅1个B，仍不具备有意义的独立来源覆盖；本轮不训练B，也不将其改成L/R。
- EDB按官方同患者关系合并分组，INCART沿用官方患者分组，MIT201/202同组；STDB与SVDB无法确认跨记录身份，均整库只用于训练，不报告这些库的独立测试。未知跨库身份和部分波形重叠仍未完全认证，不能声称绝对无患者泄漏。
- SVDB此前作为外部库的身份已经改变，本轮纳入训练，不再称其为外部测试。已使用过的旧MIT/INCART测试也不包装成全新外部证据。
- 为控制长Holter多数类的计算量，每轮180,000次训练抽取，按完整随机排列顺序循环；早停必须等所有纳入训练的心拍至少遍历一次，不删减长记录中的正常心拍。两方案每轮更新次数相同，最多24轮。
- 模型按固定多库验证子集的八类macro-F1选取；该子集每库每类最多2000拍，只用于选型，上面的最终验证和测试表均使用完整自然分布。标准差是种子波动，不是患者总体置信区间。
- 单库若没有某类别的真样本，逐类表显示横线；八类macro-F1仍将缺失类别计零，因此不直接比较不同库的绝对难度。合并测试的八类都有真样本，MIT原七类另有可比范围。
- A和S保留各库原始符号，两者临床定义范围不同，跨库标注习惯可能影响可分性；没有通过改标签制造提升。
- 使用专家定位、未来RR和双向滤波，尚未完成自动检测与实时FPGA验证。总体80%不替代逐类召回与精确率要求。
- 另发现1107个目标的相邻标注间隔超过10秒，可能涉及长停搏、复杂节律或标注覆盖间断，当前按原始标注保留；时间特征标准化后截断到±8。它们是候选标注间隔，不能全部宣称已经验证为临床RR，详见rr_quality_note.json。
- 参考：[EDB官方同患者说明](https://physionet.org/content/edb/1.0.0/)、[猝死库参考标注限制](https://physionet.org/content/sddb/1.0.0/)。
- 审计见audit.json，重载权重复现检查见checkpoint_audit.json，逐患者结果见per_patient.csv。
