rentommy/2026-fpga-dual-channel-ecg/archive/original_code/model_training/item_d83a071a9a27/experiment_09/item_53df557de903.md

# 六库实际数据覆盖

所有数字为当前滤波、边界检查及标签筛选后的数据。记录数与患者数不能混用。

| 库 | 划分 | 记录数 | 分组数 | A | F | L | N | R | S | V | 伪迹 |
|---|---|---:|---:|---:|---:|---:|---:|---:|---:|---:|---:|
| mit | train | 29 | 29 | 866 | 767 | 4491 | 45300 | 3416 | 2 | 4221 | 87 |
| mit | val | 9 | 9 | 1498 | 21 | 2121 | 13602 | 1925 | 0 | 1235 | 30 |
| mit | test | 10 | 9 | 180 | 14 | 1457 | 16082 | 1909 | 0 | 1672 | 15 |
| edb | train | 55 | 47 | 0 | 255 | 0 | 475629 | 0 | 394 | 2066 | 70 |
| edb | val | 19 | 16 | 0 | 84 | 0 | 160679 | 0 | 668 | 1621 | 3 |
| edb | test | 16 | 16 | 0 | 15 | 0 | 148145 | 0 | 31 | 780 | 5 |
| stdb | train | 28 | 28 | 0 | 0 | 0 | 74982 | 0 | 815 | 322 | 0 |
| sddb | train | 8 | 8 | 0 | 222 | 0 | 465678 | 0 | 290 | 19627 | 8261 |
| sddb | val | 2 | 2 | 0 | 4 | 0 | 96766 | 0 | 38 | 1156 | 167 |
| sddb | test | 2 | 2 | 0 | 83 | 0 | 183123 | 0 | 55 | 2811 | 6734 |
| incart | train | 44 | 20 | 1767 | 137 | 0 | 89896 | 8 | 9 | 12757 | 0 |
| incart | val | 15 | 6 | 50 | 29 | 0 | 31330 | 0 | 0 | 1921 | 0 |
| incart | test | 16 | 6 | 125 | 53 | 0 | 29047 | 3161 | 7 | 5322 | 0 |
| svdb | train | 78 | 78 | 0 | 23 | 0 | 162193 | 0 | 12184 | 9936 | 2202 |

STDB和SVDB的分组数只表示记录代理，唯一患者身份未确认，因此两库整体仅用于训练。EDB采用官方79位患者关系，INCART采用官方32位患者映射，MIT201/202同组。
SDDB仅接入12条带人工审核atr记录，11条缺少人工参考标注的记录保留原样但不作监督训练。B仍排除，原始B没有改成L/R。
“完整接入”不意味着把测试患者也用于训练；每个可监督记录均归入训练、验证或测试之一。所有训练目标都会在候选权重保存前遍历至少一次。
