rentommy/2026-fpga-dual-channel-ecg/report/history/acquisition_power_review_2026-10-25.md

# 新采集板电源与接口检查

> 历史第一版检查。用户已合并GND2/GND并新增H1隔开测试供电，最新两项主要问题均已修正，见[第二版复查](acquisition_power_review_2026-10-25_v2.md)。下文保留旧网表当时的发现，不代表当前仍有同样接线错误。

日期：2026-10-25。依据本次最新的 `采集板/ADS1292_2026-10-23.txt`、同目录 `bq25882.pdf`、`tps62163.pdf`，对照现有STM32固件及PYNQ专用隔离板。文件名虽含10-23，实际内容已在10-25更新；文件哈希和逐引脚核对保存在同名JSON。

**结论：尚不能直接投板／通电验收。发现一处明确的供电回流错误；CN1测试供电还需断开措施，充电使能／固件及器件规格也需补齐。** 两颗新芯片本身的型号搭配与主要引脚连接大体正确，无需因为本次发现就更换方案。

用户确认：CN7连接2串、标称7.4V、1200mAh且带保护板的电池；CN1仅用于测试后级。尚未提供电池允许充电电流、精确满充规格及保护板均衡能力，不据容量自行批准某一充电电流。

## 1. 必须修改：GND2与GND没有供电回流连接

当前网络：

| 网络 | 主要节点 |
|---|---|
| GND2 | 电池负极CN7.1、BQ25882 U4.A3/B3、TPS62163 U9.1/4/5/9、新USB2地、C43～C51相应地端 |
| GND | ADC AVSS/DGND、STM32 VSS、两颗3.3V LDO U6.2/U7.2、旧CN1.2及模拟／数字去耦地 |
| +5V | TPS62163经L3输出、U9.6/VOS、CN1.1、两颗LDO输入和使能及输出C51 |

正电源相连，负电源却分成两个不相连的网络。TPS62163是非隔离降压器，不能把负载地留浮空；BQ25882控制信号还通过SCL/SDA/CE/INT连接参考另一地的STM32。电源和逻辑接口均缺少明确共同参考，不能依赖GPIO保护通路形成意外回流。

**按当前非隔离电源方案，应把GND2与GND合并为采集侧同一地网。** PCB可以通过布局区分开关大电流回路和敏感模拟地回流，但不能让系统负载地在原理图中完全断开。

不要因此把旧USB1侧的GND1、PYNQ侧隔离地也合并进来。三个名称在本次网表中的意义不同：GND/GND2应属于同一采集侧供电系统；GND1是旧USB串口外侧地。TPS62163的AGND、PGND及EP连接正确地到GND2，但它们还需与所供负载的GND建立回流。

## 2. CN1可以保留测试用途，但不能直接并联供电

CN1.1与TPS62163输出均直接接+5V。用户说明只在后级测试时使用，因此不是要求取消CN1，而是需要一个明确、可执行的外供测试断开点。

外部5V接CN1时，应断开U9降压输出支路与后级+5V之间的连接，避免反向给降压器或其他电源通路送电；不能只以“没有插USB2”代替输出隔离。可在降压输出与后级之间预留0Ω／跳帽或选择开关。断开点应使U9自身的L3、输出电容、VOS反馈保持完整本地回路，不能拆坏控制环路。若要允许两路同时连接，则需另设计有依据的电源选择／防回灌电路，本次不要求增加这种模式。

CN1还应有清晰5V测试口及极性标识，不得再当作可输入7.4/8.4V电池的接口。

## 3. BQ25882：25个球位逐一核对

按用户提供手册正文第4～5页Figure/Pin Functions、68页图75：

| 功能 | 本次连接 | 结果 |
|---|---|---|
| VBUS A1/B1 | USB2 VBUS的5V网，C46=1µF到GND2 | 对应正确 |
| PMID A2/B2 | L2.1与C47=10µF到GND2 | 对应正确 |
| SW A4/A5 | L2.2与C48.1 | 对应正确 |
| BTST D5 | C48.2，47nF跨SW／BTST | 对应正确 |
| SYS B4/B5 | 8V网，C44/C45各22µF，供U9输入 | 对应正确 |
| BAT C4/C5 | BAT网、CN7.2、电容C43=10µF | 对应正确 |
| BATP E5、BATN E4 | 分别BAT和GND2 | 网络正确；PCB需Kelvin采样 |
| REGN D4 | C49=4.7µF及TS上拉分压 | 对应正确 |
| D+ C1、D− D1 | USB2 A6/B6、A7/B7 | 对应正确；未误接旧USB1 |
| SCL D2、SDA E2 | PB6、PB7，R34/R36各10k上拉3.3V1 | 脚位正确；须先修共地 |
| CE E1 | STM32 PB10及R35=10k上拉3.3V1 | 充电默认禁止，需主动拉低 |
| INT C3 | STM32 PB11及10k上拉 | 对应正确；须先修共地 |
| PG C2 | LED5及R33=10k到3.3V1 | 作为低有效电源有效指示的接法合理，LED极性仍需核对符号 |
| ILIM D3 | R32=1.1k到GND2 | 约1A USB输入上限，不是电池充电电流 |
| TS E3 | R43=5.23k到REGN，R42=30.1k及R41=103AT-2到GND2 | 与典型拓扑一致 |

网名8V代表SYS节点，不是精确固定8.000V；SYS随电池、供电与SYS_MIN设置变化。新地网问题修正后，上述主电路连法没有发现引脚级错误。

### 充电不会因为芯片焊上就自动按所需参数运行

CE为低有效，且还要求EN_CHG=1。当前R35将CE上拉，因此STM32正常供电且未驱动PB10时，充电被禁止。这种上电默认状态可以保留，但必须实现明确的使能步骤，不能误判为充电芯片损坏。

提供的STM32 `Core/Src/main.c` 未包含BQ25882驱动／I2C初始化，HAL配置中I2C模块也仍未启用。因此现有固件没有把新充电器配置好。BQ25882可以运行默认模式，不是必须通过I2C才能充电；但本设计的CE默认高需要处理，且电池参数必须核对。

手册正文37～38页给出默认VREG=8.40V、ICHG=1000mA。普通满充4.2V/节的2S电池通常对应8.4V，但仍应依据电池厂家规格，不把标称7.4V误作充电截止电压。1000mA对1200mAh为约0.83C，不能仅凭容量判定电池允许该电流。带保护板也不能替代正常充电电流、电压和温度管理。

R32按KILIM典型1085A·Ω计算：1085/1100≈0.986A输入上限，KILIM范围对应约0.909～1.064A；实际还受USB识别、IINDPM等限制。输出电池充电电流会受升压功率、系统负载及效率影响，并非固定0.986A。

TS分压在NTC=10k时约为0.5894×REGN，与典型网络相近。R41应真实感知电池温度，而非仅测充电芯片附近空气；热耦合与传感器装配不在网表内。BQ25882本身不提供电芯均衡；用户称有保护板，但尚未确认是否含均衡。

一旦I2C写入进入host mode，还需处理看门狗复位／禁用策略，否则超时后部分参数回到默认值。此项属于后续固件，不要求本次擅自改动旧ADC程序。

## 4. TPS62163：引脚及外围核对

按手册正文第4页：U9.1=PGND、2=VIN、3=EN、4=AGND、5=FB、6=VOS、7=SW、8=PG；热焊盘在用户网表为9。

- 2/3脚接SYS/8V，1/4/9脚接GND2，7脚经L3=2.2µH到+5V，6脚感测+5V，均正确。
- **TPS62163是固定5V版本，5脚FB接AGND是手册建议，不需要再添加可调版反馈电阻。** 若实际采购为TPS62160，则该接法不适用，BOM应补完整料号。
- C50=10µF为VIN去耦，C51=22µF为本地输出电容，L3=2.2µH与22µF属于手册推荐LC组合；还要核对实际有效容量、饱和电流和布局。
- PG为开漏，R38=100k上拉+5V，同时通过LED6到GND2。若LED6.2为阳极、1为阴极，输出良好时由上拉供电、故障时PG拉低熄灭；此逻辑不应误判为接反。但电流约为几十µA，亮度可能偏弱，需按实际LED参数和目标亮度选择限流／上拉方式。网表不能确认该具体LED符号极性。

## 5. 还需要BOM／PCB确认的项目

- U4为0.4mm间距25球DSBGA，必须按顶视球位与实际封装核对，避免把底视图镜像；U9为WSON8并含散热焊盘。网表没有几何信息。
- L2只标1µH及2012封装，L3只标2.2µH及1008封装，未给具体料号、Isat、Irms、DCR。尤其充电升压电感必须按输入平均电流加半纹波、限流和偏差核对，不能仅凭1µH数值认定可用。
- C44/C45标称22µF、C43/C47/C50等标称10µF，但都用0603，缺少额定电压和DC偏压曲线。SYS接近电池电压时有效容量可能显著下降；需按手册SYS建议、电容实际料号及工作偏压核对。SYS使用16V或更高额定是手册的建议，额定电压本身也不等于有效容量达标。
- SYS、PMID、SW、BTST的高频回路、电源输入去耦位置、BATP/BATN Kelvin走线、AGND/PGND及EP布局都需PCB图检查。
- USB2现直接连接充电器／电池地。修正GND2/GND后，USB2也直接连接采集侧；数字SPI隔离板不隔离这条新增充电路径。接人体采集时不能同时连接USB2充电／调试供电，需保持电池独立使用。原USB1与PYNQ的隔离连接不能作为USB2已隔离的依据。
- ADS1292数字接口、CLKSEL接高、原有3.3V LDO及PYNQ专用隔离板信号分配未发现本次改变引入的新针号错误；但整机新供电在地网修正前不能沿用旧数字接口通过记录宣称整板已通过。

## 6. 建议执行顺序

1. 合并本电源系统的GND2与GND，保留真正外侧地的隔离。
2. 给CN1后级外供测试明确设置断开降压输出的连接点。
3. 补齐U4/U9、L2/L3及关键电容完整料号，确认电池充电规格和保护板功能。
4. 在无电池情况下先检查电源连接与短路；采用合适受限电源、明确只启用一路供电，逐级确认新电源输出、3.3V与CE状态。
5. 完成BQ25882状态读取及参数配置后，再验证受控充电、ADC内部测试和真实信号。整个过程不接人体电极。

本次仅检查并记录问题，未改原始网表、未修改固件、未运行板卡、未连接电池或执行充电。
