rentommy/2026-fpga-dual-channel-ecg/report/history/acquisition_power_review_2026-10-25_v2.md

# 新采集板电源第二版复查

日期：2026-10-25。依据本次重新读取的采集板网表；文件哈希、逐引脚复核及检查状态见同名JSON。

**上轮两项主要连接问题已修正：主要电源及新增芯片引脚的静态连接检查通过，可进入BOM／PCB检查阶段。此结论不等于已经完成实物上电或充电验收。**

## 已修正

1. GND2已并入采集侧GND。电池负极、BQ25882、TPS62163、ADC、STM32和两颗3.3V LDO具备明确共同回流。原USB1外侧GND1仍单独保留，没有误合并。
2. 新增H1将降压器本地输出与后级／CN1测试电源分开。H1.2与L3.2、C51.1、U9.6/VOS及R38.1在同一本地输出网络；H1.1接后级+5V和CN1.1。因此断开H1不会拆掉降压器本地输出电容和反馈回路，改法正确。
3. BQ25882的25个球位、TPS62163含EP的9个焊盘重新核对，除上述预期地网和输出分网变更外保持正确；未发现本次新增引脚错误。

## H1使用方法

| 使用方式 | H1 | CN1 |
|---|---|---|
| 电池／充电器经U9给整板正常供电 | 短接 | 不接外部电源 |
| 外部5V只测试后级 | 断开 | 接5V，注意极性 |

不要在H1短接时再给CN1外加5V。H1是人工选择，并非自动防回灌。测试时先断电选择连接方式，再接电源。

## 未改变的待办

- CE仍被R35拉高，默认禁止充电；后续须由控制逻辑明确使能并按电池规格设置充电参数，现有ADC固件尚无BQ25882管理。
- 电池允许充电电流与保护板均衡能力未提供；不能把R32设定的USB输入上限误当电池充电电流。
- L2/L3的Isat/Irms/DCR，关键电容耐压及DC偏压后有效容量，需要具体料号才能核定。
- BGA／WSON封装、Pmod和换面U6真实针号对应、开关电源回路、Kelvin采样和隔离边界需PCB图／实物核对。
- USB2直接属于采集侧充电路径，人体采集时不同时连接USB2或外部测试电源。

上述事项不意味着本次地线／H1需要再改，也不要求增加STM32兼容模式。原始文件未改写，未通电、未充电、未修改固件。
