rentommy/2026-fpga-dual-channel-ecg/report/history/dual_view_2026-11-04.md

# SW0 双路径 HDMI 显示

已构建并部署至 `/home/xilinx/jupyter_notebooks/ecg_dual_view_20261104`，服务保留真实 ADC 输入、启动通道2。旧目录及服务备份保留。SW0=0 单路，启动默认实时；SW0=1 上实时、下保真，BTN0/BTN1 同时选择两栏通道、BTN3 同时冻结，BTN2 在双路时不改变固定的两条路径。

两栏使用相同增益和4秒窗口，保留原始滤波时间差。30ms/348ms 是既有滤波核的脉冲峰值偏移，不代表端到端显示或识别延迟。逐拍标签分别使用原有路径补偿。复用四组波形与标签缓存、原帧缓冲提交，不增加 ARM 波形写入量。

SW0 使用 M20，通过双级同步及约20ms消抖；在垂直消隐锁存显示模式。ECG6 ABI=0x45434736，寄存器0x40 bit0返回SW0稳定状态。新模块名ecg_io_dual，配套软件已更新。

验证通过：双路各自RAM选择和坐标映射、帧边界切换和恢复单路、原视频回归、SW0抖动拒绝及高低读回、原AXI/SPI/FIFO/无效帧/按键回归。入口`board/test_dual.ps1`，输出在`build/dual_sim`，仿真图`report/dual_view_sim.png`。

最终时序 WNS +0.016ns、WHS +0.002ns，失败端点0。LUT15735、FF20490、BRAM Tile60、DSP57。源报告`board/dual_view/overlay/`。构建脚本`board/build_dual_view.tcl`，使用独立模块引用以绕开Vivado旧端口缓存。

部署包`board/ecg_dual_view_20261104.zip`，SHA256 `89fda8cab99cc5960eae5127aa5194888978a042b03a5a79edd3b5bbbc4341b1`。

新版本已初始化ADC并实际显示实时数据，两个运行片段分别约29及29.9次画面更新/秒。现场仍出现DRDY中断和单个无效SPI帧，服务进入故障提示并重试。不能将这次运行描述为持续稳定采集通过。用户已两次检查恢复采集侧连接，旧版本在升级前亦反复报告ID=0xFF。

实际HDMI外观及用户拨动SW0的现场验收待用户确认；RTL仿真通过不等于现场验收。
