rentommy/2026-fpga-dual-channel-ecg/report/history/hdmi_chinese_2026-11-03.md

# HDMI 中文界面（2026-11-03）

用户要求暂停继续排查残余移动错位，先将显示文字改为中文。本次只调整文字字库、标签及内部测试源的标识，不继续重构波形绘制或视频时序。

## 界面映射

| 原标签 | 中文 |
|---|---|
| ECG / CH1 / CH2 | 心电波形 / 通道1 / 通道2 |
| DIAG / FAST | 保真 / 快速 |
| LIVE / HOLD | 实时 / 冻结 |
| AUTO | 自动增益 |
| DEMO WAVEFORM | 演示波形 |
| ADC WAVEFORM | 采集信号 |
| 新增内部测试标识 | 内部测试信号 |
| NO ADC DATA / CHECK CONNECTION | 无采集数据 / 请检查连接 |
| 500 SPS / 4 SEC | 500点每秒 / 4秒窗口 |
| BTN0 CH1 ... | 键0通道1 / 键1通道2 / 键2模式 / 键3冻结 |

## 实现及验证

`board/generate_chinese_font.py`使用本机黑体字体生成本界面所需52个16×16字模，静态存储在 `src/rtl/ecg_chinese_font.vh`，无需在板上安装中文字库；标签代码在 `ecg_chinese_labels.vh`。最多24个字符，占384像素，640像素横向布局可容纳。底部文字区扩展到460～475行，未侵入波形区域80～439行。

保留双缓冲、帧间切换及显示寄存器ABI 0x45434732。显示标签0x18=3用于区分芯片内部测试源，脚本在有效数据到达后设置该标签，避免将测试方波标为外部采集。

视频仿真通过两帧各307200像素检查、同步和CH2/FAST/HOLD选择，并检查只在垂直消隐起点切换缓存。实际RTL渲染PNG为 `board/scope/chinese_rtl_demo.png` 和 `chinese_rtl_channel2.png`，已人工查看，中文正常，无越界；这些是仿真图，不是采集卡画面。主机显示协议3项测试通过。

Vivado 2026.1 已完成构建：setup slack +0.074 ns，hold slack +0.021 ns，LUT 7203、FF 9679、DSP 1、BRAM 19.5 tiles；DRC 无错误或严重警告，CDC 报告无不安全端点。此前可用双缓冲固件和脚本已备份到 `board/scope_before_chinese_20261103/`。

## 板上部署

中文版本包为 `board/ecg_scope_chinese_20261103.zip`，728947字节，SHA256：`eb5224519bee0871efafac3db1a6ea13b1c1c3afd518469ba973cab63c670722`。已通过已登录的 Jupyter 上传，在独立目录 `ecg_scope_chinese_20261103` 解压，整包及清单中各文件哈希校验通过。

15秒板上内部测试通过：ADS1292 ID 0x53，寄存器 `02 A3 10 05 05 2C 00 00 02 07 0C`；每通道有效样本6888，预热丢弃543，overruns=0、bad_frames=0、error=null。目标30次/秒，实际29.9766次/秒，更新381次，绘制平均8.5846 ms、最大11.4488 ms。HDMI扫描仍为60 Hz，波形更新率与扫描率为不同指标。

测试结束后恢复同一中文版本的持续内部测试显示，显式使用 `--display-fps 30`。用户现场确认“中文清晰，切换正常”：中文完整可读，BTN0/BTN1通道切换、BTN2保真/快速切换、BTN3实时/冻结切换的文字变化正常。当前画面经过采集卡预览，并非显示器直连验证。残余移动错位按用户要求暂不继续排查。
