rentommy/2026-fpga-dual-channel-ecg/report/history/hdmi_doublebuffer_2026-11-03.md

# HDMI 横向撕裂修复：双缓冲（2026-11-03）

## 原因和实现

原25次/秒版本在PL扫描时写同一份波形缓存，可能在一帧内读到两次更新的数据。新版增加前后台缓存：PS完整写入后台2560列值，再提交请求；像素域经两级同步，在hx=0、vy=480的垂直消隐起点切换前台，并将确认编号经两级同步返回总线域。等待确认时PS跳过绘图，硬件拒绝缓存写入，防止待显示内容被覆盖。UI同样在帧边界锁存。ADC、滤波器、连线修复及25次/秒目标保持不变。

新寄存器ABI为0x45434732；0x1C读回bit0当前前台、bit1请求缓存、bit2待确认，写bit0提交。新版脚本拒绝旧比特流，避免误用。旧的工作比特流、HWH和脚本保存在 `board/scope_before_doublebuffer_20261103/`。板上旧部署目录未覆盖，新版独立位于 `ecg_scope_doublebuffer_20261103/`。

## 验证

- 视频RTL仿真通过：两帧各307200像素，检查同步、CH2/FAST/HOLD选择，断言缓存切换只能发生在垂直消隐起点。
- 采集接口RTL回归通过：解耦AXI、背压、SPI mode1、FIFO、符号扩展、溢出、坏帧、按键；新增提交待确认状态以及忙时写缓存拒绝检查。
- `sim/test_scope_display.py`三项通过：相邻列连线与两缓存交替提交、待确认/HOLD不改内存、旧ABI拒绝。
- Vivado 2026.1生成比特流；初次布线有时序告警，经导出脚本物理优化及重布线后，最终setup余量+0.001 ns、hold+0.023 ns，所有用户指定时序约束满足。未放宽核心时钟。
- 最终资源：6762 LUT、9676 FF、1 DSP、19.5 BRAM Tile。最终CDC报告7个跨域端点均Safe；DRC仍有DSP流水与BUFG布置相关Warning，无Error。外部异步输入/SPI电气时序边界仍沿用既有约束，未据此宣称全部板级时序获得认证。
- 完整上传包及每文件SHA256校验通过；板上运行15.001233秒，ADS1292 ID=0x53、寄存器回读通过，每通道6885点，317次缓存提交，平均24.979562次/秒，绘图平均8.397315 ms、最大10.963428 ms；坏帧0、溢出0、无异常。
- 硬件切换确认检查通过：`DOUBLEBUFFER_ABI_AND_SWAP_ACK_PASS 0x45434732 3`，当前前台与请求缓存编号均为1，pending=0。用户反馈明显改善，但移动时仍有多个较小的错位段，因此不能宣称实屏问题完全解决。

## 残余移动错位：继续定位

用户描述：“移动的时候有多个小段的错位，比之前的错位距离要短”。不能直接将此描述归因于帧率或显示器。双缓冲下此前持续约906.964秒，每通道452783点、22597次提交，平均24.9787次/秒，坏帧/溢出均0。

为排查25次/秒与60Hz的非整数刷新节奏，使用同一比特流和脚本、仅参数改为30，测试12.002139秒，每通道5388点、291次提交，平均29.971938次/秒，绘图平均8.566766 ms、最大12.528338 ms，无异常、坏帧或溢出。该参数测试不能证明画面错位已消除；PS并未与60Hz扫描相位锁定，30目标也不保证严格每隔两帧呈现。

当前运行 `--source adc-test --display-fps 30`，退出摘要将写至板上 `ecg_scope_doublebuffer_20261103/board/scope/live_fps30_summary.json`。等待用户反馈移动/冻结时的线条完整性、显示器型号和连接链路；若仍无法定位，需要实际短视频，而不继续凭描述改动像素逻辑。

用户随后明确连接链路中有采集卡。此前“实屏/显示器”反馈应理解为HDMI经采集卡后预览，尚未完成HDMI直连显示器对照。用户新图中可见陡峭边沿的若干短小水平阶梯；仅凭这张静态图不能确定是帧撕裂，也不能确定采集卡是根因。后续先确认冻结后是否仍有阶梯、采集软件及输入/预览帧率，再对照采集卡保存文件的逐帧图像；不据此继续盲目重构FPGA。

## 文件及状态

本地：`src/rtl/ecg_wave_video.sv`、`src/rtl/ecg_io_top.sv`、`board/run_scope.py`、`board/scope_hdmi.xdc`。

比特流SHA256：`8733dd523141cfda8b9a118e7902c84c949cbd177fc26814ebc03a727722a9dd`。

脚本SHA256：`801f59858cd054c6beaf129b930f2955fe57855b09caa7d9c55f05cb1d5a96ee`。

首次部署包 `board/ecg_scope_doublebuffer_20261103.zip`（696167字节）SHA256：`cdfdd8263fdb8de335c6e273f60f8bb961940198d8552f2f5502014bbfe06315`。首次包内指南保留了部分旧版描述；当前最新说明以本报告和工作区SCOPE_GUIDE为准，运行bit/script已经是双缓冲版本。

文档与实测清单整理后的发布包：`board/ecg_scope_doublebuffer_20261103_r2.zip`（696677字节），SHA256 `d8d0090cc6f961449b533b1f6dca4153704e59cc39539391c0cb14834b64c695`。bit和脚本与板上首次部署包相同；r2更新指南和构建清单，未再上传到板上覆盖首次存档。工作区 `board/scope/build_manifest.json` 已更新为双缓冲版本。

板上首次测试摘要：`ecg_scope_doublebuffer_20261103/board/scope/first_board_test.json`。持续显示退出后才写 `doublebuffer_live_summary.json`。
