rentommy/2026-fpga-dual-channel-ecg/report/history/hdmi_fps_2026-11-03.md

# 波形更新率提高（2026-11-03）

## 改动

`board/run_scope.py` 原先固定约100 ms更新一次波形缓存。新版本默认目标25次/秒，可用 `--display-fps` 指定1～60。使用单调时钟调度，加入实际缓存提交次数、提交间隔平均速率、绘图平均与最大耗时统计；HOLD不计为成功绘图。预热543点结束后才开始统计。

演示源从每50 ms生成25点改成每20 ms生成10点，仍为标称500 SPS，避免演示数据批次将更新率限制为20次/秒。ADC采集配置、滤波器系数、连续连线修复和比特流保持原样。

本地语法检查通过。板上先备份 `run_scope.before_fps_20261103.py`，替换前校验各处旧片段，编译语法通过后写入。板上和本地脚本SHA256一致：`5056ce06d9a89ac2d60d785825742a0026006516dcd102a330f969ef123fc6cf`。

## 实物验证

真实ADS1292内部测试模式，目标25次/秒，运行15.000624秒（含芯片初始化和预热）：

| 指标 | 实测 |
|---|---:|
| 每通道原始采样点 | 6885 |
| 波形缓存提交次数 | 318 |
| 首末提交时间计算的平均速率 | 25.0579 次/秒 |
| 单次绘图平均耗时 | 8.1685 ms |
| 单次绘图最大耗时 | 10.3141 ms |
| 采集溢出 / 坏帧 | 0 / 0 |
| 异常 | 无 |

合成演示模式另测8.000388秒，4000点、174次缓存提交，实测25.0713次/秒，平均绘图8.1127 ms、最大10.8358 ms，无异常。已恢复 `--source adc-test --display-fps 25` 持续运行，Notebook保存，退出时summary路径为 `ecg_scope_20261023/board/scope/adc_live_fps25_20261103.json`。

HDMI视频扫描仍为约60 Hz。本轮25.0579是PS端完整波形缓存写入的提交速率，不是显示器端光学测得的完整图像帧率；当前仍是单缓冲，未增加垂直同步或双缓冲，仍可能存在局部撕裂。提高更新率不等于消除所有显示卡顿，也不是改变ADC采样率。

既有20261023历史ZIP未改写，重新解压会覆盖当前脚本。运行采用板上的已更新文件。
