rentommy/2026-fpga-dual-channel-ecg/report/history/netlist_review_2026-10-23_v3.md

# 第三版隔离网表复查

> 最新结果：用户随后取消隔离板STM32支路和SW2，PYNQ专用网表连接检查通过，见[简化版复查](netlist_review_pynq_2026-10-23.md)。下文保留有SW2版本及插接条件澄清的历史记录。

> 采集板后续新增两颗LDO的EN开关，最新电源控制与残留信号支路检查见[LDO使能更新复查](netlist_review_power_2026-10-23.md)。仅关闭LDO不能视为断开STM32 GPIO。

> 用户补充后的结论：U6已换面安装，不再按同号直插解释。若实际对接为U6.2→H5.1、U6.4→H5.3等逐对奇偶交换，则采集侧九根连接（七信号＋电源＋地）均匹配，下文按同号直插得出的输出冲突结论不适用于该接法。最新复核见文末；封装实际几何仍需确认。

日期：2026-10-23。最新隔离网表SHA256为 `378ad4216c5ddc436e93e02d9a6741cb1968e894f08a4a454769cc30b99ee03f`。采集板仍按现有 `采集板/ADS1292_2026-10-23.txt` 核对。本次不要求兼容STM32隔离，按用户既定的PYNQ单独使用方案检查。

## 结论

电源与去耦保持正确，但U6各对奇偶脚整体交换。**若仍是此前确认的U6.n与H5.n同号直插，本版连接错误，不应通电。** 若实际替换过封装、焊盘编号或插接方式，必须以实际对接针号表复核；本次只有网表，无法凭空判断物理编号已改变。

## 已正确的部分

- U1/U2的1脚直接接3V3A，16脚直接接3V3D。
- 四个100nF正确跨接各自电源与地。
- ISO7763内部七根信号方向及Pmod U5网络未变；HOST GNDD也不再直接连接U6。

## U6对接列交换

根据现有采集板H5，同号直插时应为：

| 隔离板U6脚 | 对应采集板H5 | 应接隔离板网络 | 本版实际网络 |
|---:|---|---|---|
| 1 | GND | GNDA | GNDDSTM32 |
| 3 | ADC DRDY | DRDY | DRDYD |
| 5 | ADC SCLK | SCLK | SCLKD |
| 7 | ADC DIN | DIN | DIND |
| 9 | ADC DVDD/3.3VD | 3V3A | 3V3DSTM32 |
| 11 | ADC DOUT | DOUT | DOUTD |
| 13 | ADC CS | CS | CSD |
| 15 | ADC START | START | STARTD |
| 17 | ADC PWDN/RESET | PWDN/RESET | RESETD |

这里D后缀是隔离板HOST侧网络命名，不代表采集板数字端。此前版本的这些采集侧网络在奇数脚，本版改到了偶数脚，导致两列信号接反。

例如DRDY：ADS1292输出U1.22→H5.3→U6.3→隔离器U1.15/OUTA，输出接输出。DOUT同样是ADS1292 U1.21→H5.11→U6.11→隔离器U1.14/OUTB，输出接输出。其他SPI和控制信号则落到错误的一侧；这不是仅修改软件引脚即可解决。

## 新增SW2

网表没有开关完整型号及内部触点关系，只能给出条件结论：

- SW2.1接HOST的3V3D，SW2.2经3V3DSTM32、U6.9、H5.9接到采集侧3.3VD。若开关某档连通1—2，HOST3.3V与采集侧ADC电源直接并接。
- SW2.4接GNDA，SW2.5经GNDDSTM32、U6.1、H5.1也接采集板GND；GNDA本来已经通过U6.2/H5.2接同一个GND。因此4—5控制的两网插接后已经由采集板连通，并不是一个有效的两侧地选择。
- GNDDSTM32只是网络名字，并不自动成为独立地；当前网表中它实际回到采集板共同GND。HOST GNDD虽然从U6移除了，但不能据此认定带SW2的整体电源连接已通过。

## 当前PYNQ用途的最小修改

以未改变的采集板H5编号为前提：将U6奇数脚恢复为上表“应接网络”，U6全部偶数脚不接线；不向U6引入HOST电源、地及HOST信号。HOST网络仍保留在Pmod U5与ISO7763之间。当前不要求设计STM32模式，SW2的上述兼容分支可不装／取消连接，避免引入供电跨接。

空余隔离器输入固定电平、Pmod封装几何和失电默认状态仍按前次说明待核对。本次没有改写原网表、加载比特流或进行硬件上电。

## 用户澄清换面安装后的复核

用户明确U6换面，因此有意交换针号；PYNQ和STM32不同时使用，本板STM32隔离模式暂不验收。采集板未来可能割地，但当前仍按现有共地网表审查，不把未来割线作为已完成条件。

如果换面后实际逐对交换，隔离板U6的2/4/6/8/10/12/14/16/18脚分别对应采集板H5的1/3/5/7/9/11/13/15/17，则GNDA、DRDY、SCLK、DIN、3V3A、DOUT、CS、START、RESET全部正确。供电去耦和隔离器方向也正确；不需要为满足旧同号假设把已正确的采集列再换回去。换面并不在所有封装下都等价于这个映射，仍应由PCB插接图或实物导通确认。

对当前PYNQ用途，仍需关注以下现存连接：

1. SW2的1—2触点必须断开，否则Pmod3V3D经U6.9→H5.10接原STM32侧3.3V1，两个3.3V电源直接并联。网表没有开关内部触点定义，不能根据外观猜哪一档。
2. 逐对交换后，U6的3/5/7/11/13/15/17仍分别连接原STM32的PA0/PA5/PA7/PA6/PA4/PB0/PB1，也同时接Pmod侧DRDYD/SCLKD/DIND/DOUTD/CSD/STARTD/RESETD。单独使用PYNQ并不会自动断开这些实体连接；现有采集板的STM32电源3.3V1还由自身LDO供电，未必因不接调试器而断电。旧固件的输出配置可能造成争用，这些跨域支路也不能作为完整隔离通过。
3. 如果目前只接采集侧9根、HOST／STM32这一列实际不插接，第二项支路不存在；但此前的全18针插接描述不能直接视作这种情况。PYNQ专用版本最简处理是让U6主机列不接现有STM32，保留其未来封装位置即可。按上述换面映射，应断开的是U6奇数脚的STM32支路，不是采集侧的偶数脚。
4. SW2.4现在为GNDA而非HOST的GNDD；换面后SW2.5经U6.1/H5.2也到采集GND。它不能在未来凭空隔离STM32，但用户已将该功能排除本次范围，暂不要求重设计此模式。

因此可以认可当前采集列连接和电源修正；完整直插组合是否可用，仍以物理映射、开关断开及STM32支路是否确实断开为条件。本次不再以未来STM32隔离功能作为验收门槛，也没有认定整机或实物已经通过。
