rentommy/2026-fpga-dual-channel-ecg/report/history/netlist_review_power_2026-10-23.md

# 采集板LDO使能开关更新检查

> 历史检查：用户后续已在隔离板移除STM32信号支路及电源桥，最新PYNQ专用连接检查通过，见[简化版复查](netlist_review_pynq_2026-10-23.md)。下文问题描述仅针对保留支路的旧版。

日期：2026-10-23。依据最新采集板与隔离板网表；按用户说明，暂只评估PYNQ，不要求STM32隔离模式。连接器按换面后逐对奇偶交换理解，实际几何仍须确认。原始网表未改动。

## 已修正的电源控制

| 采集板开关 | 控制 | 连接 |
|---|---|---|
| SW2 | U6/ADC电源LDO | 1脚GND，2脚ENA→U6.3，3脚+5V |
| SW3 | U7/STM32电源LDO | 1脚GND，2脚END→U7.3，3脚+5V |

若所选开关2脚为公共端，上述接法可以明确将EN置高／置低。TPS7A20 DBV封装3脚确为EN，1脚IN仍接+5V，2脚GND、5脚OUT连接未改变。新增开关能关闭稳压器，却不等于断开所有对外连接。

## 尚未解决的信号支路

隔离板HOST信号经完整18针插接仍连到原STM32：

| HOST网络 | 隔离板U6脚 | 采集板H5脚 | 原STM32引脚 |
|---|---:|---:|---|
| DRDYD | 3 | 4 | PA0 |
| SCLKD | 5 | 6 | PA5 |
| DIND | 7 | 8 | PA7 |
| DOUTD | 11 | 12 | PA6 |
| CSD | 13 | 14 | PA4 |
| STARTD | 15 | 16 | PB0 |
| RESETD | 17 | 18 | PB1 |

关闭采集板SW3后，这些脚仍实体相连，不能按断开的高阻隔离端处理。尤其PA0等标准I/O可能因高于未供电VDD的输入发生电流注入，无法据此保证无反向供电、无异常负载或完整隔离。不能把所有GPIO都笼统按相同保护结构判断，但一个未断开的非容忍支路就足以否定“关LDO即可安全”的结论。

另据TPS7A20手册，关断时输出有典型150Ω到地放电通路，并不是保证开路。若隔离板SW2某档连通1—2，Pmod3.3V仍会接到采集板STM32侧3.3V1／被关断LDO的输出；关掉U7不能替代断开这条桥。注意隔离板SW2与采集板SW2是两块板上的不同器件。

## 当前用途的最小处理

保留新增EN开关。使用PYNQ时，采集板ADC电源SW2开启，STM32电源SW3关闭；同时物理断开表中7条通往STM32的支路，隔离板SW2的HOST／STM32电源桥保持断开。这些开关状态只有配合断开支路才可作为测试准备条件，单独按此拨档尚未通过。

可在采集板H5的4/6/8/12/14/16/18脚与STM32之间设置7个可拔跳帽或可断0Ω连接；PYNQ模式全部断开，将来仅STM32模式再恢复。也可在隔离板U6对应奇数脚支路断开，保留HOST网络在Pmod与ISO7763之间。按换面后的映射，采集侧仍接U6偶数脚，不需改正确的采集信号。

当前不用为了STM32模式割地。只割共地也不能替代断开GPIO和电源支路。修改后需重新导出网表，并确认Pmod封装／两板对接及断电导通检查，再进行不接人体的供电、芯片ID和ADC内部测试信号验证。没有实际通电测量，不据网表宣布整机安全。

参考：[TI TPS7A20引脚及关断放电说明](https://www.ti.com/lit/ds/symlink/tps7a20.pdf#page=4)、[ST STM32F103C8数据手册（I/O电压及注入限制）](https://www.st.com/resource/en/datasheet/stm32f103c8.pdf)。原始网络和文件哈希见同名JSON。
