rentommy/2026-fpga-dual-channel-ecg/report/history/pcb_layout_review_2026-10-25.md

# 采集板 PCB 布局检查（2026-10-25）

## 结论与范围

当前版本不建议直接下单。首先修正 C10 钽电容极性，然后重新布局 BQ25883 与 TPS62163 的局部电源回路。主要问题是器件极性和开关回路几何布局，不能由“网表连接正确”推导为可直接生产。

已读取两张用户截图、完整 EPRO2 工程及最新 Gerber ZIP。工程有 5 个 PCB 文档，采用 updateTime 最新的 PCB1，UUID `c212a40e71cdadd9`。Gerber 的生成时间为 22:11:22，原始工程保存稍晚，二者按元件位置和引脚网络交叉核对。没有修改用户原理图或 PCB。

这是源数据、制造文件及视觉审阅，**未在嘉立创 EDA 中执行原生 DRC、ERC 或全板连通性检查**。自建 Gerber 预览不是生产级 CAM 校验，不能作为无短路、无开路的证明。项目内 TXT 网表仍为较早版本，PB12 与 R38 的最新结论采用 PCB 工程和 Gerber 飞针数据。

## 必须优先修改

### P1：C10 钽电容极性接反

- 元件型号 `CA45-A035K105T`，1 μF / 35 V，CASE-A。
- 工程符号 `376d72e42755a61e` 中“＋”标记位于 1 脚一侧；1 脚为正极，2 脚为负极。
- 最新 PCB 的 PAD_NET：`C10.1 = GND`，`C10.2 = VCAP1`。这与正极应接 VCAP1 的方向相反。
- 修正为 **C10.1 → VCAP1，C10.2 → AVSS/GND**。从原理图修改、同步 PCB 并重新布线，不能仅旋转 PCB 元件（旋转不改变编号对应的网络）。核对贴装极性标记。
- 之前只按节点连接审阅，没有展开该器件的内部极性映射；本轮修正此前“只需确认极性”的未决项。

### P1：BQ25883 U10 的关键电容与电流回路需要重排

数据来自工程坐标与走线，单位为 mil，换算系数 0.0254 mm/mil。

| 对象 | 当前证据 | 修改方向 |
|---|---|---|
| C48 自举电容 | BTST 网络走线段合计约 9.56 mm，使用内层 15（InnerLayer1），两端换层；没有贴在 12 脚附近 | 放到 12 脚旁，同面、短线连接 BTST 与 SW，减少整个自举回路 |
| C47 PMID 电容 | 在芯片上方，PMID 通过底层绕到电感；网络细线为 10 mil | 紧贴 21/22 脚和芯片功率地，使输入高频回路短而宽 |
| C44/C45 SYS 电容 | SYS 引脚到电容方向存在约数毫米细长连接；两电容在芯片上方 | 紧靠 15/16 脚，电容地到芯片地与 EP 的回路同样缩短 |
| L2 与 SW | SW 走线为 10 mil，未形成紧凑电源连接 | 电感靠近 17/18 脚；用足够宽、尽量短的连接，避免扩大 SW 铜面积 |
| C49 REGN | REGN 网络走线段合计约 5.96 mm | 4.7 μF 电容靠近 11 脚，优先缩短电容去耦支路；TS 偏置支路另行引出 |

注意：网络长度是各线段合计，不是任意两点之间的唯一路径长度，不包含所有焊盘内路径与层间长度。

参考 BQ25883 数据手册第 74 页：布局优先级依次强调 SYS 电容、PMID 电容、SW 电感连接、同面邻近去耦及 EP 接地散热。单纯加宽现有绕路线，不能替代重新摆放关键器件。

### P1：TPS62163 U9 的电感及输出反馈路径需要优化

- U9 SW（7 脚）至 L3 的网络 `$2N127` 约 4.6 mm，宽度仅 10 mil。
- L3 放在 U9 上方，中间还有 R38、其他连接等；SW 应直接到邻近电感，避免细长开关节点。
- C50 位于 U9 下方，可进一步靠近 VIN/PGND，保证回路短而宽。
- C51 应与 L3 输出端、PGND 形成紧凑输出回路。
- VOS（6 脚）当前沿公共输出连接支路接入，不是从 C51 正端单独引出的短采样支路。改为从输出电容正端引回，避开 SW 与电感。
- 保留 H1：输出电容与 VOS 必须留在 H1 的稳压器侧，不能因开跳帽而断开反馈。

参考 TPS62163 数据手册第 26 页 Layout Guidelines。

## 后续优化与确认

### P2：主电源走线以 10 mil 为主

- BAT、SYS（网络名 8V）、PMID，以及降压开关连接中存在较长的 10 mil 线；USB 5V 部分有 20 mil 段，但芯片附近及接口分支仍有 10 mil 段。
- 当前 R39 为 383 Ω，硬件输入限流上限典型约 2.87 A。不能默认这些线满足最高输入能力的压降、温升要求。
- 重新布局时，电源主干使用更宽走线或局部铜皮；芯片细脚短距离扇出后立即加宽。最终宽度根据最大实际电流、铜厚与允许温升确定，不能把 SW 铺成大面积天线。

### 待验证：ADS1292 模拟区禁铜（经 TI 官方资料复核，撤回原先的强制修改建议）

- Gerber 四层及工程 REGION 显示：左侧模拟区域有大范围禁铜区，延伸进入 ADS1292 部分本体下方。这是观察事实，**不能单凭此事实判定布局错误**。
- 原报告建议“恢复 ADC 芯片下方完整内层 GND”过于确定，未有针对本板回流路径的充分证据。现撤回该强制建议，不再将其列为下单阻断项；也未通过测试证明该区域噪声超标。
- 重新查阅 TI ADS1292 Rev.C 第 66、68、69 页。官方强调：去耦短而近，数字回流避免穿越模拟回流，模拟输入/AVSS 附近避免寄生电容与漏电。第 69 页图 75 标示接地平面/铜皮的过孔以及 AVSS/DGND 的连接示意，但不是逐层铜图，不能据图中空白认定所有层禁铜，也不能认定所有层必须铺地。
- TI 官方评估板指南 SLAU384A 的第 47、48 页图 49/50 是 Top/Bottom Layer Placement（元件放置图），没有展示内层地平面的边界。不能把这两张图当作评估板完整铺铜证据。
- 当前建议：保持现有输入区禁铜方案，后续针对 AVSS、DGND、VREF/VCAP 与供电电容地端逐条检查低阻抗回流。是否局部补地，要由具体路径、输入寄生参数与噪声测试决定，不要求直接填满整个模拟区。
- 资料：<https://www.ti.com/lit/ds/symlink/ads1292.pdf>、<https://www.ti.com/lit/ug/slau384a/slau384a.pdf>。官方指南已保存到 `pcb_review_20261025/TI_SLAU384A.pdf`，第 47/48 页及数据手册图 75 已导出图片供复查。

### P2：C10、C11 与 ADS1292 的距离

- VCAP1 到 C10 的走线段合计约 2.98 mm。
- VCAP2 到 C11 的走线段合计约 5.24 mm，C11 在芯片上方较远处。
- C11 优先移到 U1.27 旁，C10 修正极性时也尽量靠近 U1.11。电容地端就近连接 ADC 安静的地回路。
- TI ADS1292 数据手册第 66～67 页要求参考、VCAP1/2 与供电电容尽量靠近封装。

### P2：NTC 的实际测温位置

R41 位于充电、降压区域附近。若直接焊在该处，测到的更接近板温并受到电源器件发热影响。若目的是电池温度监测，应以引线使 103AT-2 贴近电池；若该焊盘本来就是外接探头连接点，则不需按板载测温理解。

### 制造与隔离边界

- Gerber 有四个铜层；本次提供的钻孔文件只有贯通孔。最新 PCB 的 359 个 VIA 均为 NORMAL，孔径约 12 mil / 铜盘约 24 mil（0.305 / 0.610 mm），未发现使用此前讨论的激光盲孔。
- PCB 的 GND/GND1 分区在四个铜层的预览中均有保留；未发现大块地铜直接跨越边界。该观察不能证明全板没有细线短接，也不是爬电距离、耐压或人体安全认证。
- U10 与 U9 的 EP 下有散热过孔；下单前确认钢网开窗、过孔处理与贴片工艺，避免焊锡损失和空洞。U10 焊盘关闭自动锡膏开窗，但封装另外定义了独立锡膏 FILL，因此不能误判为“没有锡膏开窗”。
- U10 采用通用 EP2.8 封装，应将引脚焊盘、EP、锡膏图形与 TI RGE0024 推荐图逐项核对，不能只凭 4×4 mm 名称确认封装完全匹配。
- 需要在 EDA 重铺铜后执行完整 DRC、未连接检查与原理图同步检查，并提交板厂 DFM。

## 已确认的新修改

- BQ25883 的 /PG 已改接 PB12，并有 3.3 V 上拉；与 TPS62163 PG 分开。
- R38 在最新 PCB 工程中已改为 2 kΩ，旧 TXT 网表仍显示 100 kΩ，因此应重新导出网表。
- 主电源 GND 已统一；USB1 外侧仍为独立 GND1。
- 供电、模拟、数字区域总体有分区，保留该总体结构即可，优先重排局部电源器件，无需先整体推倒重画。

## 建议修改顺序

1. C10 极性从原理图修正并同步 PCB。
2. 重排 U10 + C44/C45/C47/C48/L2/C49，先布高频功率回路。
3. 重排 U9 + C50/L3/C51，并重新引 VOS。
4. 加宽主电源；优化 C10/C11，核对 ADC 地与去耦回流。模拟区禁铜先保留，不按原报告直接补满地平面。
5. 重铺铜、执行原生 DRC、重新导出网表和 Gerber，再做复核。

## 来源与可视化

- 用户原始工程：`采集板/ProPrj_ads1292新_2026-10-25.epro2`
- 用户制造文件：`采集板/Gerber_PCB1_2026-10-25.zip`
- 用户截图：`屏幕截图 2026-10-25 221239.png`、`屏幕截图 2026-10-25 221340.png`
- 用户本地 BQ25883、TPS62163 数据手册。
- TI ADS1292：[官方数据手册](https://www.ti.com/lit/ds/symlink/ads1292.pdf)。
- `pcb_review_20261025/power_routes.png` 为工程走线数据示意，省略铜皮；`four_layers.png` 为 Gerber 辅助预览。
