rentommy/2026-fpga-dual-channel-ecg/report/history/project_progress_2026-10-23.md

# 项目进度与接手结论

更新日期：2026-10-23。本文汇总工作区源码、旧资料、历史协作记录、工具产物及本次真实板上操作；更早的核查快照见 [首次接手报告](project_status_2026-10-22.md)，构建与故障细节见 [实现及上板记录](implementation_2026-10-22.md)。

## 当前做到哪一步

**FPGA 滤波核的最小板上文件回放链路已经跑通，完整心电采集应用尚未闭环。** 现在已能在 PYNQ-Z2 上把文件样本经 DDR 送入 PL 滤波，再将结果读回 PS，与软件参考逐点比较。项目已越过“只有软件仿真／HLS IP”的阶段。

当前没有充分依据给整个作品标一个完成百分比。算法核心与最小硬件链路已有证据，实时采集、显示、推理及竞赛交付仍有明确缺口。

## 作品目标与已有基础

最终目标是“自制 ADS1292／ADS1292R 双通道采集 → PYNQ-Z2 多通道双延迟滤波 → PS 显示、心率／波形指标及模型判读”。现行 PL 核支持八个逻辑通道，每通道两个输出通路；采集芯片的两个模拟通道与 PL 的八个逻辑通道是不同概念。

前期 STM32、隔离与供电电路、香橙派上位机和模型是旧平台基础。旧汇报中的约 499 SPS、七分类准确率 95.19%、约 130 ms 推理等数据没有在当前 PYNQ 平台复测，不能移作新平台实测指标。用户现已补充 `stm32文件/ECG/`，已核查实际编译的 `main.c` 时钟、SPI和ADC配置；完整旧上位机、训练源码和可编辑 PCB 工程仍缺失，不能声称已审核这些缺失源码。

## 已完成及证据

| 部分 | 当前状态与证据 |
|---|---|
| 算法及定点核心 | 现行方案、浮点参考、C++ 核心和顶层测试已检查；已有记录与冲激、工频测试通过 |
| 精确位宽 C 仿真 | Vitis 2026.1 编译 `ap_int.h` 分支，30,034 点 × 八通道通过；复现入口为 `sim/run_csim_2026.tcl` |
| HLS 综合与 IP | 有效 IP 在 `hls_ecg2/hls/impl/ip/`；单DSP入口已整理至 `src/hls/hls_fix.tcl`、`src/hls/hls_export.tcl`，原约束及产物路径保留 |
| Vivado 系统集成 | PS 控制口、DDR 读写通路、SmartConnect、时钟和复位已连接并实现；当前有效工程为 `build/vivado/ecg_overlay_resetfix/ecg_overlay.xpr` |
| 实现时序与资源 | 100 MHz；WNS +0.076 ns、WHS +0.024 ns；LUT 5,208、FF 8,294、DSP 1、BRAM Tile 12.5 |
| 真实板上基本访问 | PYNQ-Z2、PYNQ 3.1.1、Python 3.10.4；bit／hwh 哈希核对通过，控制状态读回 `0x4`，单点零输入八通道双通路全零输出 |
| 完整文件回放 | 500 点和 4096 点分块均通过参考比对；两次全部 `[30034, 8, 2]` 输出逐点完全一致 |
| 本机结果归档 | 板上输出和日志已取回，压缩包哈希及完整性通过；从本机 NPY 重新计算的误差与逐点一致性结果相同 |

实现后的 DRC 无 Error 或 Critical Warning，仍保留六项 DSP 相关 Warning；有时序通过及文件回放通过证据，并不等于没有任何工具警告或异常覆盖缺口。

现行滤波链为温和移位高通、320 点滑动基线估计、两种延迟抽头、50 Hz 陷波及 31 抽头 40 Hz FIR。默认诊断／低延迟通路的冲激峰值在 174／15 点，即 348／30 ms；这是滤波链测试的峰值延迟，不能直接称作含采集、分块、PS 调度和显示的端到端延迟。ch2、ch3 当前两条通路均采用零延迟抽头。

## 本次上板结果

同一份 30,034 点单列记录被复制到八个输入通道，每次回放只在首块复位。跳过前 543 点后，ch0、ch1、ch4、ch5、ch6、ch7 的诊断输出对浮点参考的最大绝对误差为 **3.28984 ADC 码**，RMS 为 **0.698013 码**；两种分块大小的误差相同。ch2、ch3 的 path 0 按设计为低延迟配置，未参与该诊断参考比较。

全部通道、两条通路的两次输出经 `np.array_equal` 检查完全一致，证明这份记录在 500／4096 点分块方式下能正确维持状态。最大单块墙钟时间分别为 6.740013 ms 和 53.397889 ms，包含 PS 轮询等开销，不能作为实时显示延迟。

首次上板曾在控制访问附近卡住。原因是辅助复位默认低电平有效，却接到了地，使总线及滤波核持续复位。现已显式设为高电平有效、保留接地，并增加构建断言；新比特流的控制、单点和完整回放均已通过。旧产物保留于 `board/results/first_reset_fault/`，便于追溯。

板上验证文件位于 `/home/xilinx/jupyter_notebooks/ecg_validation_resetfix_20261022`，已自动保存的 Notebook 为 `ECG_FPGA_ResetFix_Verification_20261022.ipynb`。输出、统计和诊断日志已取回本机，压缩包为 ecg_board_results_resetfix_20261022.zip（原工作区引用：`../board/results/ecg_board_results_resetfix_20261022.zip`，未随此公共候选发布），447,965 字节，已核对 SHA256 并检查 ZIP 完整性；内容解包于 `board/results/resetfix/`。本机 NPY 再次计算得到相同误差，两种分块输出仍逐点一致，记录见 retrieval_receipt.json（原工作区引用：`../board/results/resetfix/retrieval_receipt.json`，未随此公共候选发布）。

板卡系统时钟停留在 2025-05-04，日志时间戳不能作为本次操作的真实日历日期；本次归档取回日期以客户端日期 2026-10-23 为准。

## 还缺什么

| 待办 | 为什么还不能算完成 |
|---|---|
| 满量程／异常边界覆盖 | 已补4096点不同输入、全部八通道单独激励、不规则分块和跨记录复位，20项板上检查通过；仍未覆盖全部满量程／异常情况，详见 [不同通道测试](channel_test_2026-10-23.md) |
| C/RTL 协同仿真 | 尚无成功报告；板上回放提供了硬件证据，但不替代所有 RTL 级覆盖 |
| ADS1292 实时数据接入 | 当前入口是 DDR 文件样本，尚无新平台双导联实时采集与采样完整性证据；PL SPI／配置状态机也未完成 |
| PS 显示、心率与波形指标 | 尚未集成到当前 FPGA 链路；既有 ST／T 评价中固定窗口和标准差／RMS 口径仍需统一 |
| 模型推理与预处理闭环 | 历史训练预处理与当前因果 PL 链不一致，需要恢复原定义并比较或重训；尚无 PYNQ 推理速度与准确率结果 |
| 导联状态、异常处理与恢复 | 尚未实现和验证当前系统的检测、冻结／恢复流程 |
| 独立采集数据 | 现有两段约 60 秒记录来自同一被试并参与过调参，不能代替独立验证数据 |
| 正式复现及竞赛材料 | 需统一有效构建入口、整理技能包、更新报告与论证、制作提交包和要求的海报 |

## 接下来按什么顺序推进

1. 不同通道激励测试已通过，继续补满量程和异常边界覆盖。
2. 用户已选择 SPI 接入，并补充 STM32 源码；已核查原 SPI 时钟562.5kHz、Mode1及单通道采集配置，完成 Pmod A 引脚分配。下一步实现 PL SPI 并验证双通道采样、连续性和导联状态，详见 [接线与时钟核查](ads1292_wiring_2026-10-23.md)。
3. 把显示与基础波形指标接到已验证链路，测量真正的采集到显示延迟。
4. 恢复模型训练预处理定义，解决与 PL 输出的差异，再验证推理及独立数据表现。
5. 统一正式复现入口、技能包及竞赛报告，纠正文档中时分复用、通道扩展估计和延迟口径的过度表述。

当前可以继续接手滤波核、构建、板上驱动与系统集成。后续应围绕实时数据链路和可复现交付推进，不需要无依据重新开始算法选型。
# 本日追加：HDMI 与 Pmod A 版本

已生成并下载 `board/scope/ecg_scope.bit/.hwh`，包含SPI采集FIFO、原滤波器、HDMI波形和按键选择。新版本30034点八通道双通路回放通过，双通道演示各4000点通过，新增AXI/UI读写通过。RTL视频和按键仿真通过；真实采集、物理按键及实体显示器仍待验收，隔离器HOST侧尚未设计、显示器尚未购置。详见 [本次构建验收报告](scope_build_2026-10-23.md) 和 接线运行指南（原工作区引用：`../board/SCOPE_GUIDE.md`，未随此公共候选发布）。
