rentommy/2026-fpga-dual-channel-ecg/report/history/dual_view_acquisition_followup_2026-11-04.md

# 双路显示后续采集排查

用户确认SW0上下分屏正常，电极连接CN2且贴在身上。后续明确确认电源反复断开，供电连接需要现场修复，不能据此判定SPI逻辑本身存在错误。

一次重新初始化后，诊断获得1997点，CH2范围-440050至-409483、标准差约5008码，没有削顶。随后真实采集恢复，服务状态为信号良好、模型推理运行、无丢帧或坏帧。不能将之前的FLAT_OR_CLIPPED状态直接描述为当前输入持续饱和。

修复了独立的显示增益问题：自动增益只参考当前选中输入通道的两条路径，避免未使用的另一输入压缩屏幕上波形。两条路径仍共用相同增益。通过极端未接通道干扰的离线验证：CH1输入7000000码、CH2正弦10000码时，CH2显示仍有超过200像素峰峰值。

作为通信对照测试，将SPI分频设置为199，即250kHz，ADC采样率仍为500Hz。该降速不能证明或排除电源故障，也不是修复电源的方法。用户最终确认电源老断，停止继续通过软件参数归因。

记录片段：PID7645在约29秒时采集14066点，显示约29.55次/秒，overruns=0、bad_frames=0、双路开启。短时正常不等于长期稳定验证通过。

源文件及部署包已更新，板端保留scope_runtime.py.before_channel_gain及scope_runtime.py.before_spi_slow备份。需待现场固定供电后，再验证连续采集和实际HDMI波形。

## 用户固定供电后复查

用户回复“好了”后进行了约30秒连续状态观察。同一PID7645的运行时间从174.5秒增长至204.2秒，累计样点从86640增长至101474，overruns=0、bad_frames=0，双路显示开启，显示更新约27次/秒，推理进程存活、error=null。最初状态为NO_RELIABLE_RR，随后连续三次状态均为GOOD/TRACKING，估算心率分别74.5、78.2、78.8次/分，累计分类数持续增长至115。板端数据与分析已恢复；这次复查窗口约30秒，不能描述成固定供电后的长时间稳定性验证。
