rentommy/2026-fpga-dual-channel-ecg/report/history/ecg_export_2026-11-04.md

# 真实心电数据导出（2026-11-04）

用户要求将本次最新已获得的较好心电数据整理到 `D:/ecg_fpga/模型训练/采集`。导出的是此前已保存的CN2/CH2及CN4/CH1真实电极测试数据；自启动服务没有保存全部连续波形，因此没有将重启后的实时样本计入本次导出，也没有中断采集服务获取新数据。

## 交付

目录：`模型训练/采集/2026-11-04_真实心电_已保存记录/`，下分板端原始文件、有效通道完整记录、优选连续片段、波形与质量、复现与说明。另有采集根目录README及会话内详细README。

| 记录 | 完整样本数 | 标称时长 | 优选索引（左闭右开） | 优选标称区间 |
|---|---:|---:|---|---|
| CN2/CH2，最新 | 11890 | 23.780秒 | [2250,7250) | 4.5～14.5秒 |
| CN4/CH1，RLD修正后 | 11889 | 23.778秒 | [1000,6000) | 2～12秒 |

标称500 Hz；各优选窗5000点、10秒，是完整记录的子集，不能重复计数。ADC码、电压、保真与快速路径分别保存；只有实际接电极的通道进入训练候选目录，悬空通道仅在原始双通道备份中保留。并未赋予“正常心律”或疾病标签。

筛选排除前2秒、后0.5秒，0.5秒步进比较10秒窗口的原始工频、高频能量、滤波后慢漂移、反向异常偏移及削顶，并人工查看图像。首次算法选择的CN4窗口末尾存在明显短时干扰，经图像检查后加强瞬态筛选，最终选2～12秒；未改动原始采样或拼接心拍。CN2原始优选窗49～51Hz能量占比38.15%，CN4为1.86%；两段滤波图均有清楚尖峰，但不能把原始CN2称为低工频干扰数据。

## 完整性及重放验证

板端ZIP为262642字节，SHA256 `5c85a0e97a33fb0b33227516d540dfa85debad549641a34d068fef696f8a1099`，包内每文件哈希通过。浏览器文件下载未正常触发，使用已加载图像附件的PNG元数据承载同一ZIP，经浏览器资源导出后恢复，恢复后ZIP哈希与板端完全一致；原始文件字节未变。

完整滤波输出由当前项目定点C++模型重放生成，未冒充整段板端直接保存输出；与每次已保存的板端末4秒（2000点×2通道×2路径）逐码比较，最大误差0。CN2最后绘制比原始结束早6点，CN4早5点，已明确定位。原始数据、电压换算、名义延迟174/15点和参考输出性质在README说明。

`board/verify_exported_ecg.py`验证37个文件哈希、完整记录23779点、两个片段共10000点、来源连续索引及CSV/NPZ一致性，通过。`board/export_saved_ecg.py`保留生成与筛选流程；SHA256清单不包含其自身。

用户在此前明确确认自行重启后正常运行。导出时新boot ID及后台服务已核实，见 `report/standalone_2026-11-04.md`。板卡墙钟不正确，本报告使用客户端日期；精确采集时刻未知。
