rentommy/2026-fpga-dual-channel-ecg/report/history/netlist_review_pynq_2026-10-23.md

# PYNQ专用简化隔离板网表复查

> 2026-10-25更新：本文记录此前数字隔离接口的连接检查通过。采集板后来新增BQ25882／TPS62163电源，目前发现GND2与负载GND未连接等问题，整板最新状态请看[电源复查](acquisition_power_review_2026-10-25.md)，不能将本文的数字接口结论扩大为新整板已验收。

日期：2026-10-23。用户取消当前STM32兼容分支，重新提供隔离板网表。本报告替代此前关于保留STM32支路版本的待修改清单；历史报告原样保留。

## 结论

**PYNQ专用数字接口连接检查通过。** 当前四个VCC／去耦正确，U6全部奇数脚未接网络，主机侧只接Pmod，采集侧只接U6偶数脚，原STM32信号支路和SW2电源桥已移除。

该结论以用户说明的U6换面后逐对奇偶交换为条件（U6.2→H5.1、U6.4→H5.3，依此类推），并不代替封装图或实际导通验证。Pmod U5的CAD焊盘号也应按现有编号转换表确认插接面。

## 当前U6连接

| 隔离板U6脚 | 网络 | 换面后对应采集板H5脚 |
|---:|---|---:|
| 2 | GNDA | 1 |
| 4 | DRDY | 3 |
| 6 | SCLK | 5 |
| 8 | DIN | 7 |
| 10 | 3V3A | 9 |
| 12 | DOUT | 11 |
| 14 | CS | 13 |
| 16 | START | 15 |
| 18 | PWDN/RESET | 17 |

U6的1/3/5/7/9/11/13/15/17脚均未出现在任何网络。即使18针机械插接，未接线的这些焊盘也不会把HOST电源、地和信号连回原STM32。无需为本次PYNQ用途再割开采集板GND，或依赖关闭原STM32电源来避免争用。

## 已核对

- U1/U2 Side1的VCC1直接接3V3A，GND1接GNDA；Side2的VCC2直接接3V3D，GND2接GNDD。
- C1/C3及C2/C4共四个100nF分别跨接正确侧的电源与地。
- DIN、SCLK、CS、START、RESET经过Side2→Side1隔离；DRDY、DOUT经过Side1→Side2隔离，方向正确。
- 主机侧七根信号及电源／地仍到Pmod U5，与现有比特流规划一致；没有STM32支路或SW2电源桥。
- 当前网表中没有由连接器引入的HOST地／电源回接采集侧的直接路径。

## 下一步

可以按此连接进入PCB封装／布线检查。先确认两块连接器实际针号对应及隔离边界铜皮，之后不接人体进行电源电压、ADS1292 ID、寄存器回读、内部测试信号与DRDY检查。网表通过不等于已经测得真实通信或确认整机人体使用安全。

用户称采集板电源已改回；检查时磁盘上的采集板TXT仍有SW2/SW3、ENA/END。此差异需与最终原理图／导出文件同步，但已不影响本版隔离板消除STM32支路的判断。ADC侧仍须正常供电。

未使用隔离输入的外部偏置、上电及失电默认输出、实际器件／封装和电气时序仍按既有设计说明确认，本次未另增STM32模式需求。未修改原始网表，未通电或运行板卡。文件哈希及逐项结果见同名JSON。
