rentommy/2026-fpga-dual-channel-ecg/report/history/netlist_review_2026-10-23_v2.md

# 第二版隔离网表复查

> 历史版本：用户再次更新网表后，U6奇偶列交换并增加SW2，最新检查见[第三版复查](netlist_review_2026-10-23_v3.md)。下文仅描述第二版。

日期：2026-10-23。用户明确当前只单独使用PYNQ或STM32，暂不要求本隔离板兼容STM32隔离；本次不增加双主机切换功能要求。

依据重新读取的 `隔离板/spi隔离_2026-10-23.txt` 和未改变的 `采集板/ADS1292_2026-10-23.txt`。第二版隔离网表SHA256：`5bde77b80edc0084ae34cd728968898971917afb2cd80e7dc83e4e65f7f0cc2c`。原始文件未修改；机器可读核查结果在同名v2 JSON中。

## 已修正

- U1/U2的1脚直接接3V3A、16脚直接接3V3D，已有正常直流供电连接。
- C1/C3从3V3A到GNDA，C2/C4从3V3D到GNDD，四个100nF已改为电源对地去耦。
- 七根信号方向保持正确，Side1=采集侧、Side2=PYNQ侧。

此前报告中的“VCC经串联电容供电”只适用于第一版，已在本版解决。

## 仍须修正：整排插接的电气连接不受软件使用方式影响

用户此前确认隔离板U6与采集板H5同号直接对插。当前第二版仍有：

```text
GNDA → U6.1 → H5.1 → 采集板同一个GND → H5.2 → U6.2 → GNDD
```

即便不运行STM32，两个地仍由铜线连通，ISO7763信号隔离被旁路。

另外，U6.10=3V3D仍接H5.10=STM32侧3.3V1，因此PYNQ 3.3V接到原板LDO输出。单独使用PYNQ不保证STM32真正断电，反而可能由这条线反向给原STM32电源网供电。偶数脚信号也仍接到PA4/PA5/PA7/PB0/PB1等原主机引脚；不应仅依赖“没打算使用”判定这些脚不会驱动。

## 满足当前用途的最小修改

**保留隔离板U6所有奇数脚原连接，将U6全部偶数脚从现有HOST网络断开。** 可继续用18针连接器，但偶数焊盘不接线、不铺到HOST网络。

| U6脚 | 从该脚移除的网络 | 移除后 |
|---:|---|---|
| 2 | GNDD | NC |
| 4 | DRDYD | NC |
| 6 | SCLKD | NC |
| 8 | DIND | NC |
| 10 | 3V3D | NC |
| 12 | DOUTD | NC |
| 14 | CSD | NC |
| 16 | STARTD | NC |
| 18 | RESETD | NC |

这里是移除“U6引脚与网络的连接”，不是删除整个HOST网络：这些信号继续连接ISO7763与Pmod U5；GNDD继续连接ISO7763的9脚、Pmod地及本侧去耦；3V3D继续连接ISO7763的16脚、Pmod3.3V及本侧去耦。

这样原STM32仅留在采集侧，不用改STM32固件，也不需要本版实现STM32隔离或双主机切换。采集侧仍由H5奇数脚提供ADC信号、地及3.3VD；PYNQ侧只接Pmod。

## 其余边界

Pmod U5焊盘号与标准Pmod针号的几何对应仍需封装图确认。空余隔离输入固定电平、主机上电偏置及失电默认状态的建议仍保留，但本次没有扩大为STM32兼容设计。未修改比特流、未运行真实ADC或执行硬件上电。
