rentommy/2026-fpga-dual-channel-ecg/src/rtl/ecg_wave_video.sv

// 640x480 at 60 Hz with a 25.2-MHz pixel clock. BRAM holds four waveform banks:
// bank = channel*2+path, each column packs {y_max[9:0], y_min[9:0]}.
module ecg_wave_video(
    input wire bus_clk, wave_we, label_we, hud_we,
    input wire [11:0] wave_addr,
    input wire [19:0] wave_data,
    input wire wave_write_bank, frame_request,
    output reg frame_active,
    input wire pixel_clk, pixel_resetn,
    input wire [2:0] selection,
    input wire dual_view,
    input wire [1:0] display_flags,
    output reg [23:0] rgb,
    output reg hsync, vsync, de
);
    (* ram_style="block" *) reg [19:0] wave_mem0 [0:2559];
    (* ram_style="block" *) reg [19:0] wave_mem1 [0:2559];
    // Each column carries {glyph-relative pixel x[3:0], ASCII[7:0]}.
    // Local phase permits one-pixel motion independent of screen text cells.
    (* ram_style="block" *) reg [11:0] label_mem0 [0:2559];
    (* ram_style="block" *) reg [11:0] label_mem1 [0:2559];
    // HUD column = {colour[1:0], vertical bitmap[15:0]}, same frame bank.
    (* ram_style="block" *) reg [17:0] hud_mem0 [0:639];
    (* ram_style="block" *) reg [17:0] hud_mem1 [0:639];
    integer k;
    initial for(k=0;k<2560;k=k+1) begin
        wave_mem0[k]={10'd260,10'd260};
        wave_mem1[k]={10'd260,10'd260};
        label_mem0[k]=0;label_mem1[k]=0;
    end
    integer h;
    initial for(h=0;h<640;h=h+1) begin hud_mem0[h]=0;hud_mem1[h]=0;end
    always @(posedge bus_clk) if(hud_we && wave_addr<640) begin
        if(wave_write_bank)hud_mem1[wave_addr]<=wave_data[17:0];
        else hud_mem0[wave_addr]<=wave_data[17:0];
    end
    always @(posedge bus_clk) if(label_we && wave_addr<2560) begin
        if(wave_write_bank) label_mem1[wave_addr]<=wave_data[11:0];
        else label_mem0[wave_addr]<=wave_data[11:0];
    end
    always @(posedge bus_clk) if(wave_we && wave_addr<2560) begin
        if(wave_write_bank) wave_mem1[wave_addr]<=wave_data;
        else wave_mem0[wave_addr]<=wave_data;
    end
    (* ASYNC_REG="TRUE" *) reg request_meta, request_sync;
    (* ASYNC_REG="TRUE" *) reg [5:0] ui_meta, ui_sync;
    reg [5:0] ui_frame;
    reg [9:0] hx, vy, x1, y1;
    reg hs1, vs1, de1;
    reg [19:0] column0, column1;
    reg [11:0] label0,label1;
    wire [11:0] beat_label=frame_active?label1:label0;
    reg [17:0] hud0,hud1;
    wire [17:0] hud=frame_active?hud1:hud0;
    reg [7:0] ascii_row;
    wire [19:0] column=frame_active?column1:column0;
    wire path_select=ui_frame[5]?(vy<260):ui_frame[1];
    wire [11:0] bank_base = (ui_frame[0] ? 12'd1280 : 12'd0) + (path_select ? 12'd640 : 12'd0);
    wire [11:0] ram_addr = bank_base + ((hx<640)?hx:10'd0);
    wire [9:0] lo=ui_frame[5]?((column[9:0]>>1)+((y1<260)?10'd40:10'd220)):column[9:0];
    wire [9:0] hi=ui_frame[5]?((column[19:10]>>1)+((y1<260)?10'd40:10'd220)):column[19:10];
    reg [23:0] color;
    reg [15:0] character, bits_row;
    integer ci, cr, cc;
    `include "ecg_chinese_font.vh"
    `include "ecg_chinese_labels.vh"
    `include "ecg_font.vh"
    always @* begin
        color=24'h070d17;
        character=" "; bits_row=0;ascii_row=0;ci=0;cr=0;cc=0;
        if(y1>=80 && y1<440) begin
            if(x1%80==0 || (y1-80)%40==0) color=24'h233447;
            if(ui_frame[5]?(y1==170 || y1==350):(y1==260)) color=24'h40526a;
            if(ui_frame[5] && y1==260) color=24'h90b5dc;
            if(y1>=lo && y1<=hi) color=ui_frame[0]?24'h30d5ff:24'h43f296;
        end
        if(((y1>=84 && y1<100) || (ui_frame[5] && y1>=264 && y1<280)) && beat_label[7:0]!=0) begin
            ascii_row=font_row(beat_label[7:0],((y1<260?y1-84:y1-264))>>1);
            if(ascii_row[7-beat_label[11:9]]) color=24'hffd166;
        end
        if(ui_frame[5] && x1>=8 && x1<136 && ((y1>=104 && y1<120)||(y1>=284 && y1<300)))begin
            ci=(x1-8)>>4;cr=(y1<260)?y1-104:y1-284;cc=(x1-8)&15;
            case(ci)
            0:character=(y1<260)?16'h5b9e:16'h4fdd;
            1:character=(y1<260)?16'h65f6:16'h771f;
            default:character=16'h0020;
            endcase
            bits_row=chinese_font_row(character,cr[3:0]);
            if(bits_row[15-cc])color=(y1<260)?24'h56e3ba:24'hffd166;
            if(ci>=3)begin
                case(ci)
                3:character="3";
                4:character=(y1<260)?"0":"4";
                5:character=(y1<260)?"m":"8";
                6:character=(y1<260)?"s":"m";
                7:character=(y1<260)?" ":"s";
                default:character=" ";
                endcase
                ascii_row=font_row(character[7:0],cr>>1);
                if(ascii_row[7-(cc>>1)])color=24'h90b5dc;
            end
        end
        if(y1>=64 && y1<80) begin
            color=24'h070d17;
            if(hud[15-(y1-64)])begin
                case(hud[17:16])
                1:color=24'h56e3ba;
                2:color=24'hffd166;
                3:color=24'hff657a;
                default:color=24'heaf2ff;
                endcase
            end
        end
        if(x1>=16 && x1<624 && y1>=16 && y1<32) begin
            ci=(x1-16)>>4; cr=y1-16;cc=(x1-16)&15;
            character=heading(ci,ui_frame[2:0]);bits_row=chinese_font_row(character,cr[3:0]);
            if(bits_row[15-cc]) color=24'heaf2ff;
        end
        if(x1>=16 && x1<528 && y1>=44 && y1<60) begin
            ci=(x1-16)>>4; cr=y1-44;cc=(x1-16)&15;
            character=subtitle(ci,ui_frame[4:3]);bits_row=chinese_font_row(character,cr[3:0]);
            if(bits_row[15-cc]) color=ui_frame[3]?24'hffd166:24'h90b5dc;
        end
        if(x1>=16 && x1<624 && y1>=460 && y1<476) begin
            ci=(x1-16)>>4; cr=y1-460;cc=(x1-16)&15;
            character=footer(ci);bits_row=chinese_font_row(character,cr[3:0]);
            if(bits_row[15-cc]) color=24'h90b5dc;
        end
    end
    always @(posedge pixel_clk) begin
        ui_meta<={dual_view,display_flags,selection};ui_sync<=ui_meta;
        request_meta<=frame_request;request_sync<=request_meta;
        column0<=wave_mem0[ram_addr];
        column1<=wave_mem1[ram_addr];
        label0<=label_mem0[ram_addr];label1<=label_mem1[ram_addr];
        hud0<=hud_mem0[(hx<640)?hx:10'd0];hud1<=hud_mem1[(hx<640)?hx:10'd0];
        if(!pixel_resetn) begin
            hx<=0;vy<=0;x1<=0;y1<=0;hs1<=1;vs1<=1;de1<=0;
            rgb<=0;hsync<=1;vsync<=1;de<=0;
            ui_meta<=0;ui_sync<=0;ui_frame<=0;
            request_meta<=0;request_sync<=0;frame_active<=0;
        end else begin
            // Change the displayed buffer and UI only after active video ends.
            // The acknowledged buffer remains read-only for the entire frame.
            if(hx==0 && vy==480) begin
                frame_active<=request_sync;
                ui_frame<=ui_sync;
            end
            if(hx==799) begin hx<=0;vy<=(vy==524)?0:vy+1;end else hx<=hx+1;
            x1<=hx;y1<=vy;
            hs1<=!(hx>=656 && hx<752);vs1<=!(vy>=490 && vy<492);
            de1<=(hx<640 && vy<480);
            rgb<=de1?color:24'd0;hsync<=hs1;vsync<=vs1;de<=de1;
        end
    end
endmodule
