rentommy/2026-fpga-dual-channel-ecg/(commit log)

2026-10-12 Add files via upload
    添加项目结构、基础滤波验证函数文件、指标验证脚本
2026-10-12 第一次提交
2026-10-12 更新说明文档
2026-10-12 添加注释
2026-10-16 添加evaluate_chains.py注释
2026-10-19 更新滤波链路
2026-11-04 Organize complete ECG project sources, documentation and posters for submission
    [bom_20261026.xlsx, per_beat_fpga_results.csv]
